eSpark-Backup/christian-raun-ethercat-design/Documents/Dev-Files/Blueprint/Reference Block Diagram.jpg

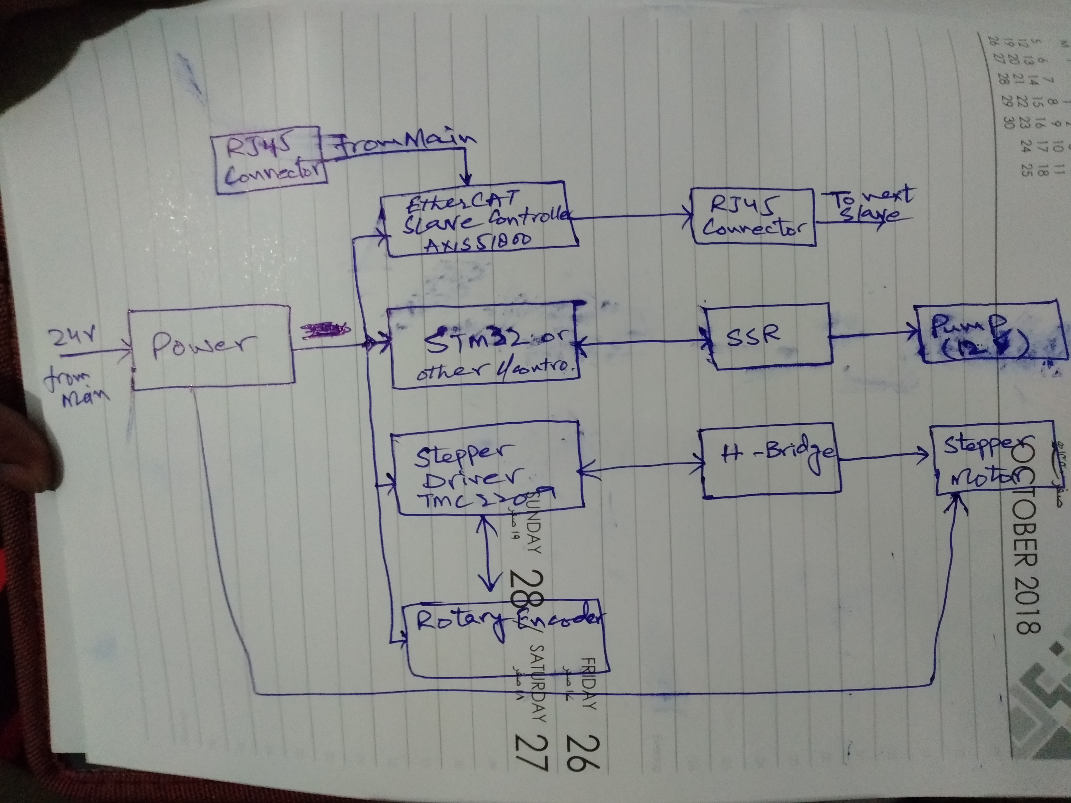
Documents/Dev-Files/Blueprint/Reference Block Diagram.jpg
