eSpark-Backup/christian-raun-ethercat-design/Deliverables/Control_Board/Renderings/3D_Top_View.PNG

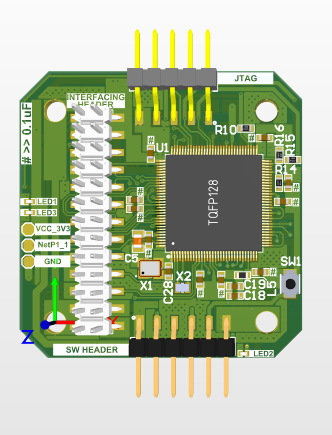
Deliverables/Control_Board/Renderings/3D_Top_View.PNG
