eSpark-Backup/christian-raun-ethercat-design/README.md

# ChrisitanRaun-AnnanasMotor
 To modify existing STM32 CAN Bus Stepper Control Firmware from Annanas Stepper Motor Design

 ## Board Status Document
 https://docs.google.com/spreadsheets/d/1jbGswmWFq8PR_c_Gmjap0uz8ZMgcLZeeRxeEXOKYWH0/edit#gid=0
