eSpark-Backup/christian-raun-ethercat-design/Documents/Dev-Files/Library Design Notes.txt

VKME1452A101MV 3D body required.
Diode 3D body remaining (download issue) resolved
