eSpark-Backup/christian-raun-ethercat-design/Documents/PCB review_ControlBoard/PCB Review_Mars_3-10-2021.docx

Issue No. 1:

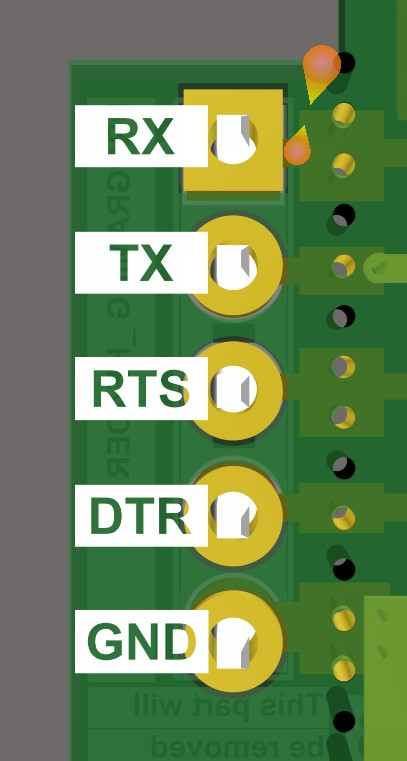
[picture p6: figure]

Reduce size of text as it is overlapping on copper are of pads of header. See attached image.

Issue No. 2:

Reduce the size of logo. See highlighted area in below image.

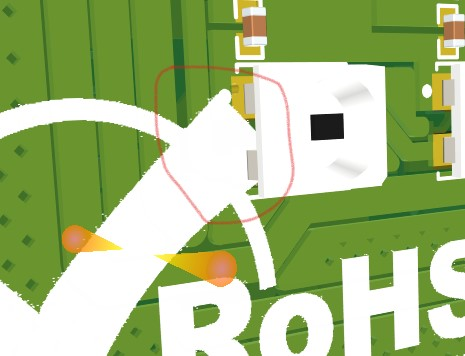
[picture p7: figure]

Issue No. 3:

Remove extra Mechanical layers (Mechanical 13 and Mechanical 15).
