eSpark-Backup/christian-raun-ethercat-design/Documents/Dev-Files/EtherCAT Based Servo Control System - Research.docx

# EtherCAT Based Servo Control System

# OVERVIEW of EtherCATP:

- EtherCAT is fully compliant with Ethernet standards, with 100Mbps transfer speed and good synchronization. It is widely used in the industrial field, such as the servo control system, robots, and numerical control machine tool. However, it has a high installation cost and poor reliability due to the usage of multiple power supplies and communication cables.
- The EtherCAT P technology is an addition to EtherCAT, which can enable the standard 4-wire Ethernet cable to transmit not only data but also two electrically isolated power supplies.
- It consists of two isolated power supplies; the system control power supply Us and the peripheral actuator power supply. Nominal voltage is 24V and current can be up to 3A.
- It is different from the Power over Ethernet (PoE), where only one voltage can be transmitted. Two separate power voltages can improve the safety of the system, which is good for industrial applications.
- EtherCAT slaves need specialized EtherCAT slave controllers (ESC), such as ET1100 and LAN9252.

The physical layer can use standard Ethernet devices directly. For example, the transport medium usually uses class 5 UTP wires of the 100base-TX specification.

# Hardware Design:

- the hardware design of the physical layer of EtherCAT is the same as Ethernet physical layer structure, which consists of a network control transceiver, network transformer, and RJ45.
- The hardware design uses two 2nd order filter elements and isolation via ethernet transformer.
- Main parts of the hardware include
1. EtherCAT Section
2. Control Section
3. Drive Section

# Components:

- MagJack: HY931147C $3.15,

48F-03GYD2NL: $2.6

HR915310A: $1.6

- Ethernet Transceiver: LAN8700C-AEZG-TR

DP83822HRHBR: $5.3

- TMC8462 EtherCAT slave controller IC with EtherCAT P
- Motion controller TMC4361
- MCU
- Stepper driver TMC5130 (with integrated MOSFET driver stage)

IR2102SPBF: Half-Bridge Gate Driver IC

- EtherCAT P M8 connectors for EtherCAT LINK IN and LINK OUT connection.
- single SPI isolator IC for isolation between system and driver part
- Encoder feedback
- EEPROM: CAT24C256WI-GT3: $0.3
- Optocoupler for isolation between control and drive circuit: HCPL-4504-500E https://www.lcsc.com/product-detail/SMD-Optocouplers_AVAGO_HCPL-4504-500E_HCPL-4504-500E_C17130.html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

# Reference link:

- https://www.researchgate.net/publication/351994896_Design_of_the_Servo_Control_System_Based_on_EtherCAT_P
- https://www.ti.com/lit/an/spracm9b/spracm9b.pdf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
- https://iopscience.iop.org/article/10.1088/1742-6596/1924/1/012009/pdf
- https://training.ti.com/ethercat-protocol-ethercat-slave-overview
- https://www.ti.com/tool/TIDA-00299
- https://www.ti.com/tool/TIDM-02006
- https://www.trinamic.com/support/help-center/reference-designs/tmc8462-with-ethercat-p/
- Hardware Data Sheet ET1100: https://download.beckhoff.com/download/document/io/ethercat-development-products/ethercat_et1100_datasheet_v1i9.pdf
- › XMC4800 family of MCU: price on digikey $26

https://www.infineon.com/dgdl/Infineon-Peripheral+-+EtherCAT+Slave+Controller+(ECAT)-TR-v01_00-EN.pdf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

Kit: https://www.digikey.com/en/products/detail/infineon-technologies/KIT_XMC47_RELAX_V1/5725043

EtherCAT slave controller: https://www.microchip.com/en-us/product/LAN9252

# XMC4700:

- XMC4700 reference design
- KSZ8081RNDCA-TR: Ethernet transceiver $1.26
- Debugging header: FTSH-105-01-F-D-K $2.43
- Resources of KIT_XMC47_RELAX_V1 (https://www.infineon.com/cms/en/product/evaluation-boards/kit_xmc47_relax_v1/)
- XMC4700 Documents (https://www.infineon.com/cms/en/product/microcontroller/32-bit-industrial-microcontroller-based-on-arm-cortex-m/32-bit-xmc4000-industrial-microcontroller-arm-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)
- Infineon/mtb-example-xmc-ccu8-pwm-complementary (https://github.com/Infineon/mtb-example-xmc-ccu8-pwm-complementary)
- https://github.com/Infineon/mtb-example-xmc-empty-app

# Comparison Between AMIC And XMC

## AMIC:

- Up to 300-MHz Sitara™ ARM® Cortex® -A8 32-Bit RISC Processor
- Two MII Ethernet Ports that Support Industrial Ethernet, such as EtherCAT
- Up to Two USB 2.0 High-Speed DRD (DualRole Device) Ports With Integrated PHY
- Up to Two Industrial Gigabit Ethernet MACs (10,100, 1000 Mbps) Integrated Switch. Each MAC Supports MII, RMII, RGMII, and MDIO Interfaces
- Ethernet MACs and Switch Can Operate Independent of Other Functions
- Has 2 CAN, 6 UART, 3 I2C, 2 SPI and 4 banks of GPIO (each bank has 32 gpios), – Eight 32-Bit General-Purpose Timers, Three Enhanced High-Resolution PWM Modules
- 12-Bit Successive Approximation Register (SAR) ADC
- Available Package: – 324-Pin S-PBGA-N324 Package

## XMC:

- ARM Cortex-M4 processor core
- Ethernet MAC module capable of 10/100 Mbit/s transfer rates
- EtherCATSlave interface (ECAT) capable of 100 Mbit/s transfer rates with 2 MII ports, 8 Fieldbus Memory Management Units (FMMU), 8 Sync Manager, 64-bit distributed clocks
- Universal Serial Bus, USB 2.0 host, Full-Speed OTG, with integrated PHY
- Controller Area Network interface (MultiCAN), Full-CAN/Basic-CAN with 6 nodes, 256 message objects (MO), data rate up to 1 MBaud
- Six Universal Serial Interface Channels (USIC), providing 6 serial channels, usable as UART, double-SPI, quad-SPI, IIC, IIS and LIN interfaces
- Four Analog-Digital Converters (VADC) of 12-bit resolution, 8 channels each, with input out-of-range comparators

# Other MCU options:

AM3352BZCE30 $6-15 (different price on different sites)

R5F572MNDDBG#20 ($17-23)

LAN9255-I/ZMX019 (https://ww1.microchip.com/downloads/en/DeviceDoc/00003646B.pdf) ($17)

The LAN9255 is a System-In-Package (SIP) design that combines the Microchip LAN9253 2/3-port EtherCAT device controller with dual integrated Ethernet PHYs and the Microchip SAM E53J ARM Cortex-M4F MCU into a single 128- pin TQFP package.

EVAL board (https://www.microchip.com/en-us/products/high-speed-networking-and-video/ethernet/ethercat-slave-controllers)

file:///D:/eSpark/Docs/EVB-LAN9255-Users-Guide-50003106.pdf
