eSpark-Backup/christian-raun-ethercat-design/Documents/Dev-Files/Graphical outline.pdf

Flex Mold – Software Interface

Boot | Home | Projects

Settings

Accesories | Laser

Motors

Project A | Panel A
Project B | Panel A2

Vacuum

Power

Heater

Boot

# Flex Mold

### Grøn Innovation

Home

Top navigation bar

Side selection bar | Content

Home | Settings | Accesories Projects
System status | Machines information (Size, motor count, etc.)

Power status

Motor status

Emergency stop status

Vacuum status

Heater status

Laser status

Projects

Home | Settings | Accesories Projects

Project A

Project B

Project C

Panel A

Panel B

Panel C

Panel A

Motor max travel

Travel time – 1 min 20 sec Set new Travel time – seconds

Shape | Home Stop

Home | Settings | Accesories Projects

Size

Minimum Radius

Motor count

Parts produced

Time in operation

Machine info

Power status

Motor status

Vacuum status

Home | Settings | Accesories Projects

### 24 Volt power status

240 Volt power status

Machines information

Power status

Motor status

Vacuum status

Home | Settings | Accesories Projects

Motor count

Motor errors

Machines information

Power status

Motor status

Vacuum status

Home | Settings | Accesories Projects

Vacuum on/off

Vacuum pressure

Machines information

Power status

Motor status

Vacuum status

Home | Settings | Accesories Projects

Power on/off

Temperature current

Temperature set

Temperature time

Heater status

Laser status

Home | Settings | Accesories Projects

Laser on/off

Calibrate

Calibrate value

Callibration errors

Heater status

Laser status
