eSpark-Backup/christian-raun-ethercat-design/Deliverables/Control_Board/Renderings/2D_Bottom_View.PNG

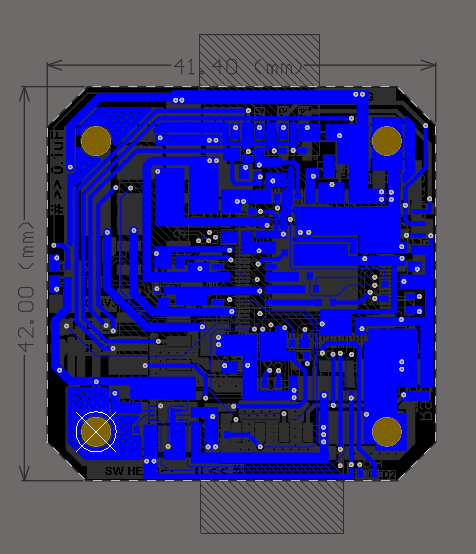
Deliverables/Control_Board/Renderings/2D_Bottom_View.PNG
