eSpark-Backup/christian-raun-ethercat-design/Deliverables/Control_Board/Renderings/2D_Top_View.PNG

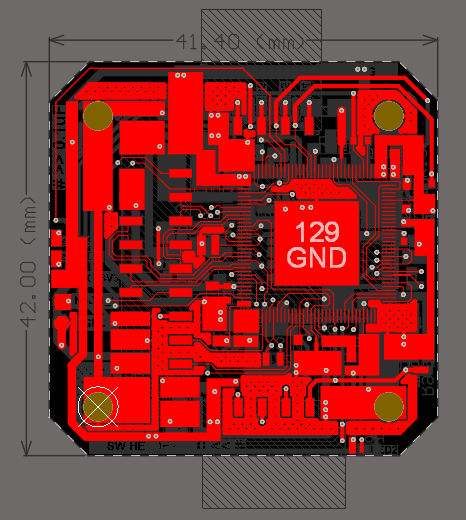
Deliverables/Control_Board/Renderings/2D_Top_View.PNG
