eSpark-Backup/christian-raun-ethercat-design/Deliverables/Control_Board/Renderings/3D_C_View.PNG

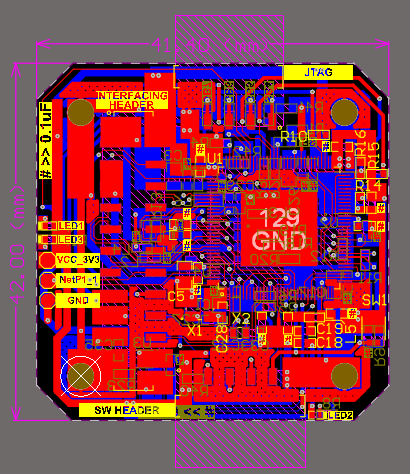
Deliverables/Control_Board/Renderings/3D_C_View.PNG
