eSpark-Backup/christian-raun-ethercat-design/Deliverables/Control_Board/Renderings/3D_Isometric_View.PNG

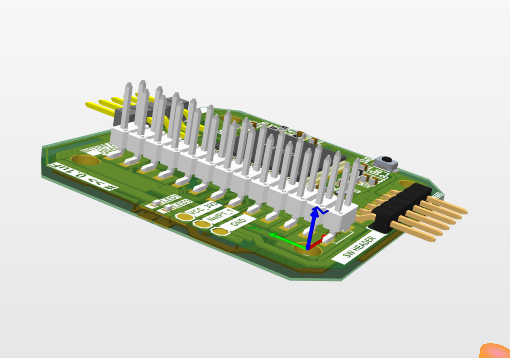
Deliverables/Control_Board/Renderings/3D_Isometric_View.PNG
