eSpark-Backup/christian-raun-ethercat-design/Deliverables/Interface_Board/Renderings/2D_Bottom_View.PNG

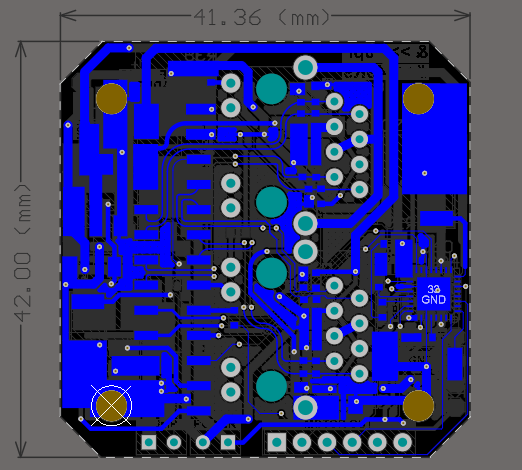
Deliverables/Interface_Board/Renderings/2D_Bottom_View.PNG
