eSpark-Backup/christian-raun-ethercat-design/Deliverables/Interface_Board/Renderings/3D_Bottom_View.PNG

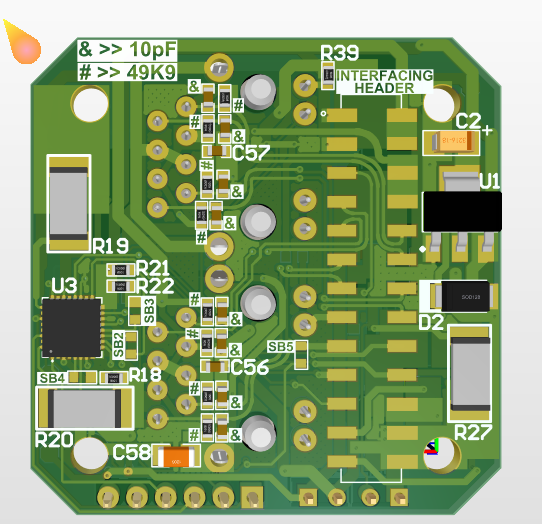
Deliverables/Interface_Board/Renderings/3D_Bottom_View.PNG
