eSpark-Backup/christian-raun-ethercat-design/Deliverables/Interface_Board/Renderings/3D_Top_View.PNG

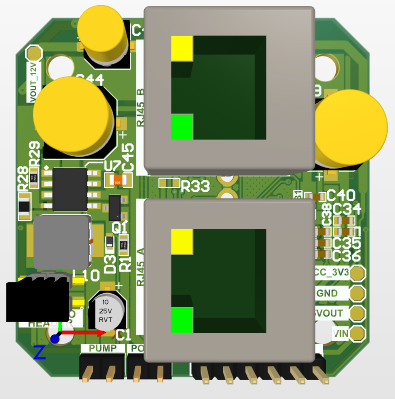
Deliverables/Interface_Board/Renderings/3D_Top_View.PNG
