eSpark-Backup/christian-raun-ethercat-design/Documents/Dev-Files/Blueprint/Blueprints Of Christian.jpg

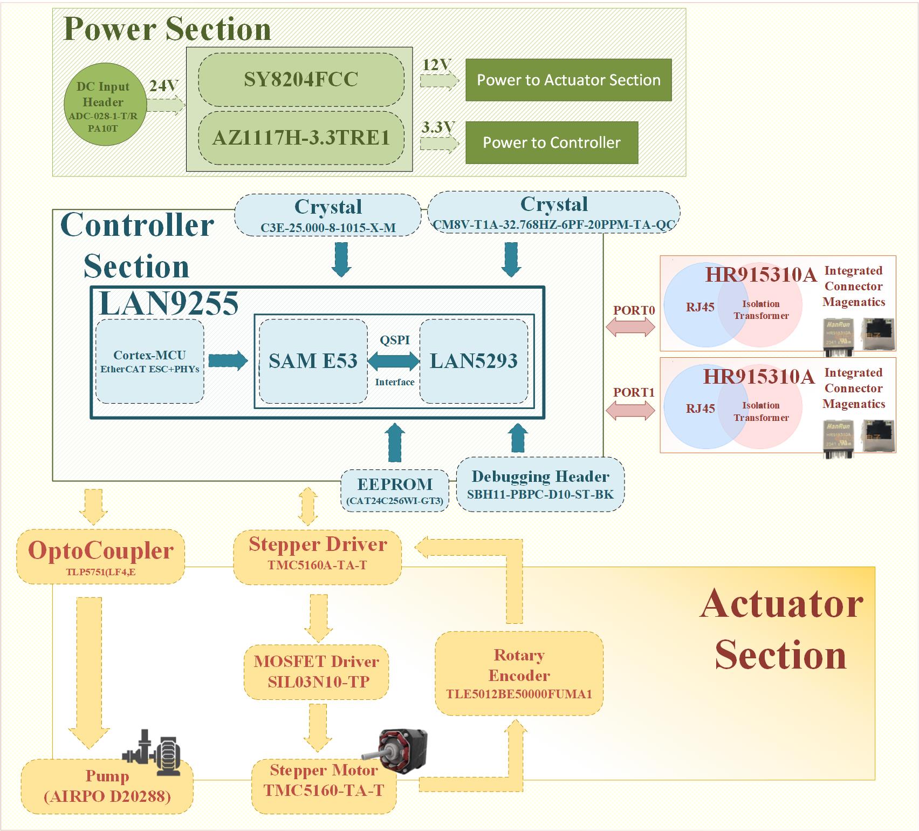
Documents/Dev-Files/Blueprint/Blueprints Of Christian.jpg
