eSpark-Backup/christian-raun-ethercat-design/Documents/PCB review_ControlBoard/1.jpg

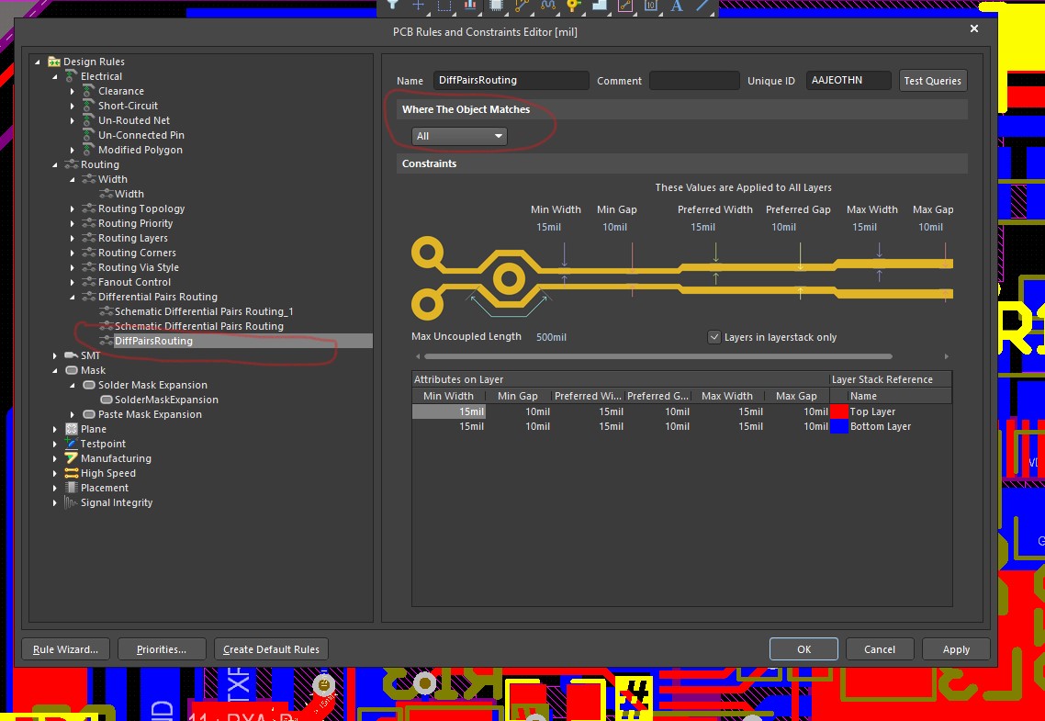
Documents/PCB review_ControlBoard/1.jpg
