eSpark-Backup/christian-raun-ethercat-design/Deliverables/BOM/Digikey_BOM.xlsx

Bill of Material (BOM) for Refrence Formate
S. No. | Components | Description | Designator | Footprint (Package) | Manufacturer Part Number | Manufacturer | Alternate | Value | Quantity 1 | Quantity (400) | Link | Unit Price (400) | Total Cost(400) | Remarks
1 | Capacitor | CAP CER 1UF 100V X7S 0805 | C1, C3, C5, C26, C45 | Cap0805 | GCM21BC72A105KE36L | Murata | -------- | 1uF | 5 | 2000 | Digikey (https://www.digikey.com/en/products/detail/murata-electronics/GCM21BC72A105KE36L/6606065) | $0.1415 | $283.0400
2 |  | CAP CER 0.1UF 100V X7R 0603 | C2, C4, C6, C7, C8, C9, C10, C11, C12, C13, C14, C15, C16, C20, C21, C22, C23, C24, C25, C30, C31, C34, C35, C37, C40, C41 | Cap0603 | CC0603KRX7R0BB104 | YAGEO | -------- | 0.1uF | 26 | 10400 | Digikey (https://www.digikey.com/en/products/detail/yageo/CC0603KRX7R0BB104/3476111) | $0.0327 | $340.5400
3 |  | CAP CER 10UF 50V X5R 0805 | C17 | Cap0805 | GRM21BR61H106ME43L | Murata | GRM21BR61H106KE43L | 10uF | 1 | 400 | Digikey (https://www.digikey.com/en/products/detail/murata-electronics/GRM21BR61H106KE43L/10326316) | $0.1587 | $63.4800
4 |  | CAP CER 4.7UF 25V X5R 0603 | C18, C19, C29, C39 | Cap0603 | C1608X5R1E475M080AC | TDK | -------- | 4.7uF | 4 | 1600 | Digikey (https://www.digikey.com/en/products/detail/tdk-corporation/C1608X5R1E475M080AC/3648583) | $0.0903 | $144.5120
5 |  | CAP CER 10PF 50V C0G/NP0 0603 | C27, C28, C32, C33, C48, C49, C50, C51, C52, C53, C54, C55 | Cap0603 | 06035A100JAT2A | KYOCERA AVX | -------- | 10pF | 12 | 4800 | Digikey (https://www.digikey.com/en/products/detail/kyocera-avx/06035A100JAT2A/563273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) | $0.0110 | $52.7400
6 |  | CAP CER 0.022UF 100V X7R 0603 | C36, C56, C57 | Cap0603 | CGA3E2X7R2A223K080AA | TDK | -------- | 22nF | 3 | 1200 | Digikey (https://www.digikey.com/en/products/detail/tdk-corporation/CGA3E2X7R2A223K080AA/2443292) | $0.0208 | $24.9960
7 |  | CAP CER 2.2UF 50V X5R 0603 | C38 | Cap0603 | UMK107BBJ225MA-T | Taiyo Yuden | -------- | 2.2uF | 1 | 400 | Digikey (https://www.digikey.com/en/products/detail/taiyo-yuden/UMK107BBJ225MA-T/7403937) | $0.1024 | $40.9600
8 |  | 25V 5mm 10mm 100uF 100kHz SMD,5x10mm Aluminum Electrolytic Cap- SMD ROHS | C43 | Custom | VKMB1001E101MV |  | -------- | 100uF | 1 | 400 |  |  | $0.0000
9 |  | 63V 10mm 8mm 100uF ±20% ,8x10mm Aluminum Electrolytic Cap | C44, C79 | Custom | VKMD1001J101MV |  |  | 100uF | 2 | 800 |  |  | $0.0000
10 |  | CAP ALUM 10uF 25V SMD | C46 | Custom | RVT1E100M0405 |  |  | 10uF | 1 | 400 |  |  | $0.0000
11 |  | 10V 22uF -55℃~+125℃ 6Ω 100kHz ±10% CASE-A_3216 Tantalum Capacitors ROHS | C47 | Cap Case-A | CA45A-A-10V-22uF-K |  |  | 22uF | 1 | 400 |  |  | $0.0000
12 |  | CAP CER 1000PF 2KV X7R 1206 | C58 | Cap1206 | CC1206KKX7RDBB102 | YAGEO | C1206C102MGRACTU | 1000pF | 1 | 400 | Digikey (https://www.digikey.com/en/products/detail/kemet/C1206C102MGRACTU/1090964) | $0.3572 | $142.8800
13 | Diode | 36V 40V Unidirectional 75V 5A SOD-323 TVS ROHS | D1 | SOD-323 | SD36 |  |  | ----- | 1 | 400 |  |  | $0.0000
14 |  | DIODE SCHOTTKY 30V 3A CFP5 | D2 | SOD-128 | PMEG3030EP,115 | Nexperia | ---------- | ----- | 1 | 400 | Digikey (https://www.digikey.com/en/products/detail/nexperia-usa-inc/PMEG3030EP-115/2228693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) | $0.3077 | $123.0800
15 |  | SOD-523 Schottky Barrier Diodes (SBD) ROHS | D3 |  | MSK4010 |  |  | ----- | 1 | 400 |  |  | $0.0000
16 | Mosfet | MOSFET N-CH 20V 4.2A SOT23 | Q1 | SOT-23 | IRLML2502TRPBF | INFINEON | ---------- | ----- | 1 | 400 | Element 14 (https://sg.element14.com/infineon/irlml2502pbf/mosfet-n-chan-20v-4-2a-sot-23/dp/9102981?CMP=GRHB-OCTOPART) | $0.5992 | $239.6800
17 | LED | Green 520~535nm 0402 Light Emitting Diodes (LED) RoHS | LED1, LED2 | LED 0402 | 16-213/GHC-YR1S1/3T | QT Brightek | QBLP595-IG-2897 | ----- | 2 | 800 | Digikey (https://www.digikey.com/en/products/detail/qt-brightek-qtb/QBLP595-IG-2897/14664264) | $0.1128 | $90.2240
18 | Inductor | 200Ω @ 100MHz 1 1A 300mΩ 0603 Ferrite Beads | L1, L2, L3, L4, L5 | Ind 0603 | MLB1608-201P1A(f) | Würth Elektronik | 742792651 | ----- | 5 | 2000 | Digikey (https://www.digikey.com/en/products/detail/w%C3%BCrth-elektronik/742792651/1638997) | $0.1340 | $268.0000
19 |  | IND SMD 10uH 500mA 0805 | L6 | Ind0805 | MGFL2012F100MT-LF |  |  | ----- |  | 400 |  |  | $0.0000
20 |  | FIXED IND 33UH 2.5A 189.2MOHM SM | L10 | Custom | ETQ-P4M330YFN | Panasonic | ---------- | ----- | 1 | 400 | Mouser (https://eu.mouser.com/ProductDetail/Panasonic/ETQ-P4M330YFN) | $0.9410 | $376.4000
21 | Resistor | RES SMD 10K OHM 5% 1/10W 0603 | R1, R2, R3, R4, R5, R9, R14, R15, R16, R18, R23, R24, R25, R41, R42 | Res0603 | AC0603JR-0710KL | YAGEO | ---------- | 10K | 15 | 600 | Digikey (https://www.digikey.com/en/products/detail/yageo/AC0603JR-0710KL/2827830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) | $0.0097 | $5.8200
22 |  | RES SMD 0603 33 Ohm 1% 1/10W | R6, R11, R12 | Res0603 | RC0603FR-0733RL | YAGEO | RMCF0603FT33R0 | 33R | 3 | 1200 | Digikey (https://www.digikey.com/en/products/detail/stackpole-electronics-inc/RMCF0603FT33R0/1760804) | $0.0031 | $3.6600
23 |  | RES SMD 330R 100 mW 0603 | R7, R36, R39 | Res0603 | RC0603JR-07330RL | YAGEO | ---------- | 330R | 3 | 1200 | Digikey (https://www.digikey.com/en/products/detail/yageo/RC0603JR-07330RL/726769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) | $0.0036 | $4.3200
24 |  | RES SMD 1K OHM 1% 1/10W 0603 | R8, R10, R21, R22, R29, R40 | Res0603 | RC0603FR-071KL | YAGEO | ---------- | 1K | 6 | 2400 | Digikey (https://www.digikey.com/en/products/detail/yageo/RC0603FR-071KL/726843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) | $0.0044 | $10.4640
25 |  | RES SMD 12.1K OHM 1/10W 0603 | R13 | Res0603 | RT0603CRD0712K1L | Stackpole | ---------- | 12.1K | 1 | 400 | Digikey (https://www.digikey.com/en/products/detail/stackpole-electronics-inc/RMCF0603FT12K1/1761240) | $0.0068 | $2.7200
26 |  | RES SMD ±5% ±200ppm/℃ 0.18Ω 1W 2512 | R19, R20 | RES 2512 | RTT25R18JTE | TE Connectivity | RL73H3AR18FTE | 180m | 2 | 800 | Digikey (https://www.digikey.com/en/products/detail/te-connectivity-passive-product/RL73H3AR18FTE/5588302) | $0.2003 | $160.2560
27 |  | RES 0.075 OHM 1% 2W 2512 | R27 | RES 2512 | CSRN2512FK75L0 | Stackpole | ---------- | 75m | 1 | 400 | Digikey (https://www.digikey.com/en/products/detail/stackpole-electronics-inc/CSRN2512FK75L0/1646109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) | $0.2150 | $86.0000
28 |  | RES SMD 9kΩ ±100ppm/℃ 0.125W 0805 | R28 | Cap0805 | 0805W8F9001T5E |  |  | 9K | 1 | 400 |  |  | $0.0000
29 |  | Res Thick Film 1.6 x 0.8 mm 49.9K Ohm 1% 0.1W(1/10W) 100ppm/ C Molded SMD Paper T/R | R30, R31, R32, R33, R34, R35, R37, R38 | Res0603 | RC0603FR-0749K9L | Stackpole | RMCF0603FG49K9 | 49K9 | 8 | 3200 | Digikey (https://www.digikey.com/en/products/detail/stackpole-electronics-inc/RMCF0603FG49K9/1714078) | $0.0026 | $8.4480
30 | Switch | SWITCH TACTILE SPST-NO 0.05A 12V | SW1 | Custom | B3U-1000P |  |  |  | 1 | 400 |  |  | $0.0000
31 | Ics | IC ETHERCAT SLAVE CONTROLLER | U1 |  | LAN9255/ZMX019 |  |  |  | 1 | 900 |  |  | $0.0000
32 |  | IC EEPROM 256KBIT I2C 1MHZ 8SOIC | U2 | 8-SOIC | CAT24C256WI-GT3 | onsemi | ---------- | ----- | 1 | 400 | Quest Component (https://www.questcomp.com/shopping/shoppingcart.aspx) | $0.1680 | $67.2000
33 |  | Stepper Motor Driver/Controller, 5V to 36V, 1 to 256 Microsteps, 1.2A, QFN-32 | U3 | 32-QFN (5x5) | TMC2202-WA-T | Trinamic | ---------- | ----- | 1 | 400 | Mouser (https://eu.mouser.com/ProductDetail/Trinamic/TMC2202-WA-T) | $2.0100 | $804.0000
34 |  | MAGNETIC ANGLE SENSOR | U4 | 8-SOIC | TLE5012BE5000FUMA1 | Infineon | ---------- | ----- | 1 | 400 | Avnet (https://www.avnet.com/shop/us/products/infineon/tle5012be5000fuma1-3074457345639706863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) | $2.5160 | $1006.4000
35 |  | IC TRANSLATION TXRX 5.5V 24TSSOP | U5 | 24-TSSOP | SN74LVCH8T245PWR | Texas | ---------- | ----- | 1 | 400 | Digikey (https://www.digikey.com/en/products/detail/texas-instruments/SN74LVCH8T245PWR/1216675) | $1.0233 | $409.3120
36 |  | 2A 40V SOIC-8_EP_150mil DC-DC Converters ROHS | U7 |  | XL4001E1 | ---------- | ---------- | ----- | 1 | 400 | Alibaba (https://www.alibaba.com/product-detail/New-Integrated-Circuit-XL4001E1-in-stock_1600251950180.html) | $2.4500 | $980.0000
37 |  | 15V 1.3V @ 800mA Fixed 3.3V SOT-223 Linear Voltage Regulators (LDO) ROHS | U8 |  | AZ1117CH-3.3TRG1 |  |  |  | 1 | 400 |  |  | $0.0000
38 | Crystal | CRYSTAL 25.0000MHZ 8PF SMD | X1 |  | C3E-25.000-8-1015-X-M |  |  |  | 1 | 400 |  |  | $0.0000
39 |  | Crystal 32.768KHZ 6.0PF SMD | X2 |  | CM8V-T1A-32.768KHZ-6PF-20PPM-TA-QC |  |  |  | 1 | 400 |  |  | $0.0000
40 |  | CONN HEADER VERT 10POS 2.54MM | P2 | HDR2X5 | 67997-410HLF | Amphenol | ---------- | ----- | 1 | 400 | Digikey (https://www.digikey.com/en/products/detail/amphenol-icc-fci/67997-410HLF/1878475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) | $0.2158 | $86.3200
42 | Connector | CONN HEADER VERT 2POS 2.54MM | P12, P15 | HDR1X2 | 826629-2 | TE Connectivity | ---------- | ----- | 2 | 800 | Digikey (https://www.digikey.com/en/products/detail/te-connectivity-amp-connectors/826629-2/1130753) | 0.27306 | $218.4480
43 |  | 2.54mm Straight 1 Header TH ,P=2.54mm Pin Headers ROHS | P13 | HDR1X5 | MTP125-1105S1 | Wurth Elektronik | 61300511121 |  | 1 | 400 | Mouser (https://eu.mouser.com/ProductDetail/Wurth-Elektronik/61300511121) | $0.2600 | $104.0000
44 |  | Solder Bridge ON | SB1, SB2, SB3, SB4, SB5, SB6, SB7 | Solder Bridge | Solder Bridge |  |  |  | 7 | 2800 |  |  | $0.0000
45 |  | Test Point ON | P1, P3, P4, P5, P6, P7 | TEST POINT | TEST POINT |  |  |  | 6 | 2400 |  |  | $0.0000
