eSpark-Backup/christian-raun-ethercat-design/Deliverables/Control_Board/BOM/LCSC_CB_ 500.xlsx

Bill of Material (BOM) for Controller Board
S. No. | Components | Description | Designator | Footprint (Package) | Manufacturer Part Number | Manufacturer | LCSC Part No | Alternate | Value | LCSC/MOQ (1000) | LCSC/MOQ (500) | Quantity (Per Board) | Quantity 500 | Quantity 1000 | Link | Unit Cost(1) | Total Cost(1) | Unit Cost(500) | MOQ Total 500 | Unit Cost(1000) | MOQ Total 1000 | Remarks | Quotation of orignal parts from Chinese supplier
1 | Capacitor | CAP CER 1UF 100V X7S 0805 | C1, C3, C5, C26 | Cap0805 | GCM21BC72A105KE36L | Murata | C2842838 | ------------ | 1uF | 4050 | 2050 | 4 | 2000 | 4000 | LCSC (https://www.lcsc.com/product-detail/old-batch_Murata-Electronics-GCM21BC72A105KE36L_C2842838.html) | $0.0682 | $0.2728 | $0.0682 | $139.8100 | $0.0682 | $276.2100
2 |  | CAP CER 0.1UF 100V X7R 0603 | C2, C4, C6, C7, C8, C9, C10, C11, C12, C13, C14, C15, C16, C20, C21, C22, C23, C24, C25, C30, C31, C34, C35, C41 | Cap0603 | CC0603KRX7R0BB104 | YAGEO | C113803 | ------------ | 0.1uF | 24050 | 12050 | 24 | 12000 | 24000 | LCSC (https://www.lcsc.com/product-detail/Multilayer-Ceramic-Capacitors-MLCC-SMD-SMT_YAGEO-CC0603KRX7R0BB104_C113803.html) | $0.0079 | $0.1896 | $0.0051 | $61.4550 | $0.0051 | $122.6550
3 |  | CAP CER 10UF 50V X5R 0805 | C17 | Cap0805 | ~~GRM21BR61H106ME43L~~ | Murata | C440198 | GRM21BR61H106KE43L | 10uF | 1050 | 550 | 1 | 500 | 1000 | LCSC (https://www.lcsc.com/product-detail/Multilayer-Ceramic-Capacitors-MLCC-SMD-SMT_Murata-Electronics-GRM21BR61H106KE43L_C440198.html) | $0.1052 | $0.1052 | $0.0670 | $36.8500 | $0.0670 | $70.3500
4 |  | CAP CER 4.7UF 25V X5R 0603 | C18, C19, C29 | Cap0603 | ~~C1608X5R1E475M080AC~~ | TDK | C76615 | C1608X5R1E475KT000E | 4.7uF | 3050 | 1550 | 3 | 1500 | 3000 | LCSC (https://www.lcsc.com/product-detail/Multilayer-Ceramic-Capacitors-MLCC-SMD-SMT_TDK-C1608X5R1E475KT000E_C76615.html) | $0.03470 | $0.1041 | $0.0216 | $33.4800 | $0.0216 | $65.8800
5 |  | CAP CER 10PF 50V C0G/NP0 0603 | C27, C28, C32, C33 | Cap0603 | ~~06035A100JAT2A~~ | KYOCERA AVX | C106245 | CC0603JRNPO9BN100 | 10pF | 4100 | 2100 | 4 | 2000 | 4000 | LCSC (https://www.lcsc.com/product-detail/Multilayer-Ceramic-Capacitors-MLCC-SMD-SMT_YAGEO-CC0603JRNPO9BN100_C106245.html) | $0.0025 | $0.0100 | $0.0019 | $3.9900 | $0.0018 | $7.3800
6 | LED | Green 520~535nm 0402 Light Emitting Diodes (LED) RoHS | LED1, LED2,LED3 | LED 0402 | 16-213/GHC-YR1S1/3T | Everlight Elec | C74338 | ------------ | ----- | 3050 | 1550 | 3 | 1500 | 3000 | LCSC (https://www.lcsc.com/product-detail/Light-Emitting-Diodes-LED_Everlight-Elec-16-213-GHC-YR1S1-3T_C74338.html) | $0.0681 | $0.2043 | $0.0457 | $70.8350 | $0.0457 | $139.3850
7 | Inductor | 200Ω @ 100MHz 1 1A 300mΩ 0603 Ferrite Beads | L1, L2, L3, L4, L5 | Ind 0603 | MLB1608-201P1A(f) | Meled | C45316 | ------------ | ----- | 5050 | 2550 | 5 | 2500 | 5000 | LCSC (https://www.lcsc.com/product-detail/Ferrite-Beads_Meled-MLB1608-201P1A-f_C45316.html) | $0.0070 | $0.0350 | $0.0050 | $12.7500 | $0.0047 | $23.7350
8 |  | IND SMD 10uH 500mA 0805 | L6 | Ind0805 | MGFL2012F100MT-LF | microgate | C281113 | ------------ | ----- | 1050 | 550 | 1 | 500 | 1000 | LCSC (https://www.lcsc.com/product-detail/Inductors-SMD_microgate-MGFL2012F100MT-LF_C281113.html) | $0.0458 | $0.0458 | $0.0341 | $18.7550 | $0.0322 | $33.8100
9 | Resistor | RES SMD 10K OHM 5% 1/10W 0603 | R1, R2, R3, R4, R5, R9, R14, R15, R16, R23, R41, R42 | Res0603 | AC0603JR-0710KL | YAGEO | C140867 | ------------ | 10K | 12100 | 6100 | 12 | 6000 | 12000 | LCSC (https://www.lcsc.com/product-detail/Chip-Resistor-Surface-Mount_YAGEO-AC0603JR-0710KL_C140867.html) | $0.0014 | $0.0168 | $0.0010 | $6.1000 | $0.0009 | $10.8900
10 |  | RES SMD 0603 33 Ohm 1% 1/10W | R6, R11, R12 | Res0603 | RC0603FR-0733RL | YAGEO | C108661 | ------------ | 33R | 3100 | 1600 | 3 | 1500 | 3000 | LCSC (https://www.lcsc.com/product-detail/Chip-Resistor-Surface-Mount_YAGEO-RC0603FR-0733RL_C108661.html) | $0.0014 | $0.0042 | $0.0010 | $1.6000 | $0.0009 | $2.7900
11 |  | RES SMD 330R 100 mW 0603 | R7 | Res0603 | RC0603JR-07330RL | YAGEO | C105879 | ------------ | 330R | 1100 | 600 | 1 | 500 | 1000 | LCSC (https://www.lcsc.com/product-detail/Chip-Resistor-Surface-Mount_YAGEO-RC0603JR-07330RL_C105879.html) | $0.0014 | $0.0014 | $0.0014 | $0.8400 | $0.0011 | $1.2100
12 |  | RES SMD 1K OHM 1% 1/10W 0603 | R8, R10, R40,R17 | Res0603 | RC0603FR-071KL | YAGEO | C22548 | ------------ | 1K | 4100 | 2100 | 4 | 2000 | 4000 | LCSC (https://www.lcsc.com/product-detail/Chip-Resistor-Surface-Mount_YAGEO-RC0603FR-071KL_C22548.html) | $0.0012 | $0.0048 | $0.0009 | $1.8900 | $0.0009 | $3.6900
13 |  | RES SMD 100 OHM 1% 1/10W 0603 | R18, R19 | Res0603 | RC0603FR-07100RL | YAGEO | C105588 | ------------ | 100R | 2100 | 1100 | 2 | 1000 | 2000 | LCSC (https://lcsc.com/product-detail/Chip-Resistor-Surface-Mount_YAGEO-RC0603FR-07100RL_C105588.html) | $0.0012 | $0.0024 | $0.0009 | $0.9900 | $0.0009 | $1.8900
14 |  | RES SMD 470 OHM 1% 1/10W 0603 | R20 | Res0603 | RC0603FR-07470RL | YAGEO | C114669 | ------------ | 470R | 1100 | 600 | 1 | 500 | 1000 | LCSC (https://lcsc.com/product-detail/Chip-Resistor-Surface-Mount_YAGEO-RC0603FR-07470RL_C114669.html) | $0.0015 | $0.0015 | $0.0015 | $0.9000 | $0.0012 | $1.3200
15 |  | RES SMD 12.1K OHM 1/10W 0603 | R13 | Res0603 | RT0603CRD0712K1L | Stackpole | C705893 | ------------ | 12.1K | 1040 | 540 | 1 | 500 | 1000 | LCSC (https://www.lcsc.com/product-detail/Chip-Resistor-Surface-Mount_YAGEO-RT0603CRD0712K1L_C705893.html) | $0.0137 | $0.0137 | $0.0106 | $5.7240 | $0.0100 | $10.4000
16 | Switch | SWITCH TACTILE SPST-NO 0.05A 12V | SW1 | Custom | B3U-1000P | Omron | ------------ | ------------ | ----- | 1050 | 550 | 1 | 500 | 1000 | LCSC (https://www.lcsc.com/product-detail/span-style-background-color-ff0-Tactile-span-Switches_G-span-style-background-color-ff0-Switch-span-GT-TC026B-H015-L1_C778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) | $0.0855 | $0.0855 | $0.0481 | $26.4550 | $0.0481 | $50.5050
17 | Ics | IC ETHERCAT SLAVE CONTROLLER | U1 | 128-TQFP (14x14) | LAN9255/ZMX019 | Microchip | -------- | ---------- | ----- | 1010 | 510 | 1 | 500 | 1000 | Custom supplier | $21.26 | $21.2600 | $21.26 | $10842.6000 | $21.26 | $21472.6000
18 |  | IC EEPROM 256KBIT I2C 1MHZ 8SOIC | U2 | 8-SOIC | CAT24C256WI-GT3 | onsemi | ------------ | ------------ | ----- | 1010 | 510 | 1 | 500 | 1000 | Chipmall (https://www.chipmall.com/product_detail/ON-Semiconductor/EEPROM/CAT24C256WI-GT3_8340.html) | $0.3524 | $0.3524 | $0.2872 | $146.4572 | $0.2872 | $290.0427
19 |  | MAGNETIC ANGLE SENSOR | U4 | 8-SOIC | TLE5012BE5000FUMA1 | Infineon | ------------ | ------------ | ----- | 1010 | 510 | 1 | 500 | 1000 | Aliexpress (https://www.aliexpress.com/item/33051187576.html?pdp_ext_f=%7B%22sku_id%22%3A%2267477268699%22%7D) | $2.78 | $2.7840 | $2.7840 | $1419.8400 | $2.7840 | $2811.8400 | MOQ=10 | $1.19
20 |  | IC TRNSLTR BIDIRECTIONAL US8 | U3 | 8-VSSOP | TXB0102DCUT | Texas | C2677366 | ------------ | ----- | 1010 | 510 | 1 | 500 | 1000 | Aliexpress (https://www.aliexpress.com/item/4000809540773.html) | $0.4000 | $0.4000 | $0.4000 | $204.0000 | $0.4000 | $404.0000 | MOQ=10 | $0.79
21 | Crystal | CRYSTAL 25.0000MHZ 8PF SMD | X1 | Custom | ~~C3E-25.000-8-1015-X-M~~ | Aker Technology | C390774 | S3225000201060 |  | 1020 | 520 | 1 | 500 | 1000 | LCSC (https://lcsc.com/product-detail/Crystals_JGHC-S3225000201060_C390774.html) | $0.1077 | $0.1077 | $0.0636 | $33.0720 | $0.0636 | $64.8720 |  | Out of stock on custom supplier. Alternate added
22 |  | Crystal 32.768KHZ 6.0PF SMD | X2 | Custom | CM8V-T1A-32.768KHZ-6PF-20PPM-TA-QC | -------- | ------------ | -------- | ---- | 1020 | 520 | 1 | 500 | 1000 | Custom supplier | $0.87 | $0.8662 | $0.87 | $450.4240 | $0.87 | $883.5240
23 | Connector | 5 POS 2.54mm Pin Header Male single row Right Angle SMD | J1 | HDR1X5 SMD | PH254P1x12SMRA-100 | RTLECS | -------- | ------------ | ---- | 140 | 70 | 1 | 500 | 1000 | Aliexpress (https://www.aliexpress.com/item/32739653845.html?pdp_ext_f=%7B%22sku_id%22%3A%2261529845100%22%7D) | $0.4800 | $0.4800 | $0.4800 | $33.6000 | $0.4800 | $67.2000 | Each 40 header will have 8 pieces. 70*8=560 pieces.
24 |  | 6 POS 2.54mm Pin Header Male single row Right Angle SMD | J2 | HDR1X6 SMD | PH254P1x12SMRA-100_1 | RTLECS | -------- | ---------- | ---- | 180 | 90 | 1 | 500 | 1000 | Aliexpress (https://www.aliexpress.com/item/32739653845.html?pdp_ext_f=%7B%22sku_id%22%3A%2261529845100%22%7D) | $0.4800 | $0.4800 | $0.4800 | $43.2000 | $0.4800 | $86.4000
25 |  | CONN HEADER SMD 26POS 2.54MM | J3 | Custom | 95278-101A26LF | Amphenol | ------- | ----------- | ---- | 1020 | 520 | 1 | 500 | 1000 | Aliexpress (https://www.aliexpress.com/item/32724713249.html) | $0.4500 | $0.4500 | $0.4500 | $234.0000 | $0.4500 | $459.0000 | For 540 pieces of 6 pin header
26 |  | ~~Solder Bridge ON~~ | ~~SB1, SB4, SB5, SB6, SB7~~ | ~~Solder Bridge~~ | ~~Solder Bridge~~ | ~~-----------~~ | ~~-----------~~ | ~~-----------~~ | ~~--------~~ | ~~-----------~~ | ~~-----------~~ | 5 | 2500 | 5000 | ~~-----------~~ | ~~-----------~~ | ~~-----------~~ | ~~-----------~~ | ~~-----------~~ |  |  | ~~DO NOT Mount~~
27 |  | ~~Test Point ON~~ | ~~P1,P5,P6~~ | ~~TEST POINT~~ | ~~TEST POINT~~ | ~~-----------~~ | ~~-----------~~ | ~~-----------~~ | ~~--------~~ | ~~-----------~~ | ~~-----------~~ | 3 | 1500 | 3000 | ~~-----------~~ | ~~-----------~~ | ~~-----------~~ | ~~-----------~~ | ~~-----------~~ |  |  | ~~DO NOT Mount~~
 |  |  |  |  |  |  |  |  |  |  |  | Total Component Cost |  |  |  |  | $28.2774 |  | $13829.62 |  | $27361.58
 |  |  |  |  |  |  |  |  |  |  |  | Single Board Cost |  |  |  |  |  |  | $27.66 |  | $27.36
 |  |  |  |  |  |  |  |  |  |  |  |  | Aliexpress Shipping |  |  |  |  |  | 216.17 |  | 203.04
 |  |  |  |  |  |  |  |  |  |  |  |  | Total with Shipping |  |  |  |  |  | $14045.79 |  | $27577.75
