eSpark-Backup/christian-raun-ethercat-design/Deliverables/Interface_Board/BOM/LCSC_Interface_Board-500-100.xlsx

Bill of Material (BOM) for Interface_Board
S. No. | Components | Description | Designator | Footprint (Package) | Manufacturer Part Number | Manufacturer | LCSC Part No | Alternate | Value | LCSC/MOQ (500) | LCSC/MOQ (1000) | Quantity (Per Board) | Quantity 500 | Quantity 1000 | Link | Unit Cost(1) | Total Cost (1) | Unit Cost(500) | Total Cost (500) | Unit Cost(1000) | Total Cost (1000) | Remarks
1 | Capacitor | CAP CER 0.1UF 100V X7R 0603 | C34, C35, C37, C40 | Cap0603 | CC0603KRX7R0BB104 | Yageo | C113803 | ------------ | 0.1uF | 2300 | 4200 | 4 | 2000 | 4000 | LCSC (https://lcsc.com/product-detail/Multilayer-Ceramic-Capacitors-MLCC-SMD-SMT_YAGEO-CC0603KRX7R0BB104_C113803.html) | $0.0079 | $0.0316 | $0.0054 | $12.4200 | $0.0054 | $22.6800
2 |  | CAP CER 1UF 100V X7S 0805 | C45 | Cap0805 | GCM21BC72A105KE36L | Murata | C2842838 | ------------ | 1uF | 550 | 1100 | 1 | 500 | 1000 | LCSC (https://lcsc.com/product-detail/old-batch_Murata-Electronics-GCM21BC72A105KE36L_C2842838.html) | $0.0682 | $0.0682 | $0.0682 | $37.5100 | $0.0682 | $75.0200
3 |  | CAP CER 10PF 50V C0G/NP0 0603 | C48, C49, C50, C51, C52, C53, C54, C55 | Cap0603 | ~~06035A100JAT2A~~ | Kyocera AVX | C525235 | FN18N100J500PSG | 10pF | 4100 | 8200 | 8 | 4000 | 8000 | LCSC (https://lcsc.com/product-detail/Multilayer-Ceramic-Capacitors-MLCC-SMD-SMT_PSA-Prosperity-Dielectrics-FN18N100J500PSG_C525235.html) | $0.0031 | $0.0248 | $0.0021 | $8.6100 | $0.0021 | $17.2200
4 |  | CAP CER 0.022UF 100V X7R 0603 | C36, C56, C57 | Cap0603 | ~~CGA3E2X7R2A223K080AA~~ | TDK | C21122 | CL10B223KB8NNNC | 22nF | 1600 | 3200 | 3 | 1500 | 3000 | LCSC (https://www.lcsc.com/product-detail/Multilayer-Ceramic-Capacitors-MLCC-SMD-SMT_Samsung-Electro-Mechanics-CL10B223KB8NNNC_C21122.html) | $0.0053 | $0.0159 | $0.0038 | $6.0800 | $0.0038 | $12.1600
5 |  | CAP CER 2.2UF 50V X5R 0603 | C38 | Cap0603 | ~~UMK107BBJ225MA-T~~ | Taiyo Yuden | C268016 | UMK107BBJ225KA-T | 2.2uF | 550 | 1100 | 1 | 500 | 1000 | LCSC (https://www.lcsc.com/product-detail/Multilayer-Ceramic-Capacitors-MLCC-SMD-SMT_Taiyo-Yuden-UMK107BBJ225KA-T_C268016.html) | $0.0392 | $0.0392 | $0.0291 | $16.0050 | $0.0244 | $26.8400
6 |  | 25V 5mm 10mm 100uF 100kHz SMD,5x10mm Aluminum Electrolytic Cap- SMD ROHS | C43 | Custom | VKMB1001E101MV | Ymin | C487322 | ------------ | 100uF | 550 | 1100 | 1 | 500 | 1000 | LCSC (https://www.lcsc.com/product-detail/Aluminum-Electrolytic-Capacitors-SMD_Ymin-VKMB1001E101MV_C487322.html) | $0.0760 | $0.0760 | $0.0524 | $28.8200 | $0.0524 | $57.6400
7 |  | 63V 10mm 8mm 100uF ±20% ,8x10mm Aluminum Electrolytic Cap | C44, C79 | Custom | VKMD1001J101MV | Ymin | C487384 | ------------ | 100uF | 1050 | 2100 | 2 | 1000 | 2000 | LCSC (https://www.lcsc.com/product-detail/Aluminum-Electrolytic-Capacitors-SMD_Ymin-VKMD1001J101MV_C487384.html) | $0.1811 | $0.3622 | $0.1241 | $130.3050 | $0.1241 | $260.6100
8 |  | CAP ALUM 10uF 25V SMD | C1 | Custom | RVT1E100M0405 | Honor Elec | C3343 | ------------ | 10uF | 560 | 1100 | 1 | 500 | 1000 | LCSC (https://www.lcsc.com/product-detail/Aluminum-Electrolytic-Capacitors-SMD_Honor-Elec-RVT1E100M0405_C3343.html) | $0.0352 | $0.0352 | $0.0281 | $15.7360 | $0.0268 | $29.4800
9 |  | 10V 22uF ±10% CASE-A_3216 Tantalum Capacitors ROHS | C2 | Cap Case-A | CA45A-A-10V-22uF-K | CEC | C141745 | ------------ | 22uF | 550 | 1100 | 1 | 500 | 1000 | LCSC (https://www.lcsc.com/product-detail/Tantalum-Capacitors_CEC-Shenzhen-Zhenhua-XinYun-Elec-CA45A-A-10V-22uF-K_C141745.html) | $0.0958 | $0.0958 | $0.0625 | $34.3750 | $0.0625 | $68.7500
10 |  | CAP CER 1000PF 2KV X7R 1206 | C58 | Cap1206 | CC1206KKX7RDBB102 | YAGEO | C23631 | ------------ | 1000pF | 550 | 1100 | 1 | 500 | 1000 | LCSC (https://www.lcsc.com/product-detail/Multilayer-Ceramic-Capacitors-MLCC-SMD-SMT_YAGEO-CC1206KKX7RDBB102_C23631.html) | $0.0127 | $0.0127 | $0.0098 | $5.3900 | $0.0098 | $10.7800
11 | Diode | DIODE SCHOTTKY 30V 3A CFP5 | D2 | SOD-128 | PMEG3030EP,115 | Nexperia | C255587 | ------------ | ----- | 550 | 1100 | 1 | 500 | 1000 | LCSC (https://www.lcsc.com/product-detail/Schottky-Barrier-Diodes-SBD_Nexperia-PMEG3030EP-115_C255587.html) | $0.3172 | $0.3172 | $0.1925 | $105.8750 | $0.1894 | $208.3400
12 |  | SOD-523 Schottky Barrier Diodes (SBD) ROHS | D3 | SOD-523 | MSK4010 | Tak Cheong | C968723 | ------------ | ----- | 560 | 1100 | 1 | 500 | 1000 | LCSC (https://www.lcsc.com/product-detail/Schottky-Barrier-Diodes-SBD_Tak-Cheong-MSK4010_C968723.html) | $0.0266 | $0.0266 | $0.0203 | $11.3680 | $0.0191 | $21.0100
13 | Mosfet | MOSFET N-CH 20V 4.2A SOT23 | Q1 | SOT-23 | IRLML2502TRPBF | INFINEON | C2589 | ------------ | ----- | 550 | 1100 | 1 | 500 | 1000 | LCSC (https://lcsc.com/product-detail/MOSFETs_Infineon-Technologies-IRLML2502TRPBF_C2589.html) | $0.2127 | $0.2127 | $0.1242 | $68.3100 | $0.1220 | $134.2000
14 | Inductor | FIXED IND 33UH 2.5A 189.2MOHM SM | L10 | Custom | ETQ-P4M330YFN | Panasonic |  |  | ----- | 520 | 1050 | 1 | 500 | 1000 | Custom Supplier | $2.54 | $2.5400 | $2.54 | $1320.8000 | $2.54 | $2667.0000
15 | Resistor | RES SMD 10K OHM 5% 1/10W 0603 | R1,R18 | Res0603 | AC0603JR-0710KL | YAGEO | C140867 | ------------ | 10K | 1100 | 2200 | 2 | 1000 | 2000 | LCSC (https://www.lcsc.com/product-detail/Chip-Resistor-Surface-Mount_YAGEO-AC0603JR-0710KL_C140867.html) | $0.0014 | $0.0028 | $0.0011 | $1.2100 | $0.0011 | $2.4200
16 |  | RES SMD 330R 100 mW 0603 | R33, R39 | Res0603 | RC0603JR-07330RL | YAGEO | C105879 | ------------ | 330R | 1100 | 2200 | 2 | 1000 | 2000 | LCSC (https://www.lcsc.com/product-detail/Chip-Resistor-Surface-Mount_YAGEO-RC0603JR-07330RL_C105879.html) | $0.0014 | $0.0028 | $0.0011 | $1.2100 | $0.0011 | $2.4200
17 |  | RES SMD 1K OHM 1% 1/10W 0603 | R21, R22, R29 | Res0603 | RC0603FR-071KL | YAGEO | C22548 | ------------ | 1K | 1600 | 3200 | 3 | 1500 | 3000 | LCSC (https://www.lcsc.com/product-detail/Chip-Resistor-Surface-Mount_YAGEO-RC0603FR-071KL_C22548.html) | $0.0014 | $0.0042 | $0.0009 | $1.4400 | $0.0009 | $2.8800
18 |  | RES SMD ±5% ±200ppm/℃ 0.18Ω 1W 2512 | R19, R20 | RES 2512 | RTT25R18JTE | RALEC | C159165 | ------------ | 180m | 1550 | 3100 | 2 | 1000 | 2000 | LCSC (https://www.lcsc.com/product-detail/Chip-Resistor-Surface-Mount_RALEC-RTT25R18JTE_C159165.html) | $0.0295 | $0.0590 | $0.0203 | $31.4650 | $0.0203 | $62.9300
19 |  | RES 0.075 OHM 1% 2W 2512 | R27 | RES 2512 | ~~CSRN2512FK75L0~~ | Stackpole | C705611 | RL2512FK-070R075L | 75m | 530 | 1050 | 1 | 500 | 1000 | LCSC (https://www.lcsc.com/product-detail/Chip-span-style-background-color-ff0-Resistor-span-Surface-Mount_YAGEO-RL2512FK-070R075L_C705611.html) | $0.1133 | $0.1133 | $0.0776 | $41.1280 | $0.0776 | $81.4800
20 |  | RES SMD 9kΩ ±100ppm/℃ 0.125W 0805 | R28 | Cap0805 | 0805W8F9001T5E | UNI-ROYAL | C247026 | ------------ | 9K | 600 | 1100 | 1 | 500 | 1000 | LCSC (https://www.lcsc.com/product-detail/Chip-Resistor-Surface-Mount_UNI-ROYAL-Uniroyal-Elec-0805W8F9001T5E_C247026.html) | $0.0028 | $0.0028 | $0.0028 | $1.6800 | $0.0022 | $2.4200
21 |  | RES 49.9K OHM 1% 1/10W 0603 | R30, R31, R32, R34, R35, R36, R37, R38 | Res0603 | RC0603FR-0749K9L | YAGEO | C114624 | ------------ | 49K9 | 4100 | 8200 | 8 | 4000 | 8000 | LCSC (https://www.lcsc.com/product-detail/Chip-Resistor-Surface-Mount_YAGEO-RC0603FR-0749K9L_C114624.html) | $0.0018 | $0.0144 | $0.0012 | $4.9200 | $0.0012 | $9.8400
22 | IC | IC MTR DRV BIPOLAR 5.5-36V 32QFN | U3 | 32-QFN (5x5) | TMC2202-WA-T | Trinamic | ------------ | ------------ | ----- | 520 | 1040 | 1 | 500 | 1000 | Custom Supplier | $4.76 | $4.7620 | $4.76 | $2476.2400 | $4.76 | $4952.4800 | ~~MOQ=10~~
23 |  | 2A 40V SOIC-8_EP_150mil DC-DC Converters ROHS | U7 | 8-SOIC | XL4001E1 | XLSEMI | C73347 | ------------ | ----- | 520 | 1040 | 1 | 500 | 1000 | LCSC (https://www.lcsc.com/product-detail/DC-DC-Converters_XLSEMI-XL4001E1_C73347.html) | $0.2780 | $0.2780 | $0.1744 | $90.6880 | $0.1716 | $178.4640
24 |  | IC REG LINEAR 3.3V 1A SOT223 | U1 | SOT-223-3 | AZ1117CH-3.3TRG1 | Diodes | C92102 | ------------ | --- | 520 | 1040 | 1 | 500 | 1000 | LCSC (https://www.lcsc.com/product-detail/Linear-Voltage-Regulators-LDO_Diodes-Incorporated-AZ1117CH-3-3TRG1_C92102.html) | $0.1815 | $0.1815 | $0.1270 | $66.0400 | $0.1255 | $130.5200
25 | Connector | P=2.54mm Female Headers,SMD,ROHS | J1 | PHF254SMD-x | PHF254SMD-x | RTLECS | ------------ | ------------ | ----- | 600 | 1100 | 1 | 500 | 1000 | Aliexpress (https://tr.aliexpress.com/item/32814431059.html) | $0.3500 | $35.0000 | $0.3500 | $210.0000 | $0.3500 | $385.0000 | ~~MOQ=100~~
26 |  | 10/100 BASE-TX RJ45 WITH LEDS INTEGRATED MAGNETICS CONNECTOR | J2, J3 | Custom | SK07-111071ENL | SAK ELECTRONICS CO.,LTD | ------------ | ------------ | ---- | 1050 | 2100 | 2 | 1000 | 2000 | Local Supplier | $0.7500 | $1.5000 | $0.7500 | $787.5000 | $0.7500 | $1575.0000
27 |  | CONN HEADER 4 POS 2.54mm SMD | J4 | Custom | 1125N1202SNM | RTLECS | ------------ | ------------ | ----- | 520 | 1050 | 1 | 500 | 1000 | Aliexpress (https://tr.aliexpress.com/item/32727363517.html?pdp_ext_f=%7B%22sku_id%22%3A%2261240561970%22%7D) | $0.1800 | $189.0000 | $0.1800 | $93.6000 | $0.1800 | $189.0000
28 |  | 2.54mm Black Brass Plugin,P=2.54mm Pin Headers ROHS | P1 | Custom | C37208 | BOOMELEC | C37208 | ------------ | ---- | 540 | 1060 | 1 | 500 | 1000 | LCSC (https://lcsc.com/product-detail/Pin-Headers_BOOMELE-Boom-Precision-Elec-C37208_C37208.html) | $0.0263 | $27.8780 | $0.0194 | $10.4760 | $0.0182 | $19.2920
29 |  | CONN HEADER VERT 2POS 2.54MM | P2, P3 | HDR1X2 | 826629-2 | TE Connectivity | C86471 | ------------ | ----- | 1050 | 2100 | 2 | 1000 | 2000 | Alibaba (https://www.alibaba.com/product-detail/Hot-Selling-Electronic-Components-Wire-Header_1600281233933.html) | $0.2100 | $0.4200 | $0.1700 | $178.5000 | $0.1700 | $357.0000
30 |  | ~~Solder Bridge ON~~ | ~~ SB1,SB2,SB3,SB4,SB5~~ | ~~Solder Bridge~~ | ~~Solder Bridge~~ | ~~---~~ | ~~---~~ | ~~---~~ | ~~---~~ |  | ~~--~~ | ~~5~~ | 2500 | 5000 | ~~---~~ | ~~---~~ | ~~---~~ | ~~---~~ | ~~---~~ | ~~---~~ | ~~---~~ | ~~DO NOT Mount~~
31 |  | ~~Test Point ON~~ | ~~P4, P5, P6, P7,P8~~ | ~~TEST POINT~~ | ~~TEST POINT~~ | ~~---~~ | ~~---~~ | ~~---~~ | ~~---~~ |  |  | ~~5~~ | 2500 | 5000 | ~~---~~ | ~~---~~ | ~~---~~ | ~~---~~ | ~~---~~ | ~~---~~ | ~~---~~ | ~~DO NOT Mount~~
 |  |  |  |  |  |  |  |  |  |  |  | Total Component Cost |  |  |  |  | $263.0769 |  | $5797.70 |  | $11562.88
 |  |  |  |  |  |  |  |  |  |  |  | Single Board Cost |  |  |  |  |  |  | $11.60 |  | $11.56
 |  |  |  |  |  |  |  |  |  |  |  |  | Alibaba Shipping Charges |  |  |  |  |  | 61.66 |  | 98.84
 |  |  |  |  |  |  |  |  |  |  |  |  | Total Cost With Shipping |  |  |  |  |  | $5859.36 |  | $11661.72
