eSpark-Backup/christian-raun-ethercat-design/Deliverables/Interface_Board/BOM/LCSC_Interface_Board.xlsx

Bill of Material (BOM) for Interface_Board
S. No. | Components | Description | Designator | Footprint (Package) | Manufacturer Part Number | Manufacturer | LCSC Part No | Alternate | Value | LCSC/MOQ | Quantity (Per Board) | Quantity 5 | Link | Unit Cost(1) | Total Cost (1) | Unit Cost(5) | MOQ Total | Remarks | Quotation of orignal parts from Chinese supplier
1 | Capacitor | CAP CER 0.1UF 100V X7R 0603 | C34, C35, C37, C40 | Cap0603 | CC0603KRX7R0BB104 | Yageo | C113803 | ------------ | 0.1uF | 50 | 4 | 20 | LCSC (https://lcsc.com/product-detail/Multilayer-Ceramic-Capacitors-MLCC-SMD-SMT_YAGEO-CC0603KRX7R0BB104_C113803.html) | $0.0082 | $0.0328 | $0.0082 | $0.4100
2 |  | CAP CER 1UF 100V X7S 0805 | C45 | Cap0805 | GCM21BC72A105KE36L | Murata | C2842838 | ------------ | 1uF | 10 | 1 | 5 | LCSC (https://lcsc.com/product-detail/old-batch_Murata-Electronics-GCM21BC72A105KE36L_C2842838.html) | $0.0682 | $0.0682 | $0.0682 | $0.6820
3 |  | CAP CER 10PF 50V C0G/NP0 0603 | C48, C49, C50, C51, C52, C53, C54, C55 | Cap0603 | ~~06035A100JAT2A~~ | Kyocera AVX | C525235 | FN18N100J500PSG | 10pF | 100 | 8 | 40 | LCSC (https://lcsc.com/product-detail/Multilayer-Ceramic-Capacitors-MLCC-SMD-SMT_PSA-Prosperity-Dielectrics-FN18N100J500PSG_C525235.html) | $0.0031 | $0.0248 | $0.0031 | $0.3100
4 |  | CAP CER 0.022UF 100V X7R 0603 | C36, C56, C57 | Cap0603 | ~~CGA3E2X7R2A223K080AA~~ | TDK | C21122 | CL10B223KB8NNNC | 22nF | 50 | 3 | 15 | LCSC (https://www.lcsc.com/product-detail/Multilayer-Ceramic-Capacitors-MLCC-SMD-SMT_Samsung-Electro-Mechanics-CL10B223KB8NNNC_C21122.html) | $0.0053 | $0.0159 | $0.0053 | $0.2650
5 |  | CAP CER 2.2UF 50V X5R 0603 | C38 | Cap0603 | ~~UMK107BBJ225MA-T~~ | Taiyo Yuden | C268016 | UMK107BBJ225KA-T | 2.2uF | 10 | 1 | 5 | LCSC (https://www.lcsc.com/product-detail/Multilayer-Ceramic-Capacitors-MLCC-SMD-SMT_Taiyo-Yuden-UMK107BBJ225KA-T_C268016.html) | $0.0403 | $0.0403 | $0.0403 | $0.4030
6 |  | 25V 5mm 10mm 100uF 100kHz SMD,5x10mm Aluminum Electrolytic Cap- SMD ROHS | C43 | Custom | VKMB1001E101MV | Ymin | C487322 | ------------ | 100uF | 10 | 1 | 5 | LCSC (https://www.lcsc.com/product-detail/Aluminum-Electrolytic-Capacitors-SMD_Ymin-VKMB1001E101MV_C487322.html) | $0.0759 | $0.0759 | $0.0759 | $0.7590
7 |  | 63V 10mm 8mm 100uF ±20% ,8x10mm Aluminum Electrolytic Cap | C44, C79 | Custom | VKMD1001J101MV | Ymin | C487384 | ------------ | 100uF | 12 | 2 | 10 | LCSC (https://www.lcsc.com/product-detail/Aluminum-Electrolytic-Capacitors-SMD_Ymin-VKMD1001J101MV_C487384.html) | $0.1811 | $0.3622 | $0.1811 | $2.1732
8 |  | CAP ALUM 10uF 25V SMD | C1 | Custom | RVT1E100M0405 | Honor Elec | C3343 | ------------ | 10uF | 20 | 1 | 5 | LCSC (https://www.lcsc.com/product-detail/Aluminum-Electrolytic-Capacitors-SMD_Honor-Elec-RVT1E100M0405_C3343.html) | $0.0352 | $0.0352 | $0.0352 | $0.7040
9 |  | 10V 22uF ±10% CASE-A_3216 Tantalum Capacitors ROHS | C2 | Cap Case-A | CA45A-A-10V-22uF-K | CEC | C141745 | ------------ | 22uF | 10 | 1 | 5 | LCSC (https://www.lcsc.com/product-detail/Tantalum-Capacitors_CEC-Shenzhen-Zhenhua-XinYun-Elec-CA45A-A-10V-22uF-K_C141745.html) | $0.0958 | $0.0958 | $0.0958 | $0.9580
10 |  | CAP CER 1000PF 2KV X7R 1206 | C58 | Cap1206 | CC1206KKX7RDBB102 | YAGEO | C23631 | ------------ | 1000pF | 50 | 1 | 5 | LCSC (https://www.lcsc.com/product-detail/Multilayer-Ceramic-Capacitors-MLCC-SMD-SMT_YAGEO-CC1206KKX7RDBB102_C23631.html) | $0.0147 | $0.0147 | $0.0147 | $0.7350
11 | Diode | DIODE SCHOTTKY 30V 3A CFP5 | D2 | SOD-128 | PMEG3030EP,115 | Nexperia | C255587 | ------------ | ----- | 7 | 1 | 5 | LCSC (https://www.lcsc.com/product-detail/Schottky-Barrier-Diodes-SBD_Nexperia-PMEG3030EP-115_C255587.html) | $0.3172 | $0.3172 | $0.3172 | $2.2204
12 |  | SOD-523 Schottky Barrier Diodes (SBD) ROHS | D3 | SOD-523 | MSK4010 | Tak Cheong | C968723 | ------------ | ----- | 20 | 1 | 5 | LCSC (https://www.lcsc.com/product-detail/Schottky-Barrier-Diodes-SBD_Tak-Cheong-MSK4010_C968723.html) | $0.0266 | $0.0266 | $0.0266 | $0.5320
13 | Mosfet | MOSFET N-CH 20V 4.2A SOT23 | Q1 | SOT-23 | IRLML2502TRPBF | INFINEON | ------------ | ------------ | ----- | 7 | 1 | 5 | LCSC (https://lcsc.com/product-detail/MOSFETs_Infineon-Technologies-IRLML2502TRPBF_C2589.html) | $0.2127 | $0.2127 | $0.2127 | $1.4889 |  | $0.19
14 | Inductor | FIXED IND 33UH 2.5A 189.2MOHM SM | L10 | Custom | ETQ-P4M330YFN | Panasonic |  |  | ----- | 7 | 1 | 5 | Custom Supplier | $0.9770 | $0.9770 | $0.9770 | $6.8390 |  | $2.54
15 | Resistor | RES SMD 10K OHM 5% 1/10W 0603 | R1,R18 | Res0603 | AC0603JR-0710KL | YAGEO | C140867 | ------------ | 10K | 100 | 2 | 10 | LCSC (https://www.lcsc.com/product-detail/Chip-Resistor-Surface-Mount_YAGEO-AC0603JR-0710KL_C140867.html) | $0.0014 | $0.0028 | $0.0014 | $0.1400
16 |  | RES SMD 330R 100 mW 0603 | R33, R39 | Res0603 | RC0603JR-07330RL | YAGEO | C105879 | ------------ | 330R | 100 | 2 | 10 | LCSC (https://www.lcsc.com/product-detail/Chip-Resistor-Surface-Mount_YAGEO-RC0603JR-07330RL_C105879.html) | $0.0014 | $0.0028 | $0.0014 | $0.1400
17 |  | RES SMD 1K OHM 1% 1/10W 0603 | R21, R22, R29 | Res0603 | RC0603FR-071KL | YAGEO | C22548 | ------------ | 1K | 100 | 3 | 15 | LCSC (https://www.lcsc.com/product-detail/Chip-Resistor-Surface-Mount_YAGEO-RC0603FR-071KL_C22548.html) | $0.0014 | $0.0042 | $0.0014 | $0.1400
18 |  | RES SMD ±5% ±200ppm/℃ 0.18Ω 1W 2512 | R19, R20 | RES 2512 | RTT25R18JTE | RALEC | C159165 | ------------ | 180m | 20 | 2 | 10 | LCSC (https://www.lcsc.com/product-detail/Chip-Resistor-Surface-Mount_RALEC-RTT25R18JTE_C159165.html) | $0.0295 | $0.0590 | $0.0295 | $0.5900
19 |  | RES 0.075 OHM 1% 2W 2512 | R27 | RES 2512 | ~~CSRN2512FK75L0~~ | Stackpole | C705611 | RL2512FK-070R075L | 75m | 10 | 1 | 5 | LCSC (https://www.lcsc.com/product-detail/Chip-span-style-background-color-ff0-Resistor-span-Surface-Mount_YAGEO-RL2512FK-070R075L_C705611.html) | $0.1133 | $0.1133 | $0.1133 | $1.1330
20 |  | RES SMD 9kΩ ±100ppm/℃ 0.125W 0805 | R28 | Cap0805 | 0805W8F9001T5E | UNI-ROYAL | C247026 | ------------ | 9K | 100 | 1 | 5 | LCSC (https://www.lcsc.com/product-detail/Chip-Resistor-Surface-Mount_UNI-ROYAL-Uniroyal-Elec-0805W8F9001T5E_C247026.html) | $0.0028 | $0.0028 | $0.0028 | $0.2800
21 |  | RES 49.9K OHM 1% 1/10W 0603 | R30, R31, R32, R34, R35, R36, R37, R38 | Res0603 | RC0603FR-0749K9L | YAGEO | C114624 | ------------ | 49K9 | 100 | 8 | 40 | LCSC (https://www.lcsc.com/product-detail/Chip-Resistor-Surface-Mount_YAGEO-RC0603FR-0749K9L_C114624.html) | $0.0018 | $0.0144 | $0.0018 | $0.1800
22 | IC | IC MTR DRV BIPOLAR 5.5-36V 32QFN | U3 | 32-QFN (5x5) | TMC2202-WA-T | Trinamic | ------------ | ------------ | ----- | 10 | 1 | 5 | Alibaba (https://www.alibaba.com/product-detail/IC-STEPPER-MOTOR-DRIVER-RoHS-TMC2202_1600143313562.html) | $1.2000 | $1.2000 | $1.2000 | $12.0000 | ~~MOQ=10~~ | $4.76
23 |  | 2A 40V SOIC-8_EP_150mil DC-DC Converters ROHS | U7 | 8-SOIC | XL4001E1 | XLSEMI | C73347 | ------------ | ----- | 6 | 1 | 5 | LCSC (https://www.lcsc.com/product-detail/DC-DC-Converters_XLSEMI-XL4001E1_C73347.html) | $0.2780 | $0.2780 | $0.2780 | $1.6680
24 |  | IC REG LINEAR 3.3V 1A SOT223 | U1 | SOT-223-3 | AZ1117CH-3.3TRG1 | Diodes | C92102 | ------------ | --- | 6 | 1 | 5 | LCSC (https://www.lcsc.com/product-detail/Linear-Voltage-Regulators-LDO_Diodes-Incorporated-AZ1117CH-3-3TRG1_C92102.html) | $0.1698 | $0.1698 | $0.1698 | $1.0188
25 | Connector | P=2.54mm Female Headers,SMD,ROHS | J1 | PHF254SMD-x | PHF254SMD-x | RTLECS | ------------ | ------------ | ----- | 100 | 1 | 5 | Aliexpress (https://tr.aliexpress.com/item/32814431059.html) | $36.9000 | $36.9000 | $0.3690 | $36.9000 | ~~MOQ=100~~
26 |  | 10/100 BASE-TX RJ45 WITH LEDS INTEGRATED MAGNETICS CONNECTOR | J2, J3 | Custom | SK07-111071ENL | SAK ELECTRONICS CO.,LTD | ------------ | ------------ | ---- | 12 | 2 | 10 | Local Supplier | $0.7500 | $1.5000 | $0.7500 | $9.0000
27 |  | CONN HEADER 4 POS 2.54mm SMD | J4 | Custom | 1125N1202SNM | RTLECS | ------------ | ------------ | ----- | 10 | 1 | 5 | Aliexpress (https://tr.aliexpress.com/item/32727363517.html?pdp_ext_f=%7B%22sku_id%22%3A%2261240561970%22%7D) | $0.5530 | $0.5530 | $0.5530 | $5.5300
28 |  | 2.54mm Black Brass Plugin,P=2.54mm Pin Headers ROHS | P1 | Custom | C37208 | BOOMELEC | C37208 | ------------ | ---- | 20 | 1 | 5 | LCSC (https://lcsc.com/product-detail/Pin-Headers_BOOMELE-Boom-Precision-Elec-C37208_C37208.html) | $0.0263 | $0.0263 | $0.0263 | $0.5260
29 |  | CONN HEADER VERT 2POS 2.54MM | P2, P3 | HDR1X2 | 826629-2 | TE Connectivity | C86471 | ------------ | ----- | 15 | 2 | 10 | LCSC (https://www.lcsc.com/product-detail/Pin-Headers_TE-Connectivity-826629-2_C86471.html) | $0.1085 | $0.2170 | $0.1085 | $1.6275
30 |  | ~~Solder Bridge ON~~ | ~~ SB1,SB2, SB3,SB3, SB4,SB5~~ | ~~Solder Bridge~~ | ~~Solder Bridge~~ |  |  |  |  |  | ~~5~~ | 25 |  |  |  |  |  | ~~DO NOT Mount~~
31 |  | ~~Test Point ON~~ | ~~P4, P5, P6, P7,P8~~ | ~~TEST POINT~~ | ~~TEST POINT~~ |  |  |  |  |  | ~~5~~ | 25 |  |  |  |  |  | ~~DO NOT Mount~~
 |  |  |  |  |  |  |  |  |  |  | Total Component Cost |  |  |  | $43.3427 |  | $89.35
 |  |  |  |  |  |  |  |  |  |  | Single Board Cost |  |  |  |  |  | $17.87
