eSpark-Backup/christian-raun-ethercat-design/Deliverables/Control_Board/BOM/LCSC_Control_Board.xlsx

Bill of Material (BOM) for Controller Board
S. No. | Components | Description | Designator | Footprint (Package) | Manufacturer Part Number | Manufacturer | LCSC Part No | Alternate | Value | LCSC/MOQ | Quantity (Per Board) | Quantity 5 | Link | Unit Cost(1) | Total Cost(1) | Unit Cost(5) | MOQ Total | Remarks | Quotation of orignal parts from Chinese supplier
1 | Capacitor | CAP CER 1UF 100V X7S 0805 | C1, C3, C5, C26 | Cap0805 | GCM21BC72A105KE36L | Murata | C2842838 | ------------ | 1uF | 25 | 4 | 20 | LCSC (https://www.lcsc.com/product-detail/old-batch_Murata-Electronics-GCM21BC72A105KE36L_C2842838.html) | $0.0682 | $0.2728 | $0.0682 | $1.7050
2 |  | CAP CER 0.1UF 100V X7R 0603 | C2, C4, C6, C7, C8, C9, C10, C11, C12, C13, C14, C15, C16, C20, C21, C22, C23, C24, C25, C30, C31, C34, C35, C41 | Cap0603 | CC0603KRX7R0BB104 | YAGEO | C113803 | ------------ | 0.1uF | 150 | 24 | 120 | LCSC (https://www.lcsc.com/product-detail/Multilayer-Ceramic-Capacitors-MLCC-SMD-SMT_YAGEO-CC0603KRX7R0BB104_C113803.html) | $0.0047 | $0.1128 | $0.0082 | $1.2300
3 |  | CAP CER 10UF 50V X5R 0805 | C17 | Cap0805 | ~~GRM21BR61H106ME43L~~ | Murata | C440198 | GRM21BR61H106KE43L | 10uF | 10 | 1 | 5 | LCSC (https://www.lcsc.com/product-detail/Multilayer-Ceramic-Capacitors-MLCC-SMD-SMT_Murata-Electronics-GRM21BR61H106KE43L_C440198.html) | $0.1264 | $0.1264 | $0.1264 | $1.2640
4 |  | CAP CER 4.7UF 25V X5R 0603 | C18, C19, C29 | Cap0603 | ~~C1608X5R1E475M080AC~~ | TDK | C76615 | C1608X5R1E475KT000E | 4.7uF | 20 | 3 | 15 | LCSC (https://www.lcsc.com/product-detail/Multilayer-Ceramic-Capacitors-MLCC-SMD-SMT_TDK-C1608X5R1E475KT000E_C76615.html) | $0.03470 | $0.1041 | $0.0347 | $0.6940
5 |  | CAP CER 10PF 50V C0G/NP0 0603 | C27, C28, C32, C33 | Cap0603 | ~~06035A100JAT2A~~ | KYOCERA AVX | C106245 | CC0603JRNPO9BN100 | 10pF | 100 | 4 | 20 | LCSC (https://www.lcsc.com/product-detail/Multilayer-Ceramic-Capacitors-MLCC-SMD-SMT_YAGEO-CC0603JRNPO9BN100_C106245.html) | $0.0030 | $0.0120 | $0.0030 | $0.3000
6 | LED | Green 520~535nm 0402 Light Emitting Diodes (LED) RoHS | LED1, LED2,LED3 | LED 0402 | 16-213/GHC-YR1S1/3T | Everlight Elec | C74338 | ------------ | ----- | 20 | 3 | 15 | LCSC (https://www.lcsc.com/product-detail/Light-Emitting-Diodes-LED_Everlight-Elec-16-213-GHC-YR1S1-3T_C74338.html) | $0.0655 | $0.1965 | $0.0655 | $1.3100
7 | Inductor | 200Ω @ 100MHz 1 1A 300mΩ 0603 Ferrite Beads | L1, L2, L3, L4, L5 | Ind 0603 | MLB1608-201P1A(f) | Meled | C45316 | ------------ | ----- | 50 | 5 | 25 | LCSC (https://www.lcsc.com/product-detail/Ferrite-Beads_Meled-MLB1608-201P1A-f_C45316.html) | $0.0069 | $0.0345 | $0.0069 | $0.3450
8 |  | IND SMD 10uH 500mA 0805 | L6 | Ind0805 | MGFL2012F100MT-LF | microgate | C281113 | ------------ | ----- | 10 | 1 | 5 | LCSC (https://www.lcsc.com/product-detail/Inductors-SMD_microgate-MGFL2012F100MT-LF_C281113.html) | $0.0496 | $0.0496 | $0.0496 | $0.4960
9 | Resistor | RES SMD 10K OHM 5% 1/10W 0603 | R1, R2, R3, R4, R5, R9, R14, R15, R16, R23, R41, R42 | Res0603 | AC0603JR-0710KL | YAGEO | C140867 | ------------ | 10K | 100 | 12 | 60 | LCSC (https://www.lcsc.com/product-detail/Chip-Resistor-Surface-Mount_YAGEO-AC0603JR-0710KL_C140867.html) | $0.0014 | $0.0168 | $0.0014 | $0.1400
10 |  | RES SMD 0603 33 Ohm 1% 1/10W | R6, R11, R12 | Res0603 | RC0603FR-0733RL | YAGEO | C108661 | ------------ | 33R | 100 | 3 | 15 | LCSC (https://www.lcsc.com/product-detail/Chip-Resistor-Surface-Mount_YAGEO-RC0603FR-0733RL_C108661.html) | $0.0014 | $0.0042 | $0.0014 | $0.1400
11 |  | RES SMD 330R 100 mW 0603 | R7 | Res0603 | RC0603JR-07330RL | YAGEO | C105879 | ------------ | 330R | 100 | 1 | 5 | LCSC (https://www.lcsc.com/product-detail/Chip-Resistor-Surface-Mount_YAGEO-RC0603JR-07330RL_C105879.html) | $0.0014 | $0.0014 | $0.0014 | $0.1400
12 |  | RES SMD 1K OHM 1% 1/10W 0603 | R8, R10, R40,R17 | Res0603 | RC0603FR-071KL | YAGEO | C22548 | ------------ | 1K | 100 | 4 | 20 | LCSC (https://www.lcsc.com/product-detail/Chip-Resistor-Surface-Mount_YAGEO-RC0603FR-071KL_C22548.html) | $0.0014 | $0.0056 | $0.0014 | $0.1400
13 |  | RES SMD 100 OHM 1% 1/10W 0603 | R18, R19 | Res0603 | RC0603FR-07100RL | YAGEO | C105588 | ------------ | 100R | 100 | 2 | 10 | LCSC (https://lcsc.com/product-detail/Chip-Resistor-Surface-Mount_YAGEO-RC0603FR-07100RL_C105588.html) | $0.0015 | $0.0030 | $0.0015 | $0.1500
14 |  | RES SMD 470 OHM 1% 1/10W 0603 | R20 | Res0603 | RC0603FR-07470RL | YAGEO | C114669 | ------------ | 470R | 100 | 1 | 5 | LCSC (https://lcsc.com/product-detail/Chip-Resistor-Surface-Mount_YAGEO-RC0603FR-07470RL_C114669.html) | $0.0016 | $0.0016 | $0.0016 | $0.1600
15 |  | RES SMD 12.1K OHM 1/10W 0603 | R13 | Res0603 | RT0603CRD0712K1L | Stackpole | C705893 | ------------ | 12.1K | 100 | 1 | 5 | LCSC (https://www.lcsc.com/product-detail/Chip-Resistor-Surface-Mount_YAGEO-RT0603CRD0712K1L_C705893.html) | $0.0168 | $0.0168 | $0.0168 | $1.6800
16 | Switch | SWITCH TACTILE SPST-NO 0.05A 12V | SW1 | Custom | B3U-1000P | Omron | ------------ | ------------ | ----- | 10 | 1 | 5 | LCSC (https://www.lcsc.com/product-detail/span-style-background-color-ff0-Tactile-span-Switches_G-span-style-background-color-ff0-Switch-span-GT-TC026B-H015-L1_C778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) | $0.0727 | $0.0727 | $0.0727 | $0.7270
17 | Ics | IC ETHERCAT SLAVE CONTROLLER | U1 | 128-TQFP (14x14) | LAN9255/ZMX019 | Microchip | -------- | ---------- | ----- | 5 | 1 | 5 | Custom supplier | $21.26 | $21.2600 | $21.26 | $106.3000
18 |  | IC EEPROM 256KBIT I2C 1MHZ 8SOIC | U2 | 8-SOIC | CAT24C256WI-GT3 | onsemi | C79987 | ------------ | ----- | 6 | 1 | 5 | LCSC (https://www.lcsc.com/product-detail/EEPROM_onsemi-CAT24C256WI-GT3_C79987.html) | $0.4400 | $0.4400 | $0.4400 | $2.6400
19 |  | MAGNETIC ANGLE SENSOR | U4 | 8-SOIC | TLE5012BE5000FUMA1 | Infineon | ------------ | ------------ | ----- | 10 | 1 | 5 | Aliexpress (https://www.aliexpress.com/item/33051187576.html?pdp_ext_f=%7B%22sku_id%22%3A%2267477268699%22%7D) | $17.38 | $17.3800 | $1.7380 | $17.3800 | MOQ=10 | $1.19
20 |  | IC TRNSLTR BIDIRECTIONAL US8 | U3 | 8-VSSOP | TXB0102DCUT | Texas | C2677366 | ------------ | ----- | 10 | 1 | 5 | Aliexpress (https://www.aliexpress.com/item/4000809540773.html) | $9.4500 | $9.4500 | $0.9450 | $9.4500 | MOQ=10 | $0.79
21 | Crystal | CRYSTAL 25.0000MHZ 8PF SMD | X1 | Custom | C3E-25.000-8-1015-X-M | Aker Technology |  |  |  |  | 1 | 5 |  |  | $0.0000 |  | $0.0000 |  | Awaiting Custom Supplier Quotation
22 |  | Crystal 32.768KHZ 6.0PF SMD | X2 | Custom | CM8V-T1A-32.768KHZ-6PF-20PPM-TA-QC | -------- | ------------ | -------- | ---- | 7 | 1 | 5 | Custom supplier | $0.87 | $0.8662 | $0.87 | $6.0634
23 | Connector | 5 POS 2.54mm Pin Header Male single row Right Angle SMD | J1 | HDR1X5 SMD | PH254P1x12SMRA-100 | RTLECS | -------- | ------------ | ---- | 5 | 2 | 10 | Aliexpress (https://www.aliexpress.com/item/32739653845.html?pdp_ext_f=%7B%22sku_id%22%3A%2261529845100%22%7D) | $11.5300 | $11.5300 | $2.3060 | $11.5300 | Ye part Same ha or Quantity b Zayada ha is lye merge kr dia ha isko
24 |  | 6 POS 2.54mm Pin Header Male single row Right Angle SMD | J2 | HDR1X6 SMD | PH254P1x12SMRA-100_1 | RTLECS | -------- | ---------- | ---- |  | 1 | 5
25 |  | CONN HEADER SMD 26POS 2.54MM | J3 | Custom | 95278-101A26LF | Amphenol | ------- | ----------- | ---- | 10 | 1 | 5 | Aliexpress (https://www.aliexpress.com/item/32724713249.html) | $5.0400 | $5.0400 | $0.5040 | $5.0400
26 |  | ~~Solder Bridge ON~~ | ~~SB1, SB4, SB5, SB6, SB7~~ | ~~Solder Bridge~~ | ~~Solder Bridge~~ | ~~-----------~~ | ~~-----------~~ | ~~-----------~~ | ~~--------~~ | ~~-----------~~ | 5 | 25 | ~~-----------~~ | ~~-----------~~ | ~~-----------~~ | ~~-----------~~ | ~~-----------~~ | ~~DO NOT Mount~~
27 |  | ~~Test Point ON~~ | ~~P1,P5,P6~~ | ~~TEST POINT~~ | ~~TEST POINT~~ | ~~-----------~~ | ~~-----------~~ | ~~-----------~~ | ~~--------~~ | ~~-----------~~ | 3 | 15 | ~~-----------~~ | ~~-----------~~ | ~~-----------~~ | ~~-----------~~ | ~~-----------~~ | ~~DO NOT Mount~~
 |  |  |  |  |  |  |  |  |  |  | Total Component Cost |  |  |  | $66.9970 |  | $169.02
 |  |  |  |  |  |  |  |  |  |  | Single Board Cost |  |  |  |  |  | $33.80
