eSpark-Backup/christian-raun-ethercat-design/Deliverables/Interface_Board/BOM/PCB Way_Interface_Board.xlsx

Bill of Material (BOM) for Interface_Board
S. No. | Components | Description | Designator | Footprint (Package) | Manufacturer Part Number | Value | LCSC/MOQ | Quantity (Per Board) | Quantity 5 | Remarks
1 | Capacitor | CAP CER 0.1UF 100V X7R 0603 | C34, C35, C37, C40 | Cap0603 | CC0603KRX7R0BB104 | 0.1uF | 50 | 4 | 20
2 |  | CAP CER 1UF 100V X7S 0805 | C45 | Cap0805 | GCM21BC72A105KE36L | 1uF | 10 | 1 | 5
3 |  | CAP CER 10PF 50V C0G/NP0 0603 | C48, C49, C50, C51, C52, C53, C54, C55 | Cap0603 | FN18N100J500PSG | 10pF | 100 | 8 | 40
4 |  | CAP CER 0.022UF 100V X7R 0603 | C36, C56, C57 | Cap0603 | CL10B223KB8NNNC | 22nF | 50 | 3 | 15
5 |  | CAP CER 2.2UF 50V X5R 0603 | C38 | Cap0603 | UMK107BBJ225KA-T | 2.2uF | 10 | 1 | 5
6 |  | 25V 5mm 10mm 100uF 100kHz SMD,5x10mm Aluminum Electrolytic Cap- SMD ROHS | C43 | Custom | VKMB1001E101MV | 100uF | 10 | 1 | 5
7 |  | 63V 10mm 8mm 100uF ±20% ,8x10mm Aluminum Electrolytic Cap | C44, C79 | Custom | VKMD1001J101MV | 100uF | 12 | 2 | 10
8 |  | CAP ALUM 10uF 25V SMD | C1 | Custom | RVT1E100M0405 | 10uF | 20 | 1 | 5
9 |  | 10V 22uF ±10% CASE-A_3216 Tantalum Capacitors ROHS | C2 | Cap Case-A | CA45A-A-10V-22uF-K | 22uF | 10 | 1 | 5
10 |  | CAP CER 1000PF 2KV X7R 1206 | C58 | Cap1206 | CC1206KKX7RDBB102 | 1000pF | 50 | 1 | 5
11 | Diode | DIODE SCHOTTKY 30V 3A CFP5 | D2 | SOD-128 | PMEG3030EP,115 | ----- | 7 | 1 | 5
12 |  | SOD-523 Schottky Barrier Diodes (SBD) ROHS | D3 | SOD-523 | MSK4010 | ----- | 20 | 1 | 5
13 | Mosfet | MOSFET N-CH 20V 4.2A SOT23 | Q1 | SOT-23 | IRLML2502TRPBF | ----- | 7 | 1 | 5
14 | Inductor | FIXED IND 33UH 2.5A 189.2MOHM SM | L10 | Custom | ETQ-P4M330YFN | ----- | 7 | 1 | 5
15 | Resistor | RES SMD 10K OHM 5% 1/10W 0603 | R1,R18 | Res0603 | AC0603JR-0710KL | 10K | 100 | 2 | 10
16 |  | RES SMD 330R 100 mW 0603 | R33, R39 | Res0603 | RC0603JR-07330RL | 330R | 100 | 2 | 10
17 |  | RES SMD 1K OHM 1% 1/10W 0603 | R21, R22, R29 | Res0603 | RC0603FR-071KL | 1K | 100 | 3 | 15
18 |  | RES SMD ±5% ±200ppm/℃ 0.18Ω 1W 2512 | R19, R20 | RES 2512 | RTT25R18JTE | 180m | 20 | 2 | 10
19 |  | RES 0.075 OHM 1% 2W 2512 | R27 | RES 2512 | RL2512FK-070R075L | 75m | 10 | 1 | 5
20 |  | RES SMD 9kΩ ±100ppm/℃ 0.125W 0805 | R28 | Cap0805 | 0805W8F9001T5E | 9K | 100 | 1 | 5
21 |  | RES 49.9K OHM 1% 1/10W 0603 | R30, R31, R32, R34, R35, R36, R37, R38 | Res0603 | RC0603FR-0749K9L | 49K9 | 100 | 8 | 40
22 | IC | IC MTR DRV BIPOLAR 5.5-36V 32QFN | U3 | 32-QFN (5x5) | TMC2202-WA-T | ----- | 10 | 1 | 5 | ~~MOQ=10~~
23 |  | 2A 40V SOIC-8_EP_150mil DC-DC Converters ROHS | U7 | 8-SOIC | XL4001E1 | ----- | 6 | 1 | 5
24 |  | IC REG LINEAR 3.3V 1A SOT223 | U1 | SOT-223-3 | AZ1117CH-3.3TRG1 | --- | 6 | 1 | 5
25 | Connector | P=2.54mm Female Headers,SMD,ROHS | J1 | PHF254SMD-x | PHF254SMD-x | ----- | 100 | 1 | 5 | ~~MOQ=100~~
26 |  | 10/100 BASE-TX RJ45 WITH LEDS INTEGRATED MAGNETICS CONNECTOR | J2, J3 | Custom | SK07-111071ENL | ---- | 12 | 2 | 10
27 |  | CONN HEADER 4 POS 2.54mm SMD | J4 | Custom | 1125N1202SNM | ----- | 10 | 1 | 5
28 |  | 2.54mm Straight 1 4 Header TH,P=2.54mm Pin Headers ROHS | P1 | HDR1X4 | MTP125-1104S1 | ---- | 20 | 1 | 5
29 |  | CONN HEADER VERT 2POS 2.54MM | P2, P3 | HDR1X2 | 826629-2 | ----- | 15 | 2 | 10
30 |  | ~~Solder Bridge ON~~ | ~~ SB1,SB2, SB3,SB3, SB4,SB5~~ | ~~Solder Bridge~~ | ~~Solder Bridge~~ |  |  | ~~5~~ | 25 | ~~DO NOT Mount~~
31 |  | ~~Test Point ON~~ | ~~P4, P5, P6, P7,P8~~ | ~~TEST POINT~~ | ~~TEST POINT~~ |  |  | ~~5~~ | 25 | ~~DO NOT Mount~~
