eSpark-Backup/christian-raun-ethercat-design/Documents/Dev-Files/Parts List/Parts List - Revised.xlsx

Christia Raun Part list - Revised
S.No | Component Type | Component Name | Manufacturer Part Number | Description | Supplier Link | Cost per board | Remarks from Client
1 | Ics | Stepper Driver | TMC2202-WA-T | IC MTR DRV BIPOLAR 5.5-36V 32QFN | DigiKey (https://eu.mouser.com/ProductDetail/Trinamic/TMC2202-WA-T) | $2.30
2 |  | Main Controller | LAN9255/ZMX019 | IC ETHERCAT SLAVE CONTROLLER | Mouser (https://eu.mouser.com/ProductDetail/Microchip-Technology/LAN9255-ZMX019?qs=W%2FMpXkg%252BdQ4h9WKxuPtepA%3D%3D) | $14.70 | for 25 pieces.
3 |  | EEPROM | CAT24C256WI-GT3 | 256 Kbit I2C Serial EEPROM | Quest Components (https://www.questcomp.com/part/4/cat24c256wi-gt3/127983426) | $0.16
 |  | DC switching regulator | XL4001E1 | 2A 150kHz 40V Buck DC/DC Converter With Constant Current Loop | Alibaba (https://www.alibaba.com/product-detail/New-Integrated-Circuit-XL4001E1-in-stock_1600251950180.html) | $0.70 | for 100+ pieces
4 |  | LDO | AZ1117H-3.3TRE1 | 3.3V Regulator | Digikey (https://www.digikey.com/en/products/detail/diodes-incorporated/AZ1117H-3-3TRE1/4471000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) | $0.23
 |  | Level translator | SN74LVCH8T245PWR | IC TRANSLATION TXRX 5.5V 24TSSOP | DigiKey (https://www.digikey.com/en/products/detail/njr-corporation-njrc/NJW4132U2-C-TE1/10671837)
5 |  | Encoder | TLE5012BE5000FUMA1 | Rotary Magentic Encoder | Digikey (https://www.digikey.com/en/products/detail/infineon-technologies/TLE5012BE5000FUMA1/12604055) | $2.46
6 | Crystal | Crystal | C3E-25.000-8-1015-X-M | CRYSTAL 25.0000MHZ 8PF SMD | Digikey (https://www.digikey.com/en/products/detail/aker-technology-usa/C3E-25-000-8-1015-X-M/12730886) | $0.25
 |  | Crystal | CM8V-T1A-32.768KHZ-6PF-20PPM-TA-QC | CRYSTAL 32.7680KHZ 6PF SMD | DigiKey (https://www.digikey.com/en/products/detail/micro-crystal-ag/CM8V-T1A-32-768KHZ-6PF-20PPM-TA-QC/10499094) | $0.45
7 | Transistor | Drive Mosfets | SIL03N10-TP | MOSFET N-CH 100V 3A SOT23-6L | DigiKey (https://www.digikey.com/en/products/detail/micro-commercial-co/SIL03N10-TP/12177215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) | $0.10 | 8 pieces required in each board (for step and direction cntrl)
 | Switch | RESET switch | PTS526 SK15 SMTR2 LFS | TACT 5.2 X 5.2, 1.5 MM H, 260GF, | DigiKey (https://www.digikey.com/en/products/detail/c-k/PTS526-SK15-SMTR2-LFS/10056626) | $0.09
10 | Pump | Pump | AIRPO D20288 | Vaccum Pump | Sparkfun (https://www.sparkfun.com/products/10398) | $18.95
11 | Power isolator | Optocoupler | TLP5751(LF4,E | Logic Output Opto-couplers Photocoupler 30V 1A 5000Vrms | Mouser (https://eu.mouser.com/ProductDetail/Toshiba/TLP5751LF4E) | $1.30
9 | Connector | Header | SBH11-PBPC-D10-ST-BK | Debugging Header | Digikey (https://www.digikey.com/en/products/detail/sullins-connector-solutions/SBH11-PBPC-D10-ST-BK/1990065) | $0.50
12 |  | MagJack | HR911105A | Ethernet Connectors/Modular Connectors (RJ45) | Alibaba (https://www.alibaba.com/product-detail/-Ethernet-Connectors-Modular-Connectors-RJ45_1600220270215.html) | $1.10
13 |  | DC input headers | B2B-ZR(LF)(SN) | CONN HEADER VERT 2POS 1.5MM | DigiKey (https://www.digikey.com/en/products/detail/jst-sales-america-inc/B2B-ZR-LF-SN/926564) | $0.09
14 |  | Stepper o/p connector | B4B-XH-AM (LF)(SN) | Conn Shrouded Header HDR 4 POS 2.5mm Solder ST Top Entry Thru-Hole Box | Verical (https://www.verical.com/pd/jst-headers---pcb-receptacles-B4B-XH-AM--LF--SN--2546548) | $0.16
 | Miscellaneous | Resistors, capacitors and inductors, LED | 1K, 10K, 100K, 2K, 1uF, 0.1uF, 10nF, 10uF, 22uF, 2.2uF, 0.47uF, 33nF, 1.47 uH/3A | more than 50V (preferably 100V), 0603 package
Total |  |  |  |  |  | $43.54 | 3
