eSpark-Backup/christian-raun-ethercat-design/Documents/Dev-Files/Parts List/Parts List.xlsx

CHRISTIAN RAUN COMPONENTS LIST
S.No | Component Name | Manufacturer Part Number | Description | Reference URL | Unit Cost | Remarks from Client
1 | Stepper Driver | TMC5160A-TA-T | Stepper Motor Driver IC | Digikey (https://www.digikey.com/en/products/detail/trinamic-motion-control-gmbh/TMC5160A-TA-T/11306895) | $6.63
2 | Main Controller | STM32F407VGT7TR | Main Processing Unit | Digikey (https://www.digikey.com/en/products/detail/stmicroelectronics/STM32F407VGT7TR/5268288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) | $15.77
3 | EtherCAT Slave | AX58100 | EtherCAT IC | ASIX (https://www.asix.com.tw/en/product/IndustrialEthernet/EtherCAT/AX58100) | -
4 | LDO | NCP708MU330TAG | 3.3V Regulator | Digikey (https://www.digikey.com/en/products/detail/onsemi/NCP708MU330TAG/5404559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) | $0.65
5 | Encoder | AEAT-8800-Q24 | Rotary Magentic Encoder | Digikey (https://www.digikey.com/en/products/detail/broadcom-limited/AEAT-8800-Q24/6681014) | $9.36
6 | Pump | AIRPO D20288 | Vaccum Pump | Sparkfun (https://www.sparkfun.com/products/10398) | $18.95
7 | Relay | PVDZ172NSPBF | Solid State Relay | Digikey (https://www.digikey.com/en/products/detail/infineon-technologies/PVDZ172NSPBF/1828150) | $11.48
8 | RJ45 | KRJ-56S8P8C1X2ENL | EtherCAT Connector | RJ45Trans (https://www.rj45transformer.com/sale-447757-right-angle-pcb-mount-dual-port-combo-rj45-connector-ethernet-modular-jack.html) | -
9 | MicroUSB | 10118192-0001LF | USB Connector | Digikey (https://www.digikey.com/en/products/detail/amphenol-icc-fci/10118192-0001LF/2785387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) | $0.45
10 | Header | M55-7012042R | Debugging Header | Digikey (https://www.digikey.com/en/products/detail/harwin-inc/M55-7012042R/8537597) | $1.34
