eSpark-Backup/christian-raun-ethercat-design/Deliverables/Control_Board/Supporting_Files/ControlBoard_PCB.step

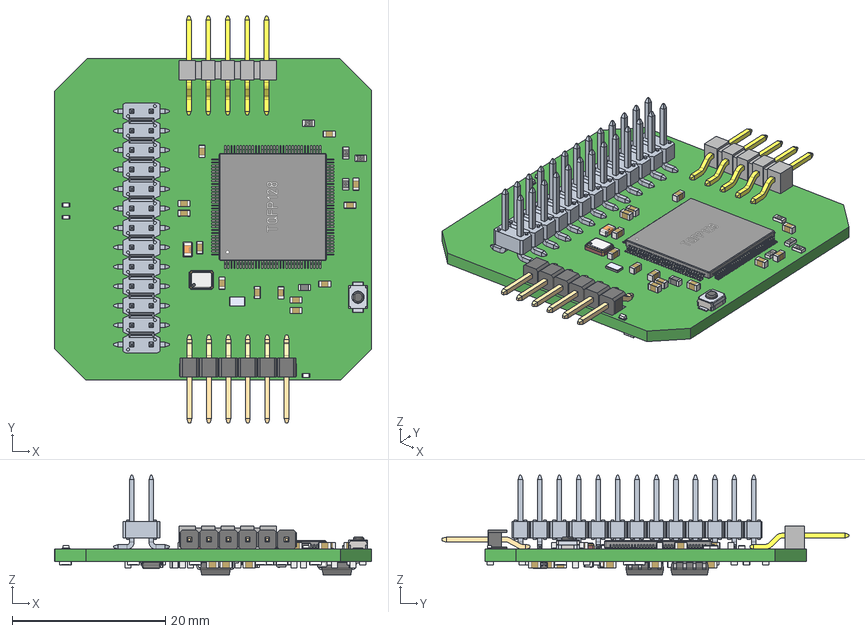
[picture p21: CAD file, 2021-11-10]
Deliverables/Control_Board/Supporting_Files/ControlBoard_PCB.step
41.4 x 53.2 x 13.0 mm
77310_YXXSMT x 26
TXB0102DCUT
User_Library-TQFP128
User_Library-RESC1608X05N x 24
APHHS1005 x 3
_TSM-105-01-SH_body
_T-1S6-08(-01-5-SH)
CM8V-T1A-32.768KHZ-6PF-20PPM-TA-QC
MetalFrame
Pin1Marker
Pin3
Pin1
Lid
Pin4
Pin2
Ceramic
User_Library-CAPC1608X09 x 31
User_Library-SOIC-8-1
User_Library-SOIC-8-1_2025474107
User_Library-OMRON_B3U1000P
Lötende x 10
base x 5
M20-88906_MOULD
M20-889_CONTACT x 6
User_Library-0805_SMD_Capacitor x 5
