eSpark-Backup/christian-raun-ethercat-design/Deliverables/Interface_Board/Supporting_Files/InterfaceBoard_PCB.step

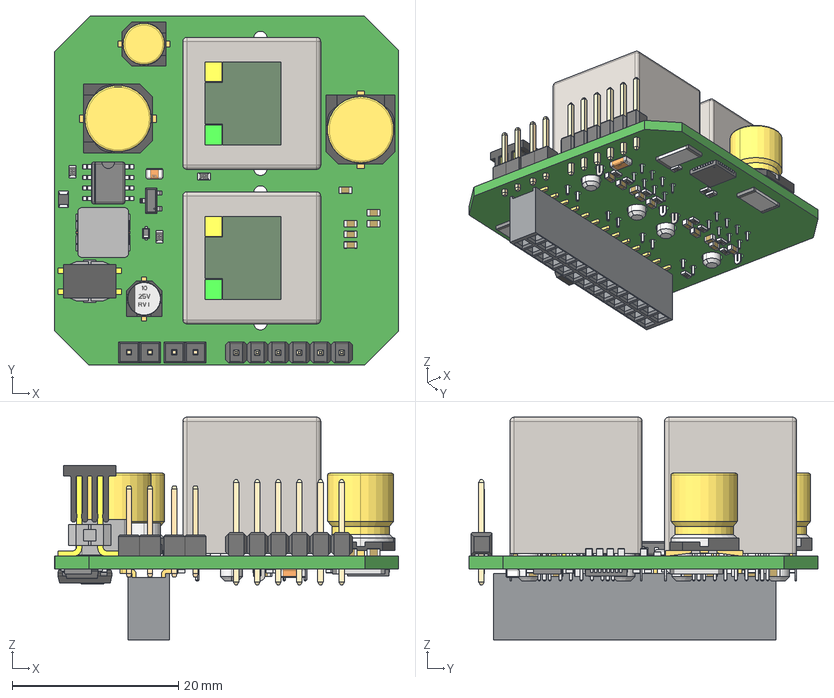
[picture p22: CAD file, 2021-11-16]
Deliverables/Interface_Board/Supporting_Files/InterfaceBoard_PCB.step
41.4 x 42.0 x 26.8 mm
holder
pin x 6
csak_0711_N x 2
phf254smd-x_Updated
User_Library-RESC1608X05N x 15
vkmd1001j101mv_c487384 x 2
vkmb1001e101mv_stp__C487322
roqangrvt1e100m0405
User_Library-CAPC1608X09 x 16
_TSM-102-01-DV_body
_PPP-06-01-2--DV
_T-1S6-16(-01-2-DV)
SO8
Extruded
WQFN32_5X5_TRI
ncp1117st50t3g
User_Library-CR2012-0805
CircuitWorks-RESISTOR_2512 x 3
PG-TO23-3_INF
User_Library-Header1x2_Header1_1 x 4
M0645M_100YFN_提出用
User_Library-SOD-523F
User_Library-SOD128
User_Library-1206_SMD_Capacitor
User_Library-0805_SMD_Capacitor
User_Library-CAP_TANT_3216-18_A_case
