eSpark-Backup/christian-raun-ethercat-design/(list of files, cad)

Other CAD files:
Deliverables/Control_Board/Supporting_Files/ControlBoard_PCB.DWG
Deliverables/Control_Board/Supporting_Files/ControlBoard_PCB.DXF
Deliverables/Interface_Board/Supporting_Files/InterfaceBoard_PCB.DWG
Deliverables/Interface_Board/Supporting_Files/InterfaceBoard_PCB.DXF
