eSpark-Backup/christian-raun-ethercat-design/Design-Files/ControlBoard-DesignFiles/EtherCAT_Project.pdf

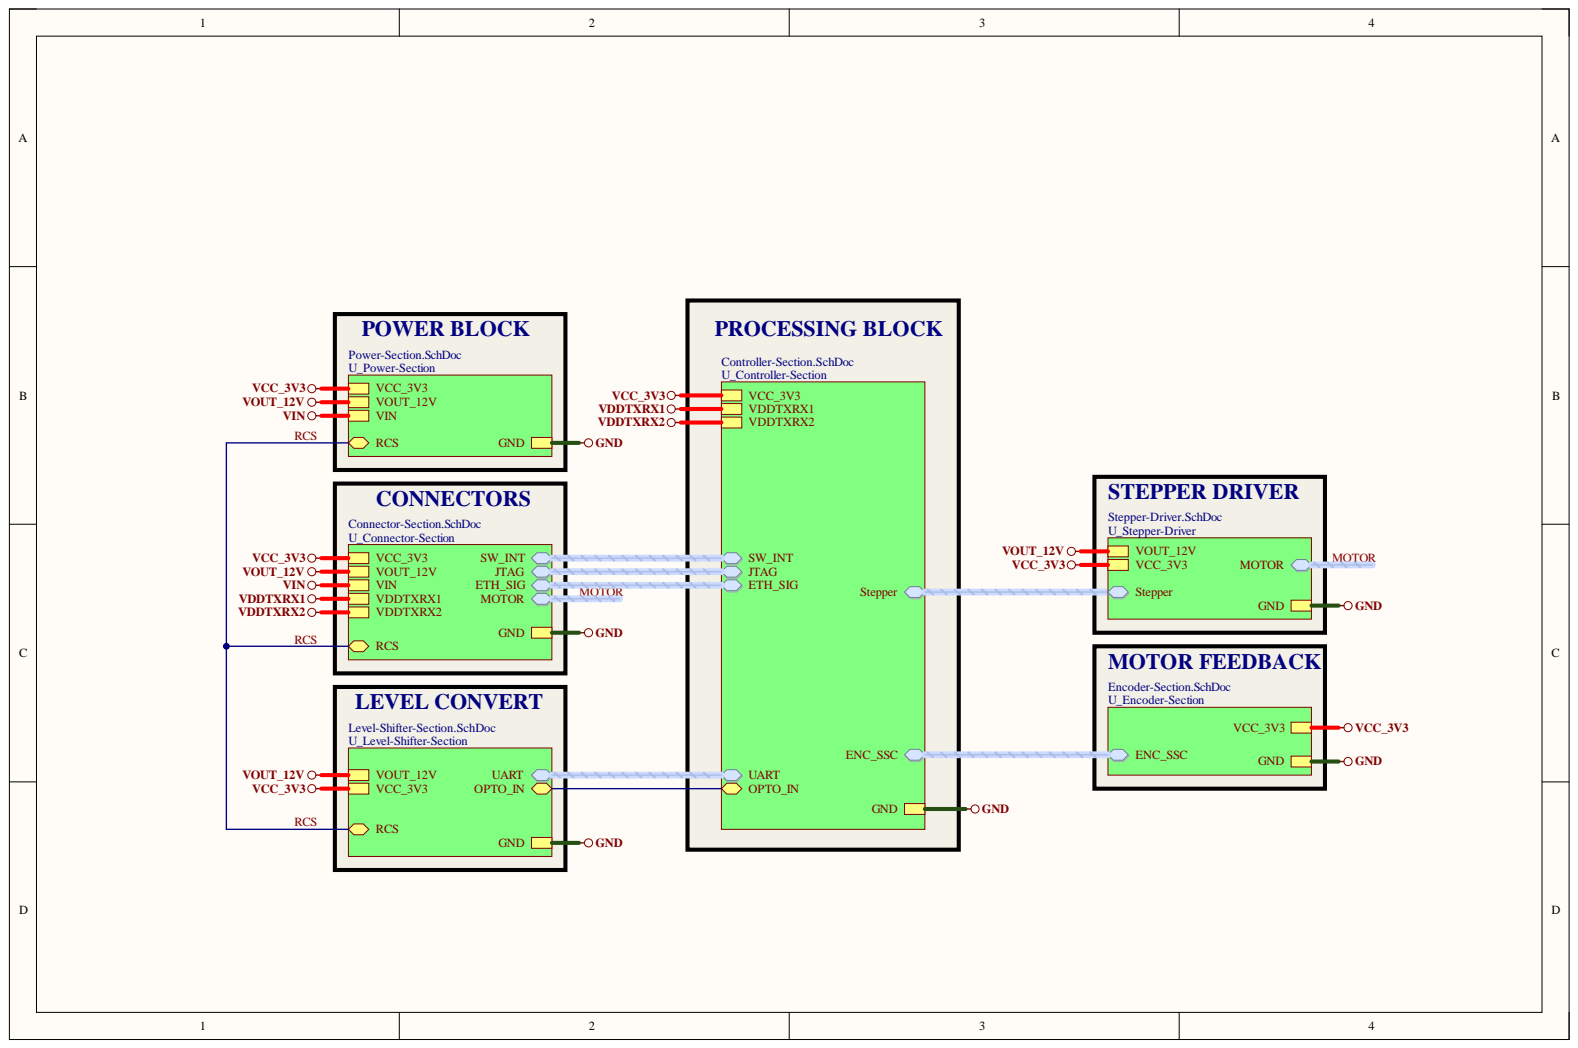
[picture p23: page 1]

CONNECTORS Connector-Section.SchDoc U_Connector-Section

RCS

Level-Shifter-Section.SchDoc
U_Level-Shifter-Section

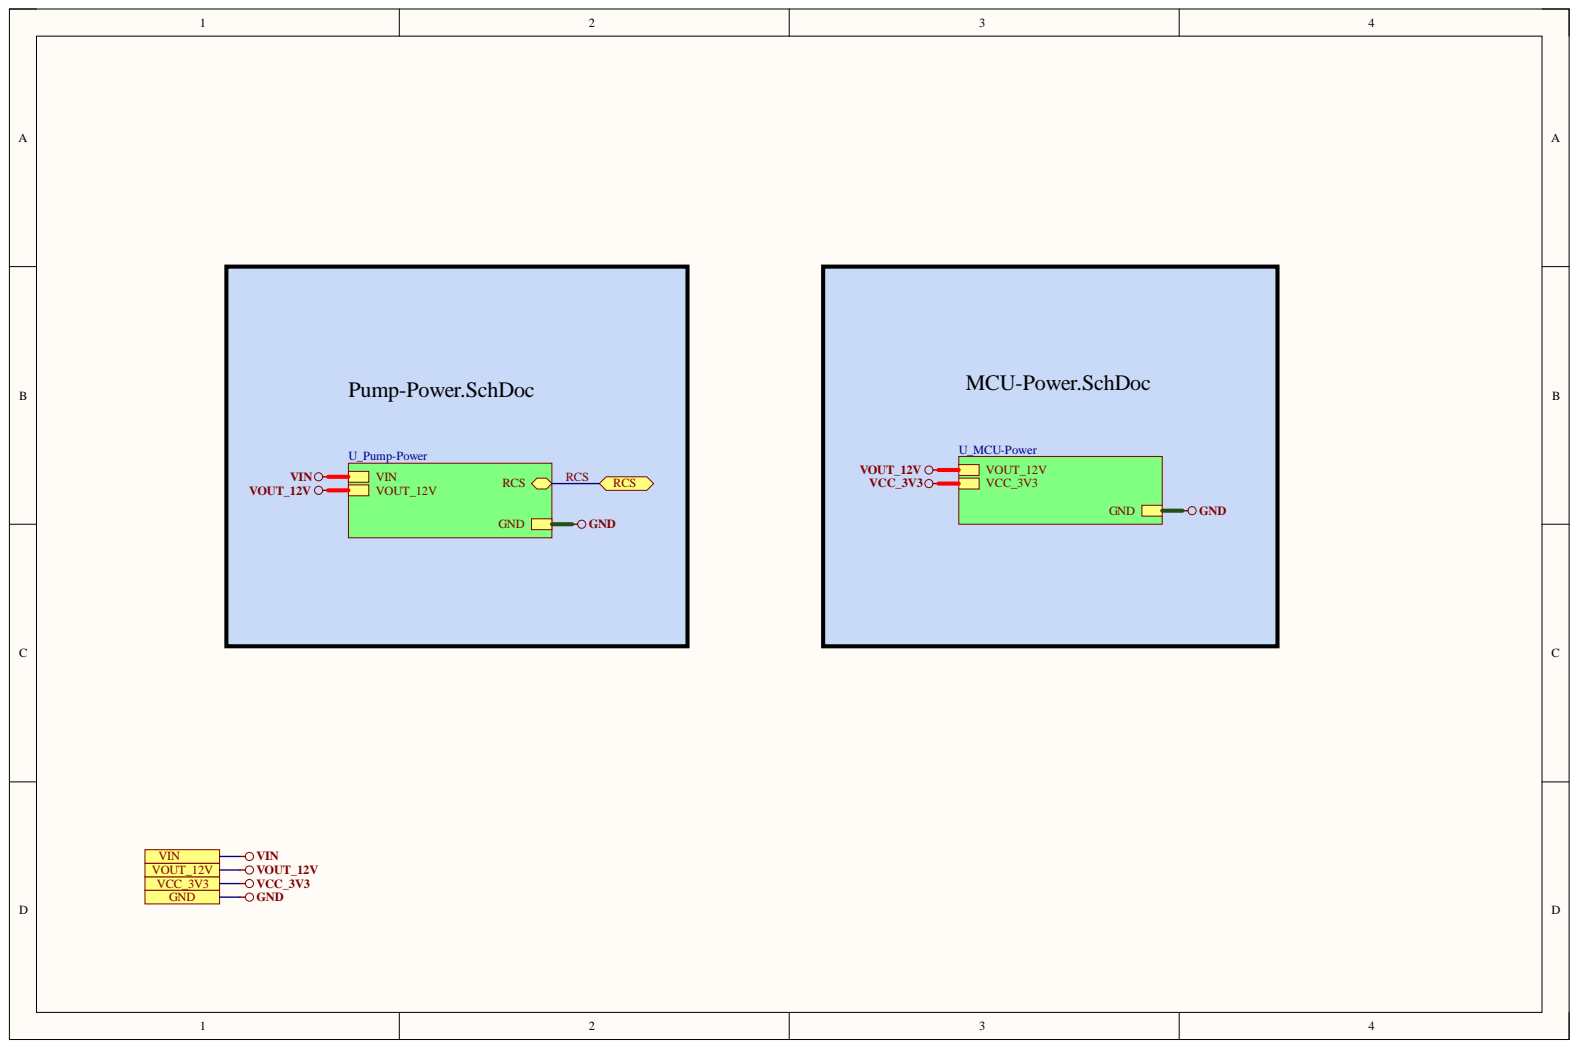
[picture p24: page 2]

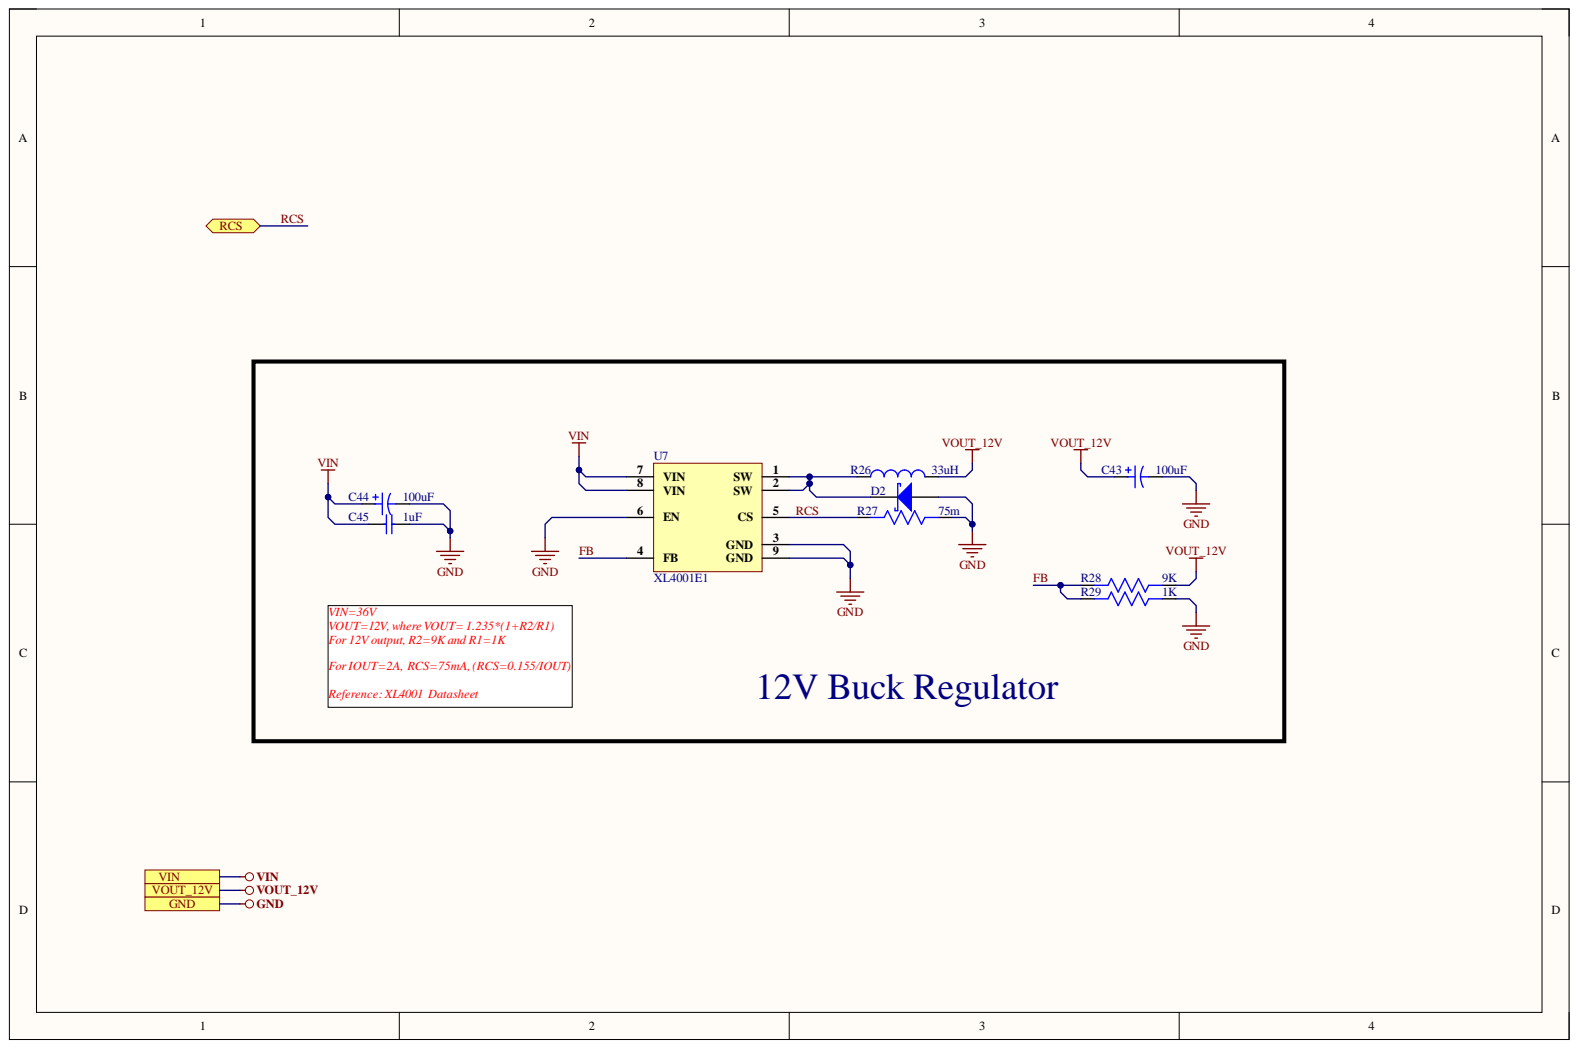
[picture p25: page 3]

For IOUT=2A, RCS=75mA,(RCS=0.155/IOUT)

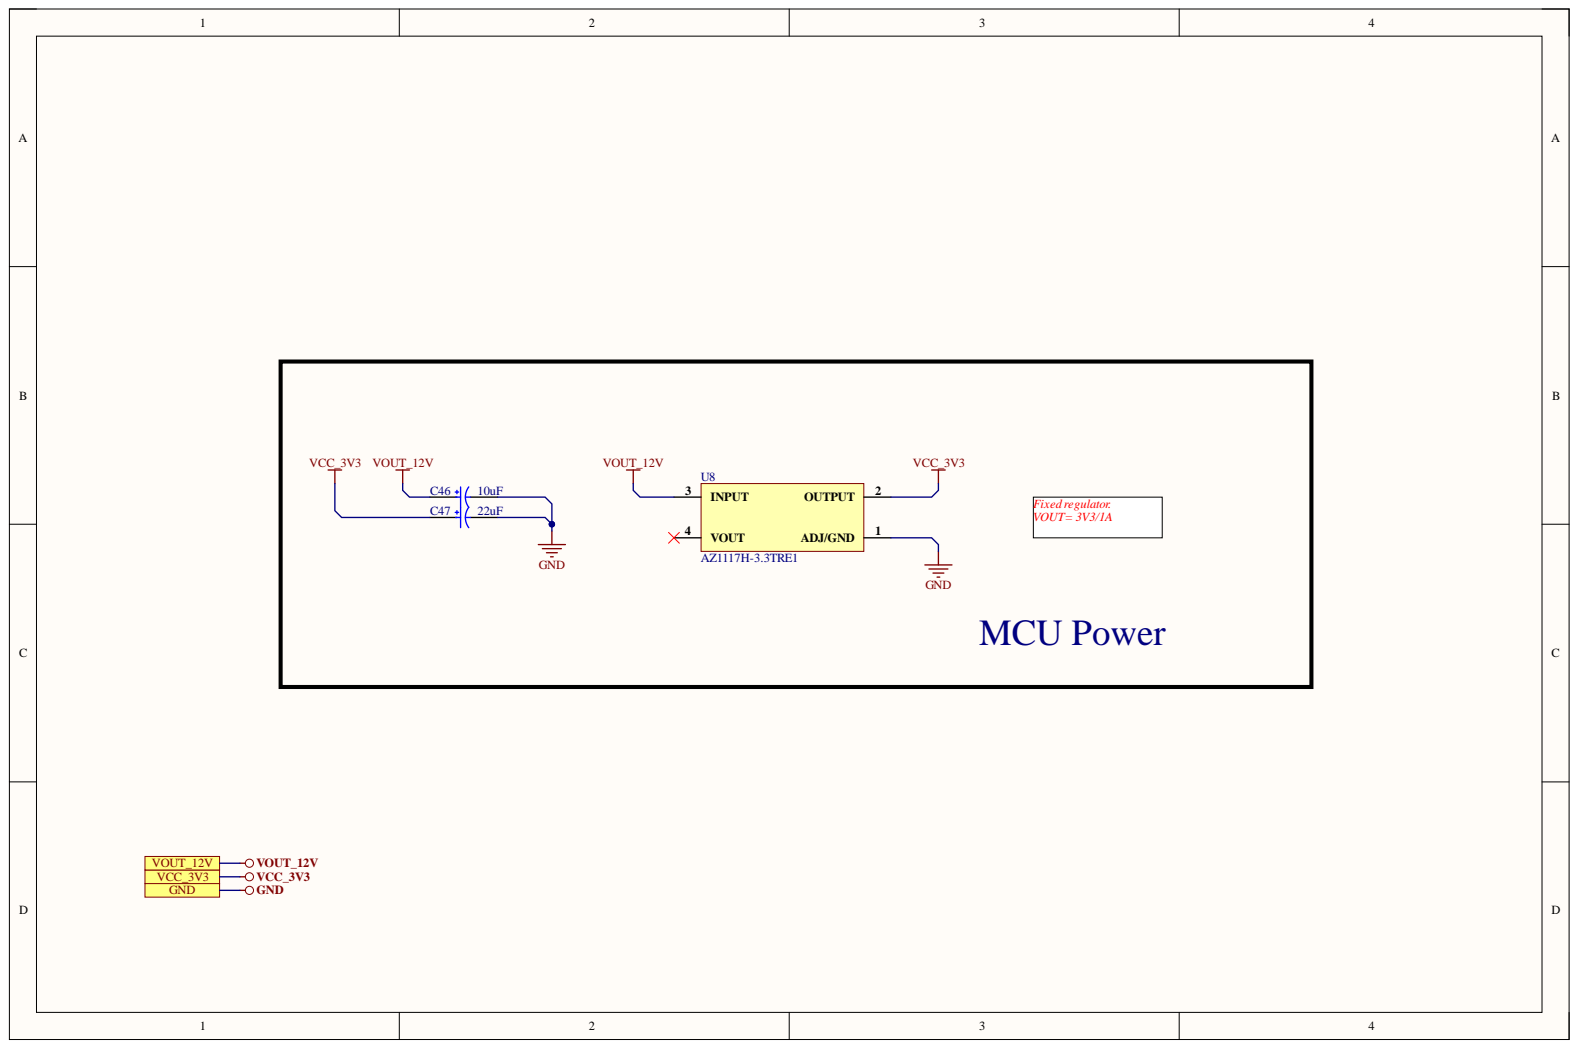
[picture p26: page 4]

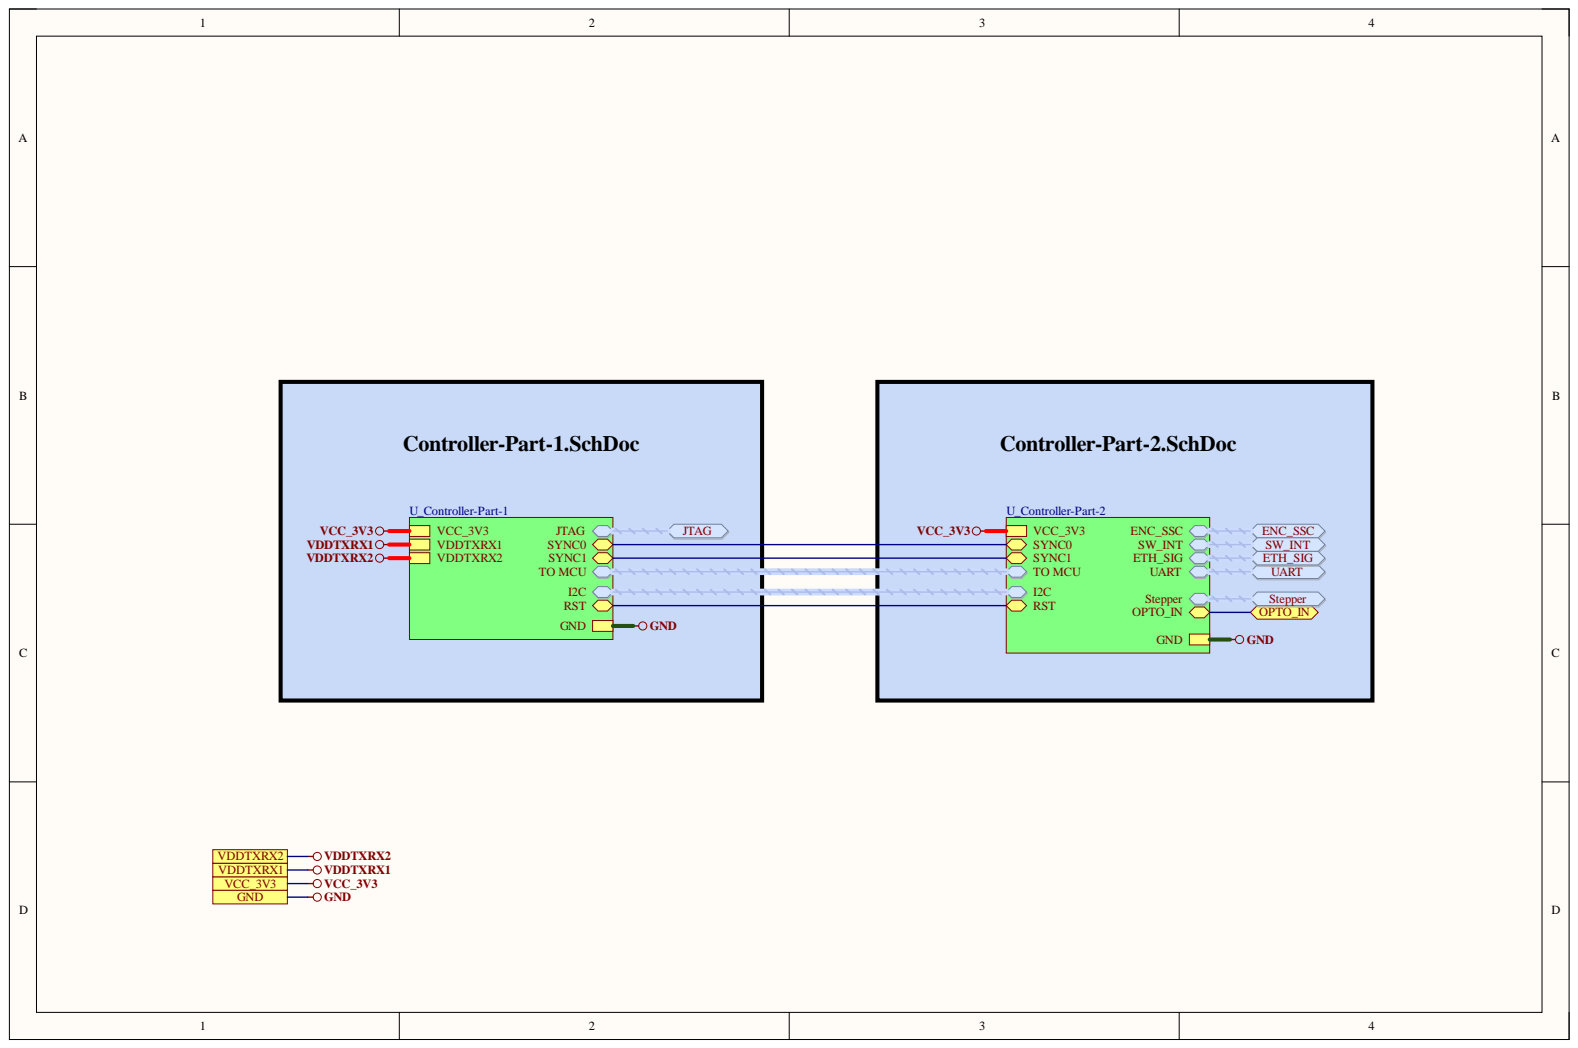
[picture p27: page 5]

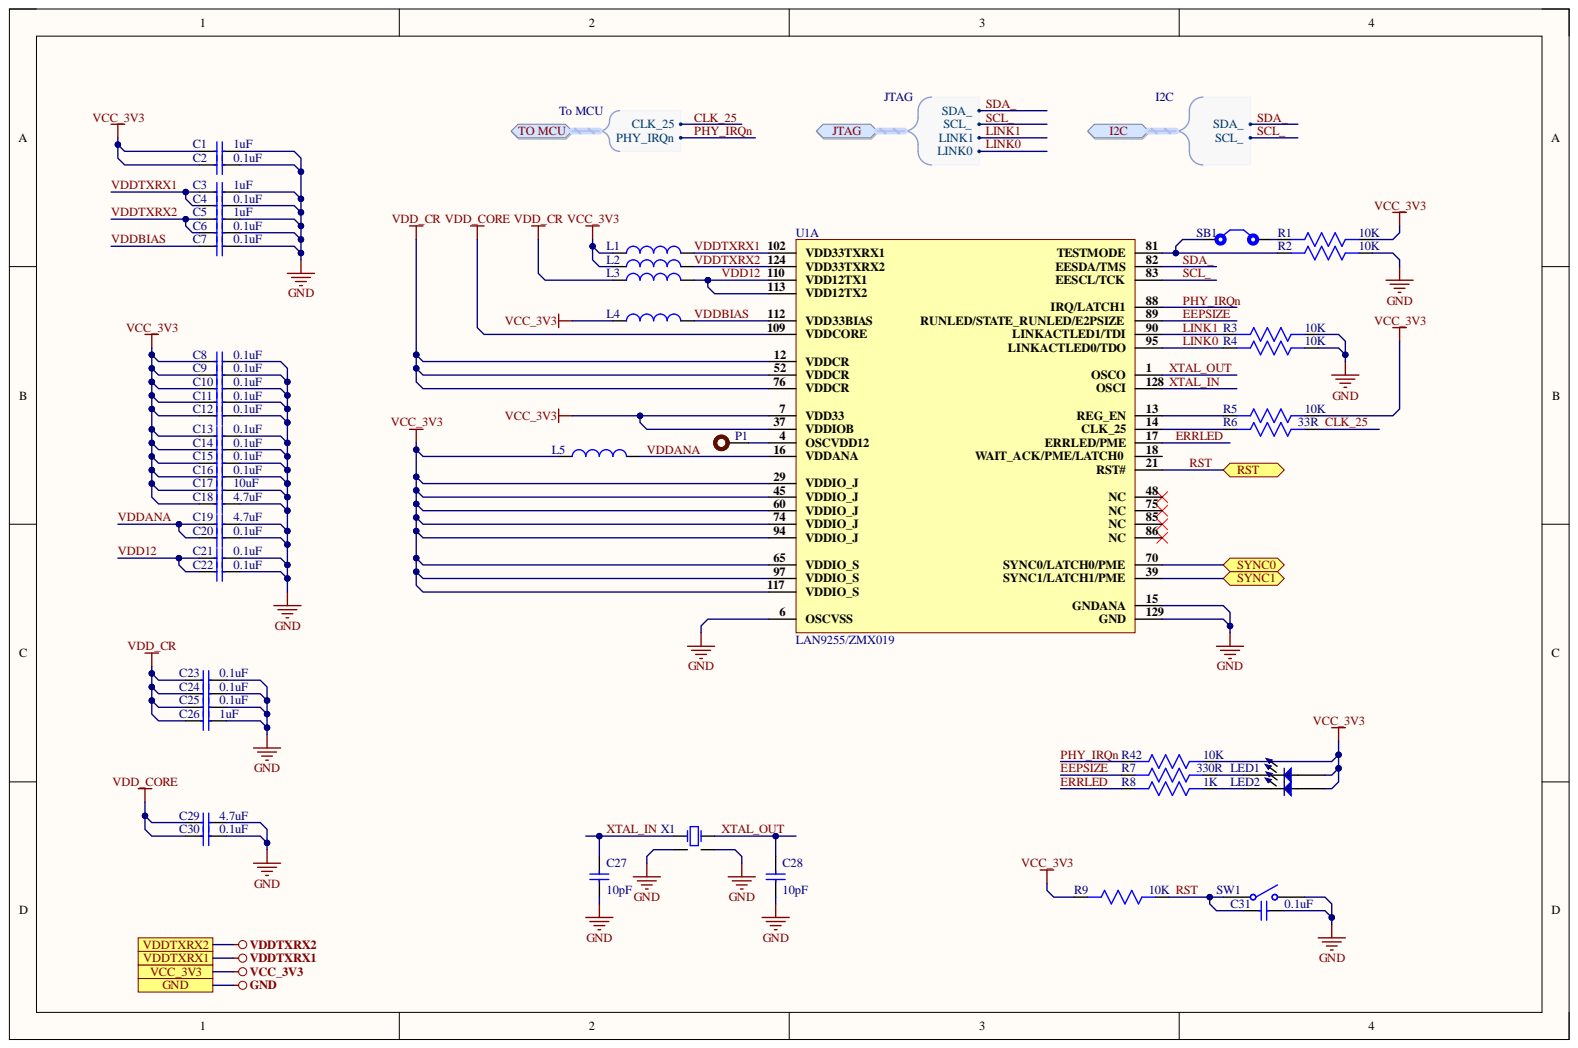
[picture p28: page 6]

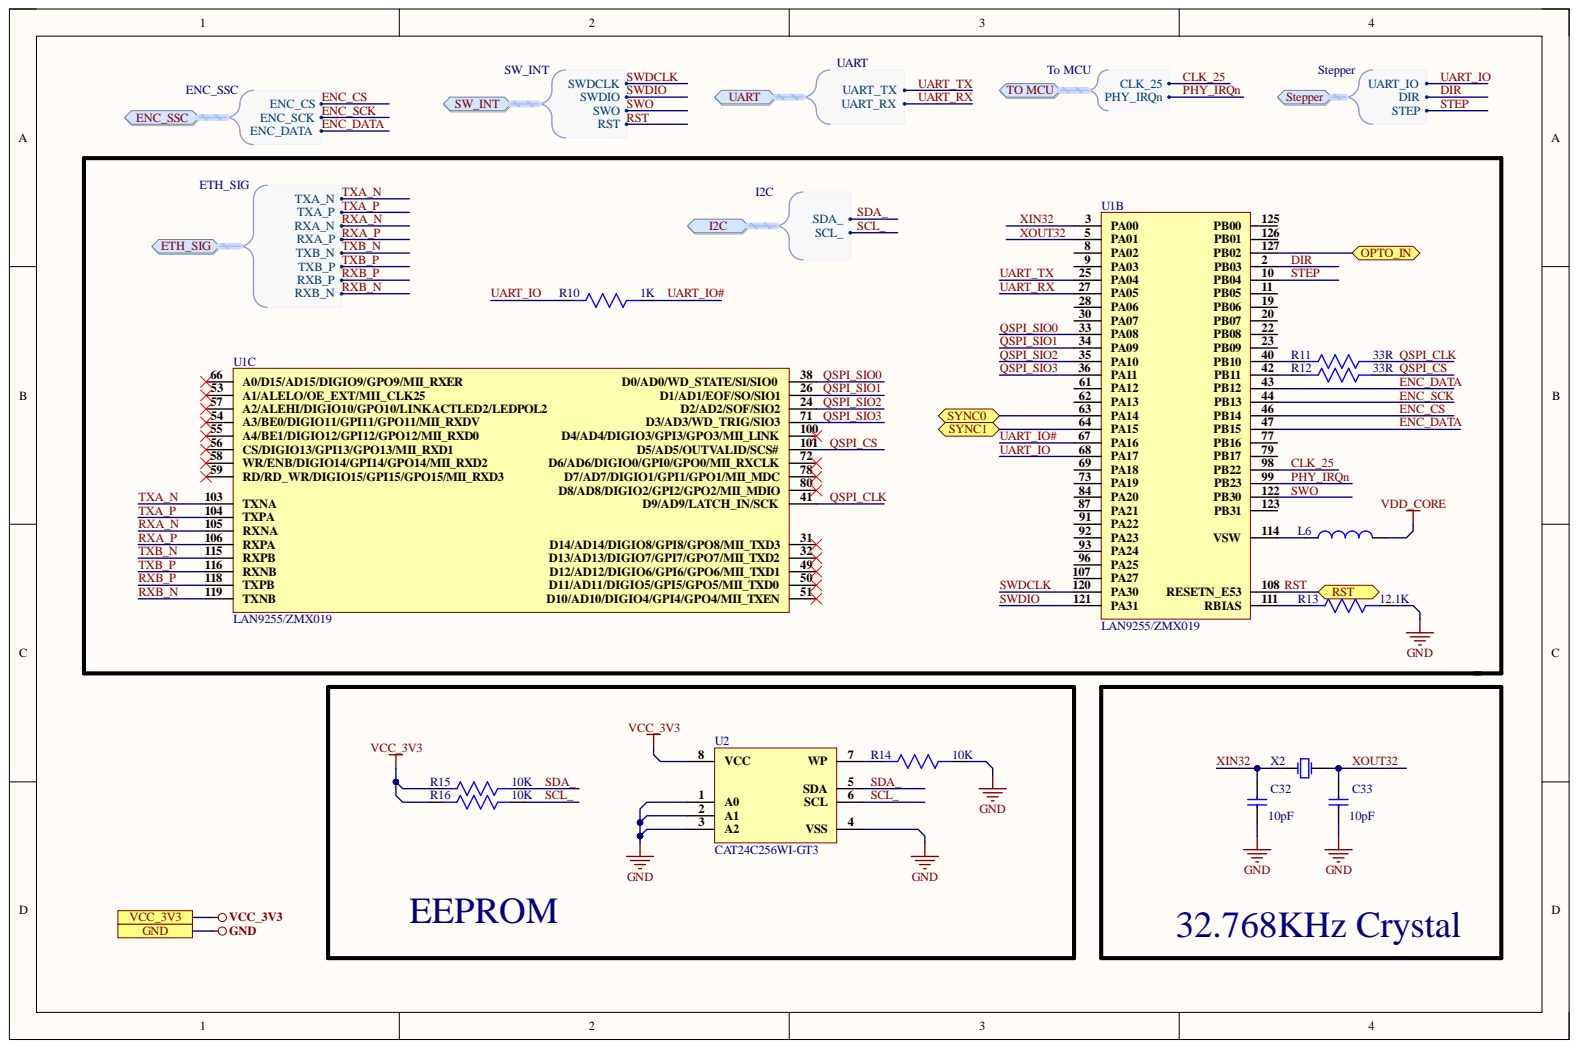
[picture p29: page 7]

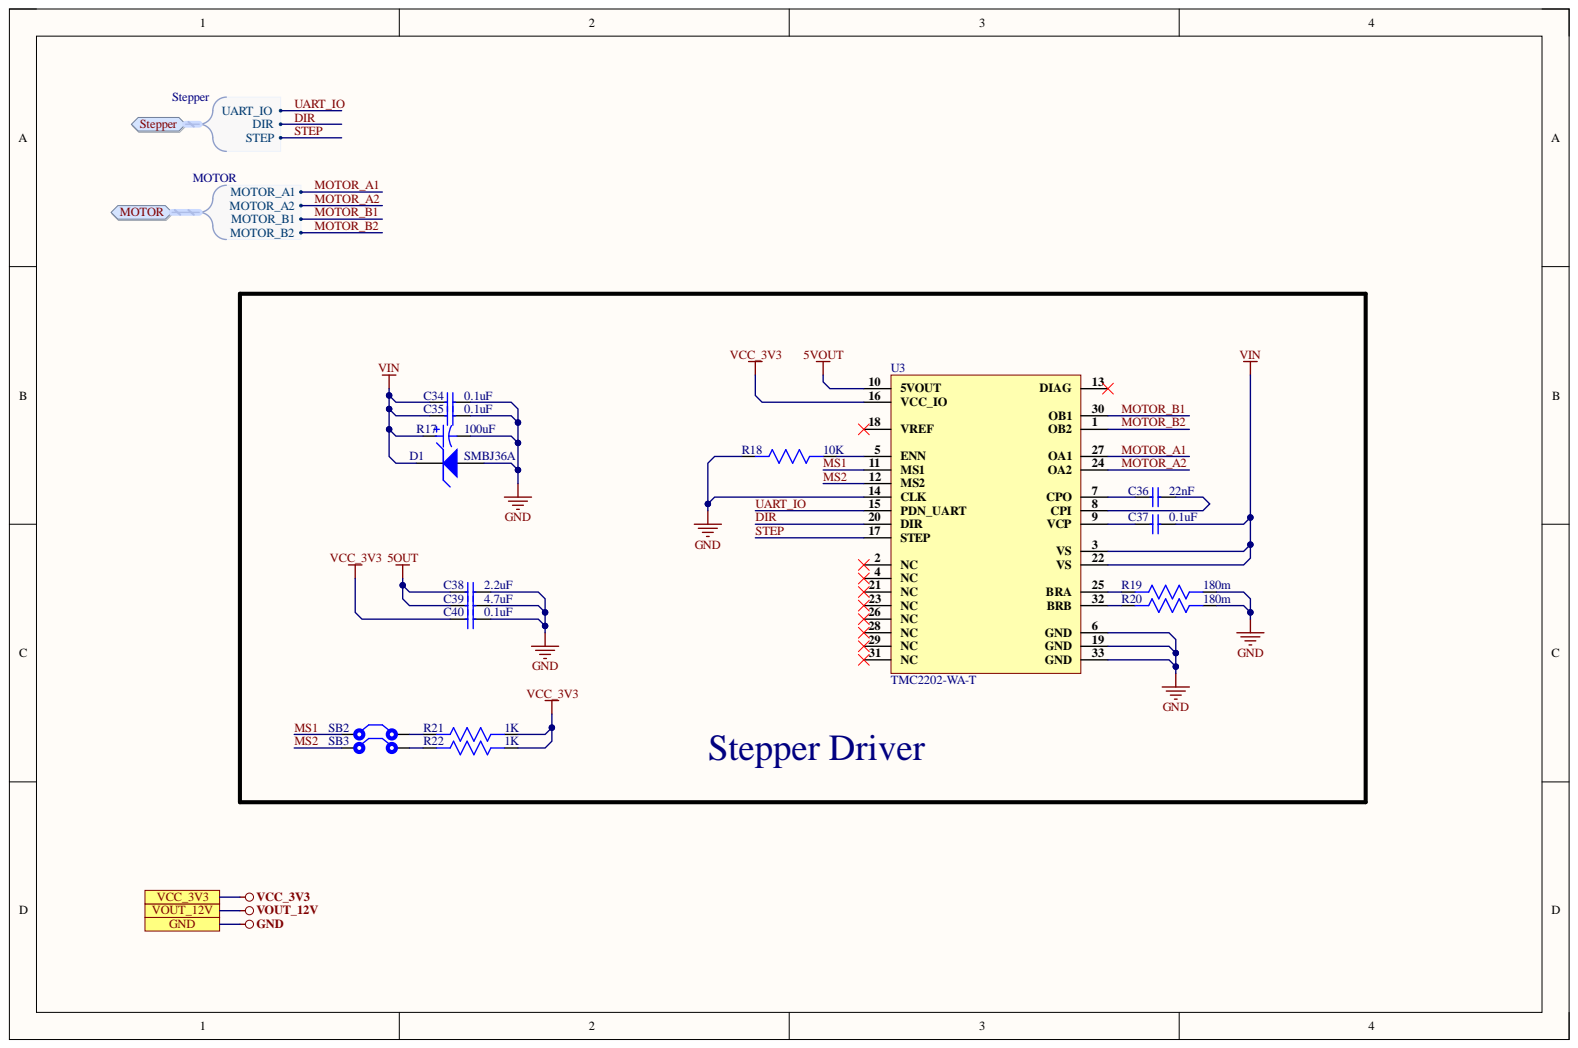
[picture p30: page 8]

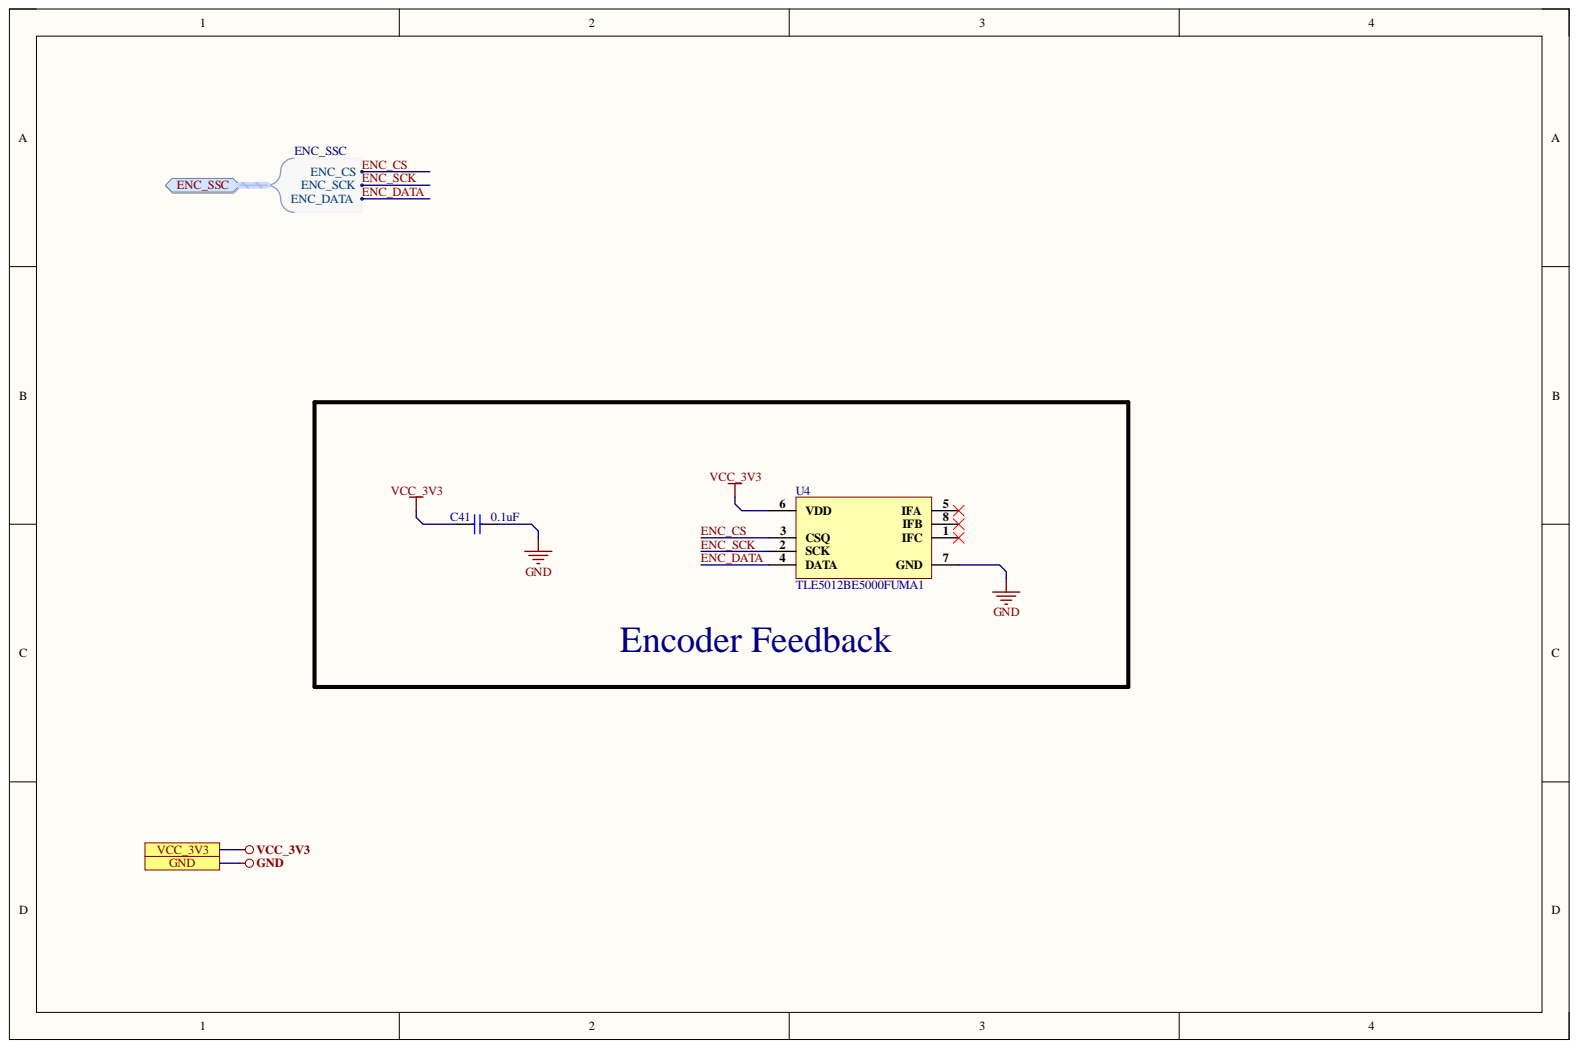
[picture p31: page 9]

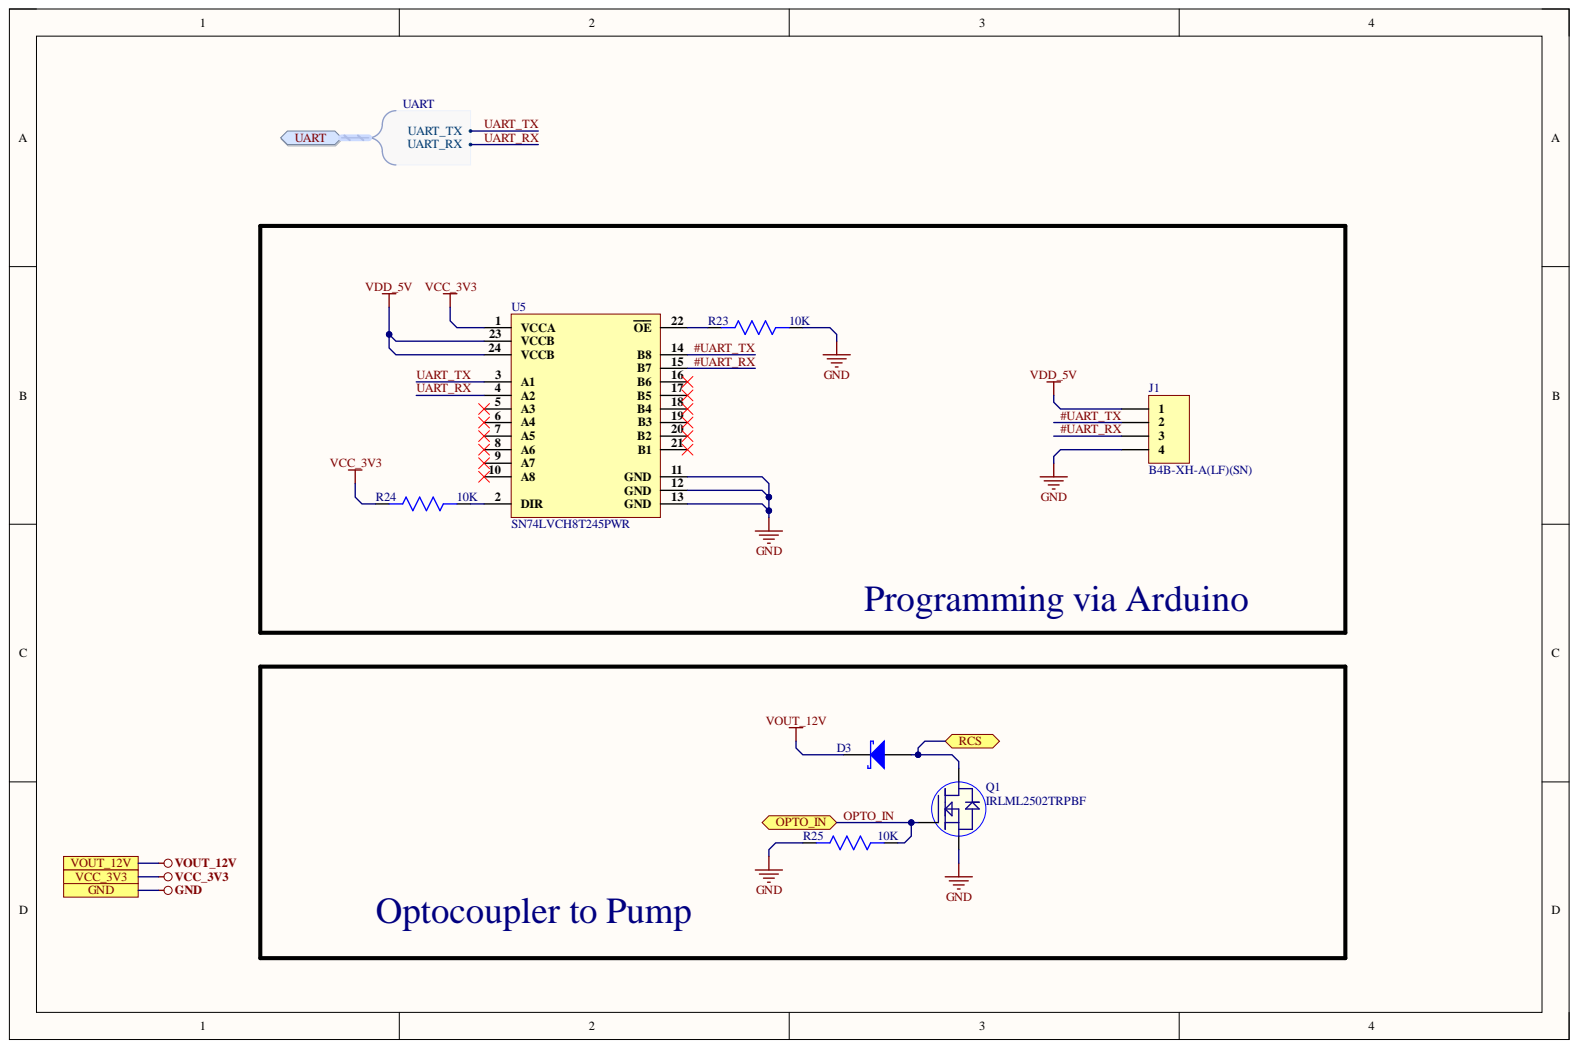
[picture p32: page 10]

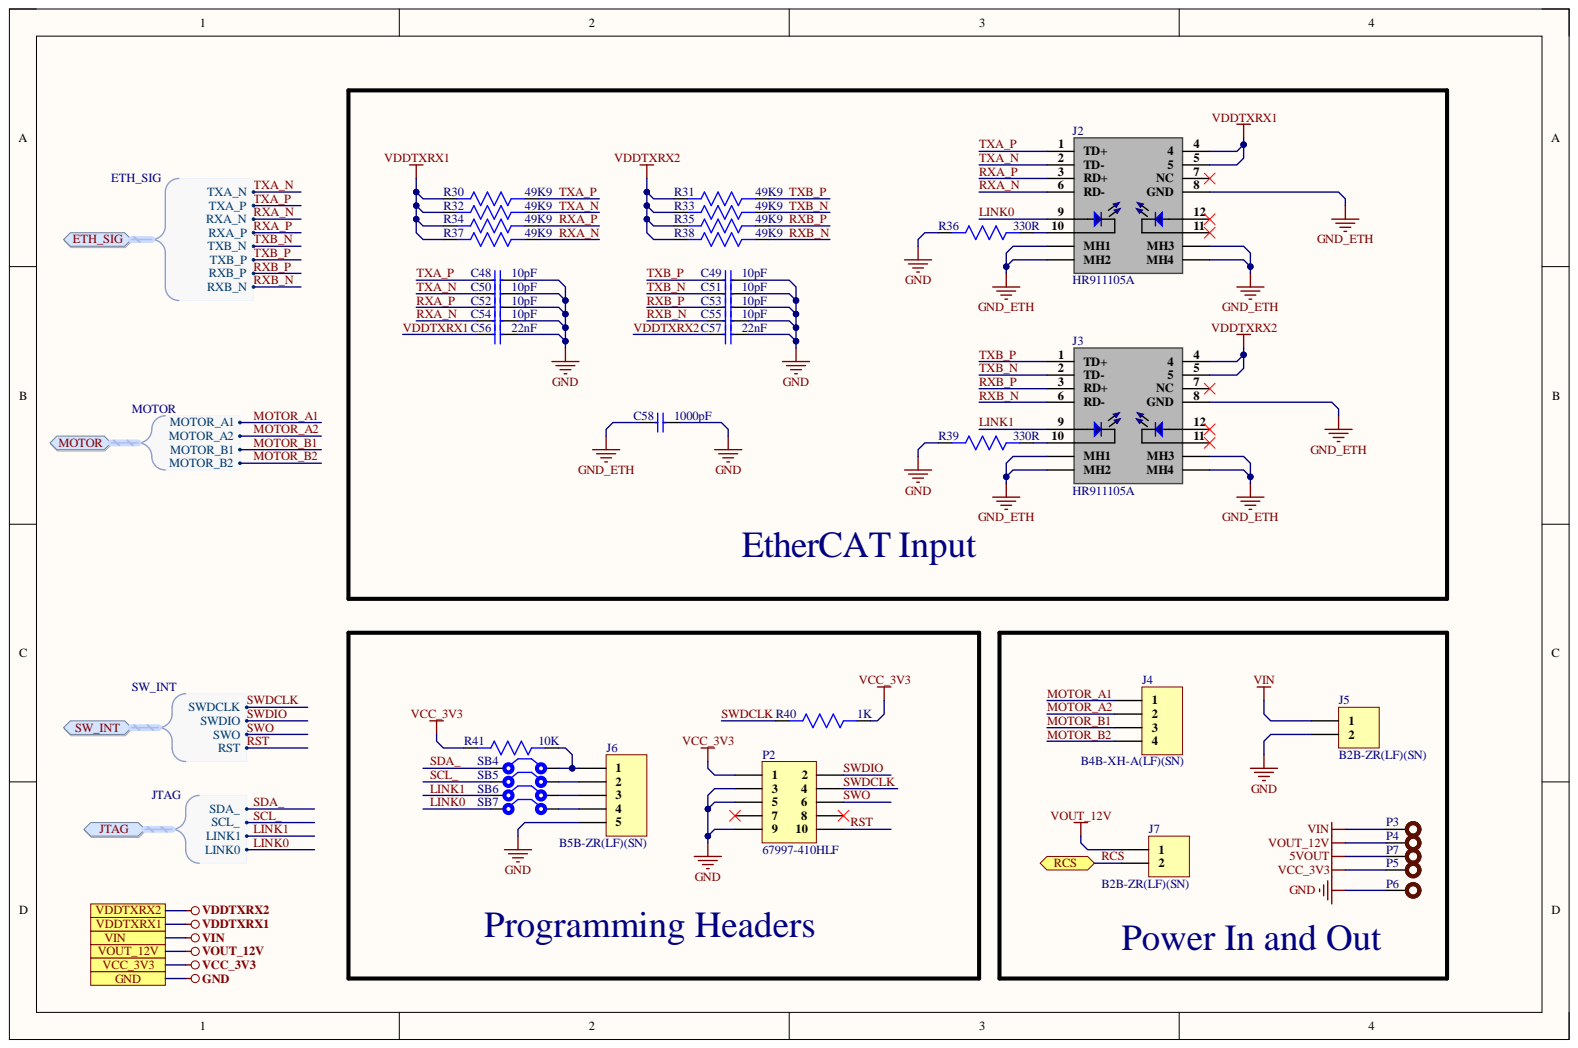
[picture p33: page 11]

Power In and Out
