eSpark-Backup/christian-raun-ethercat-design/Deliverables/Interface_Board/Assembly_Drawing/Interface_Board.pdf

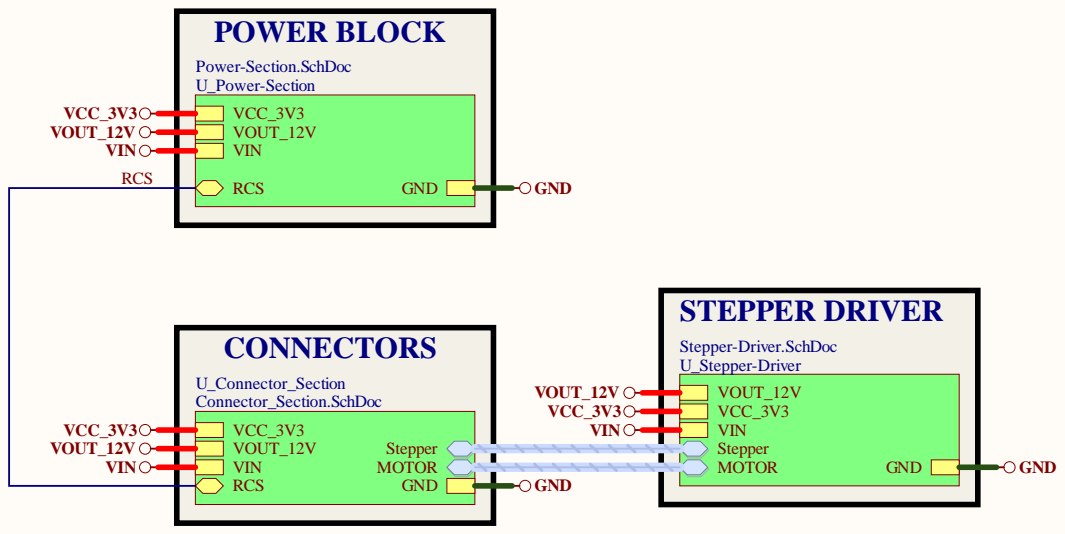
[picture p34: page 1]

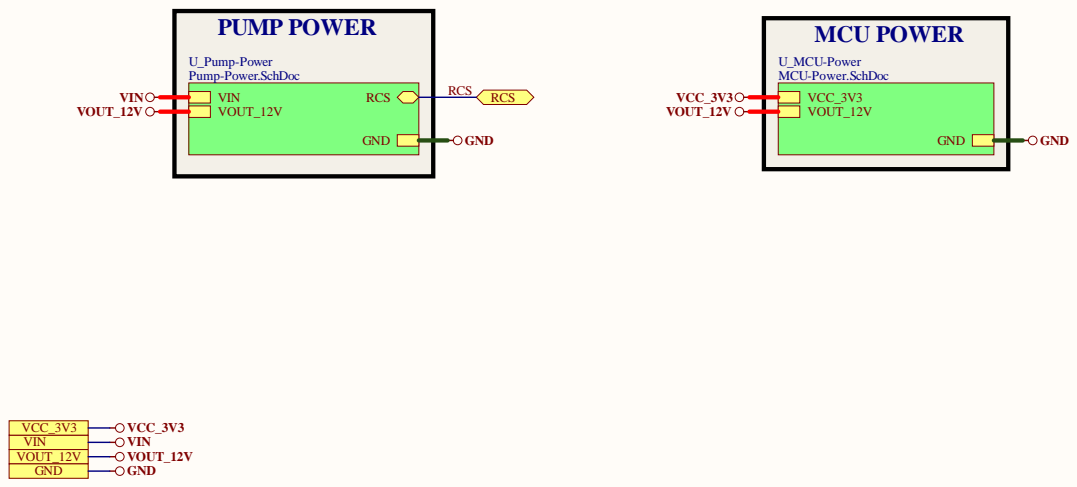
[picture p35: page 2]

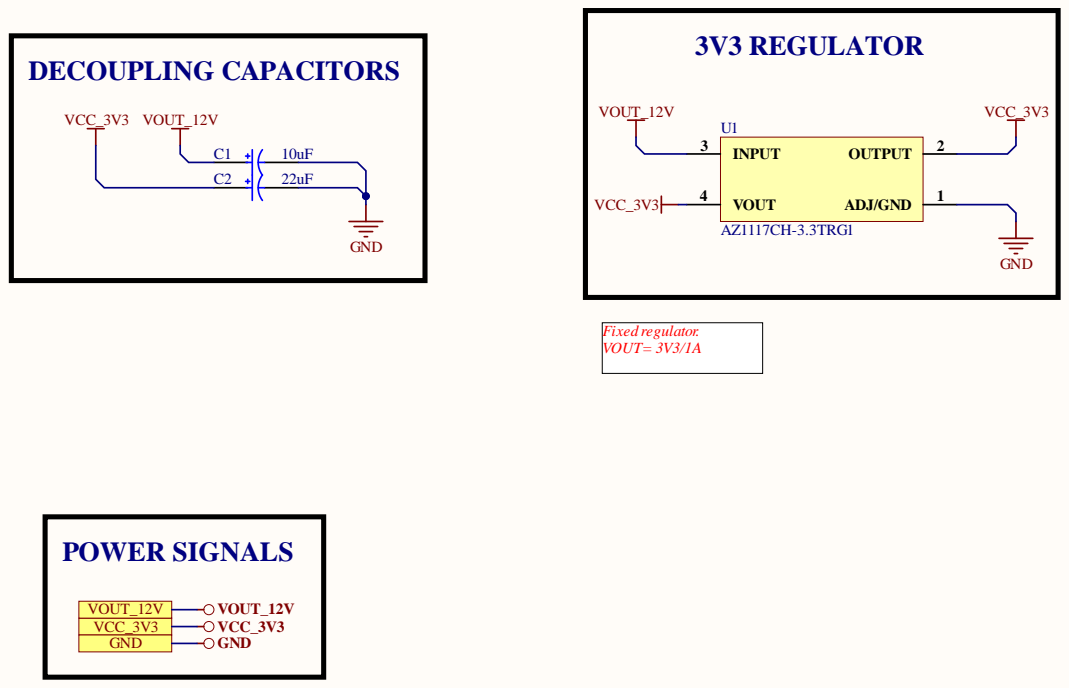
[picture p36: page 3]

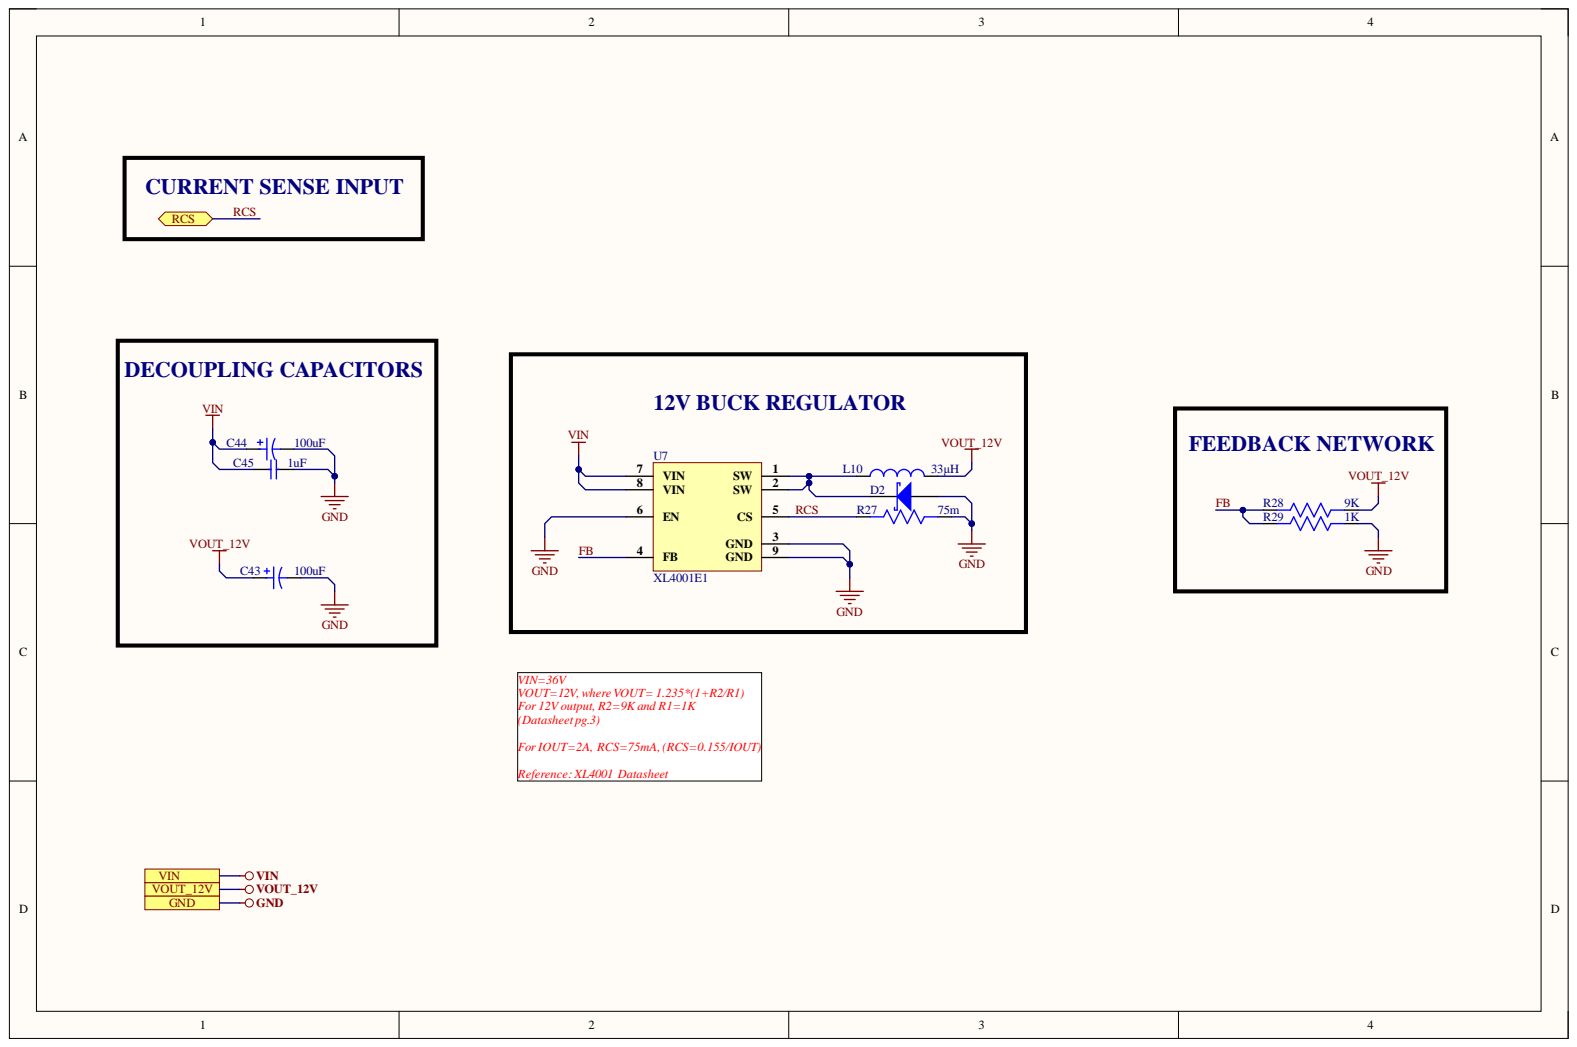
[picture p37: page 4]

For IOUT=2A, RCS=75mA,(RCS=0.155/IOUT)

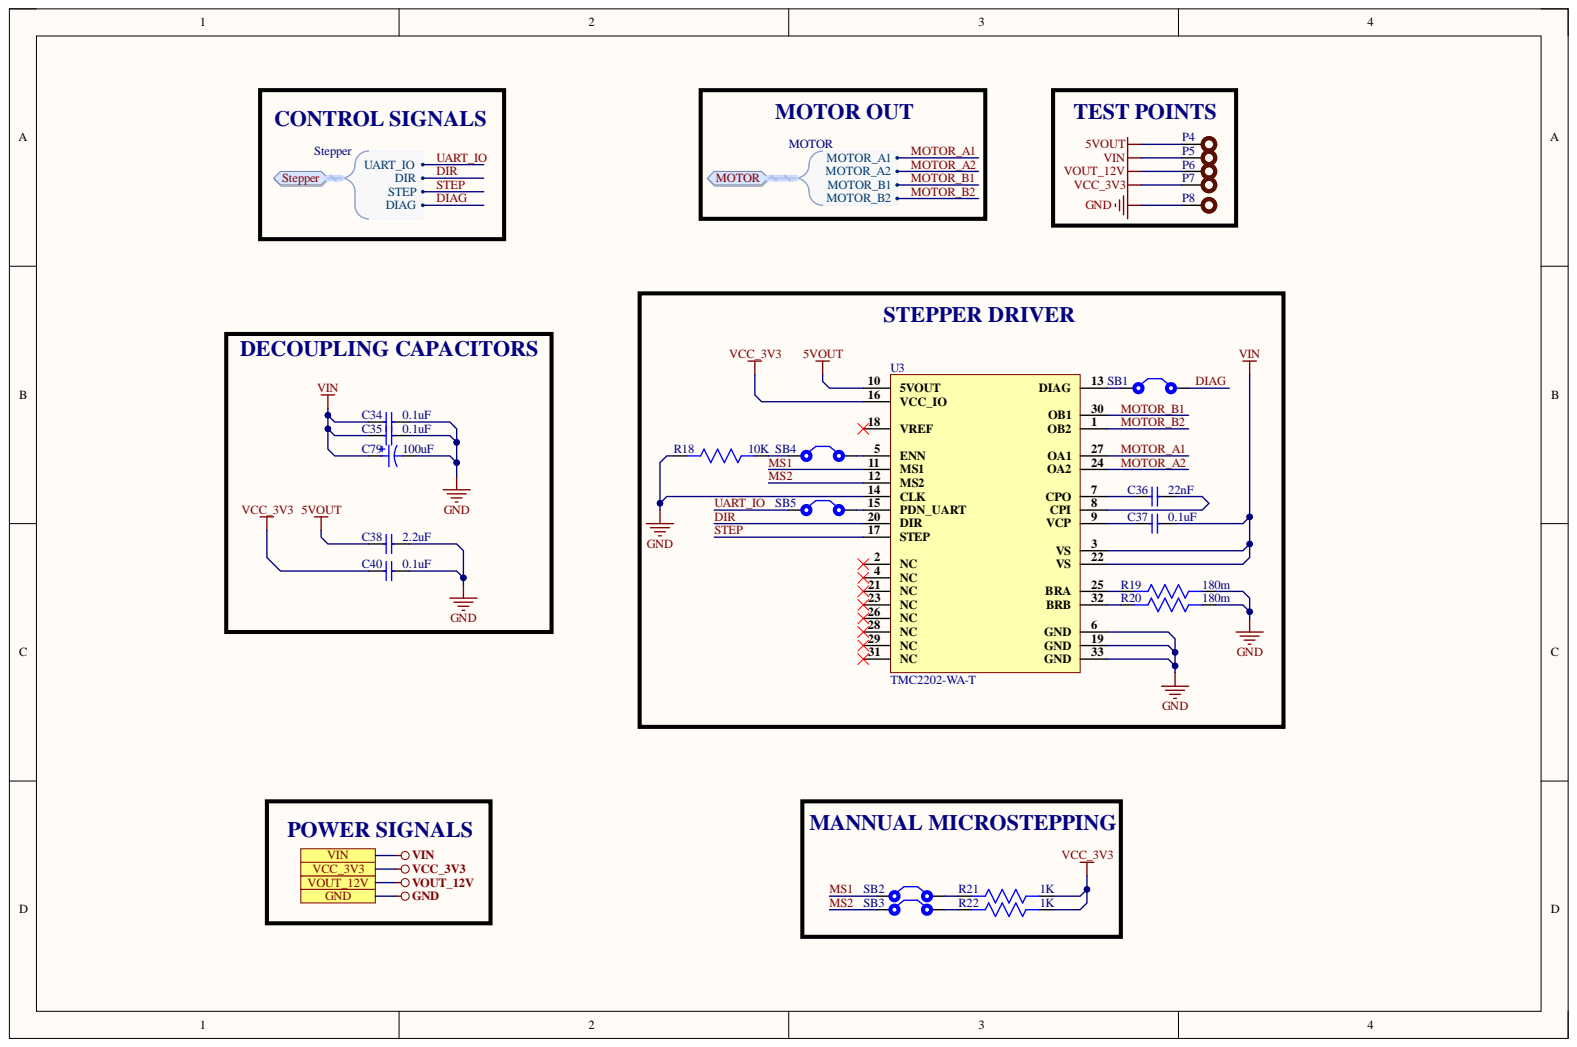
[picture p38: page 5]

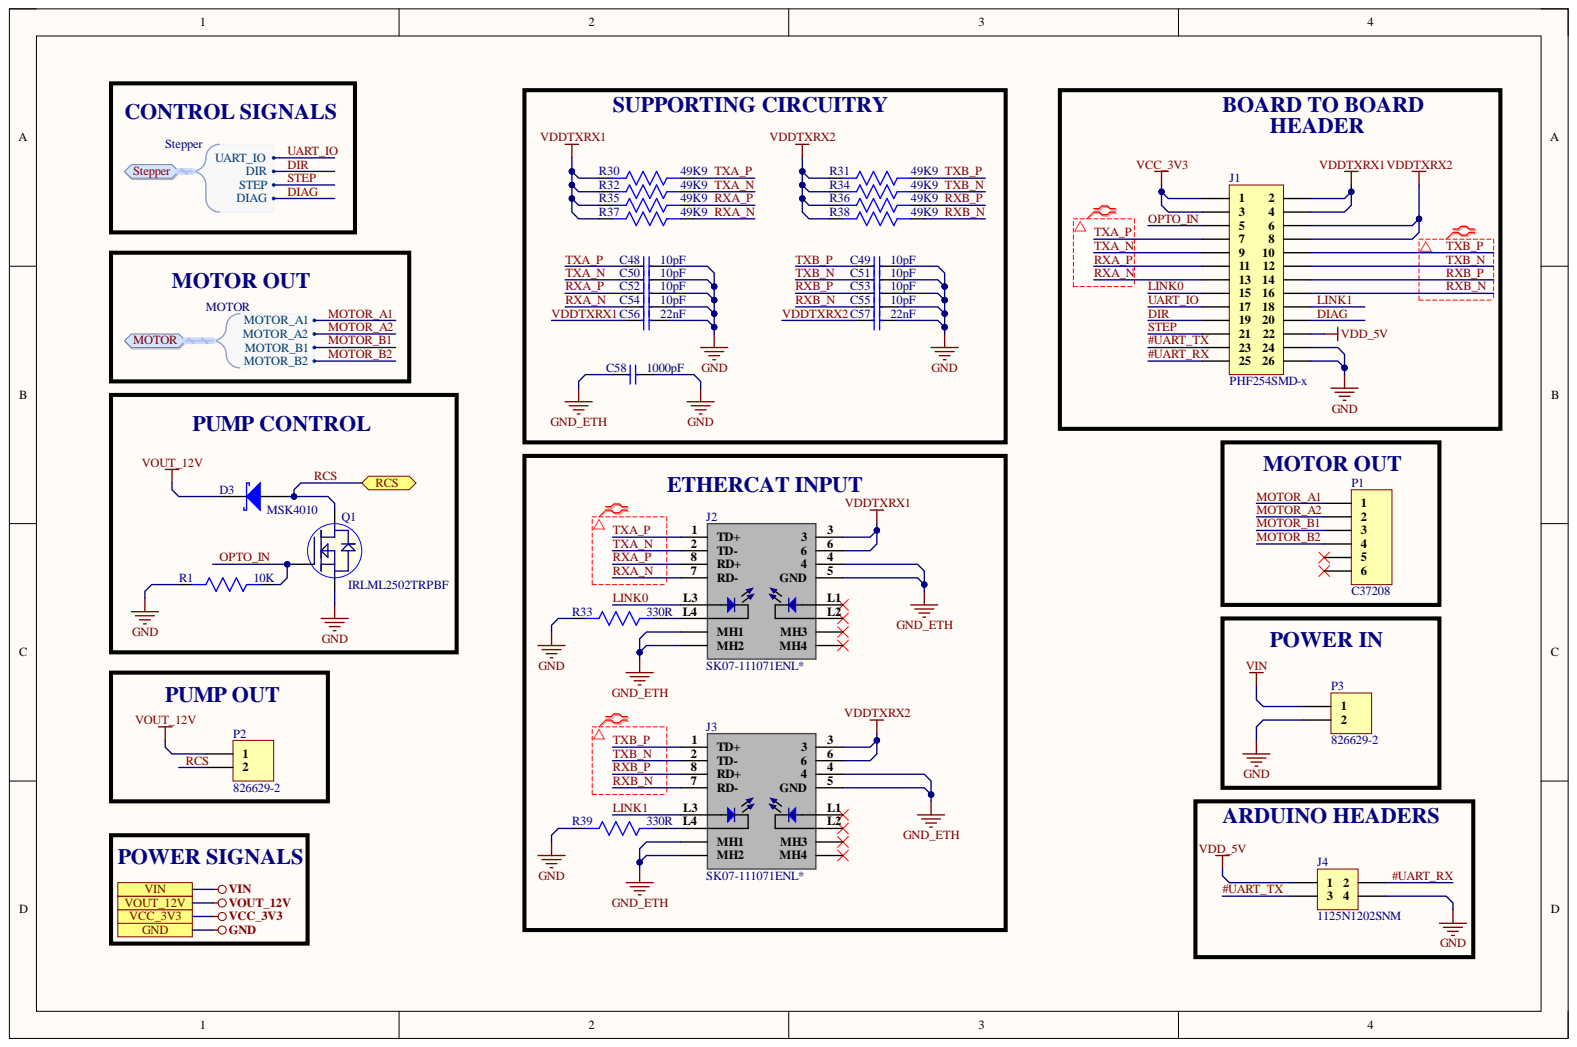
[picture p39: page 6]

RXB_P
RXB_N

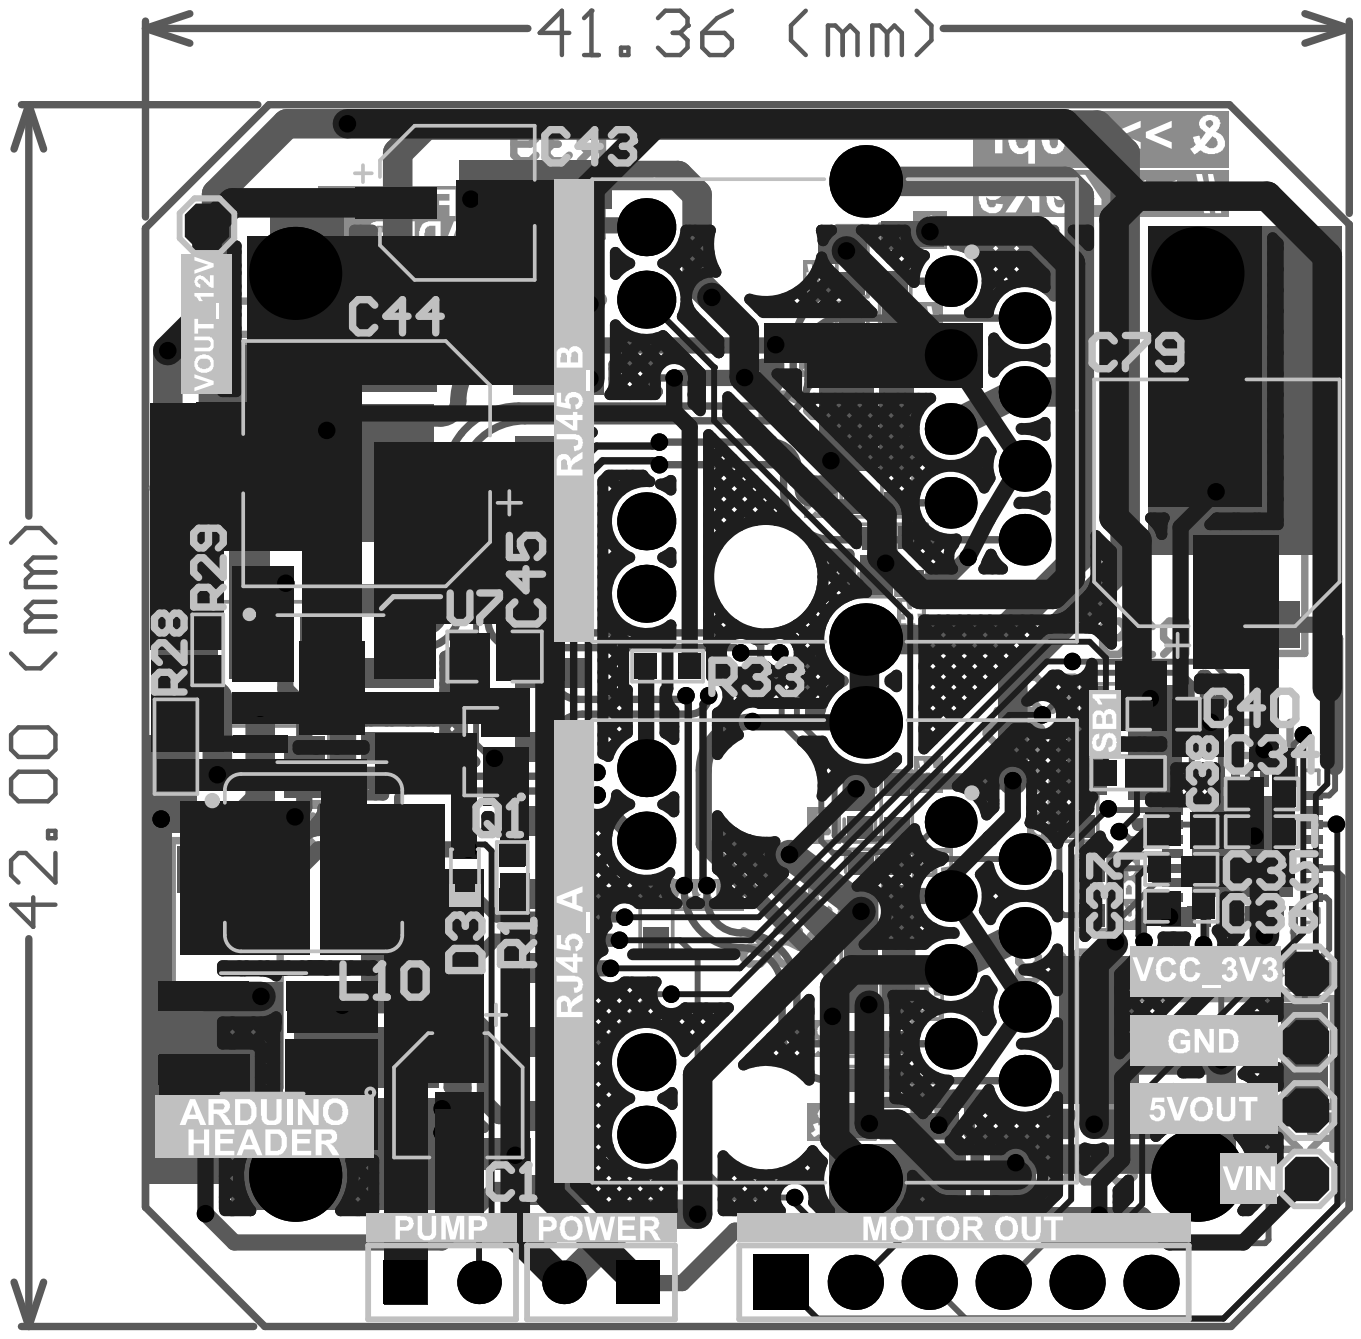
[picture p40: page 7]
