eSpark-Backup/christian-raun-ethercat-design/Deliverables/Control_Board/Assembly_Drawing/Control_Board.pdf

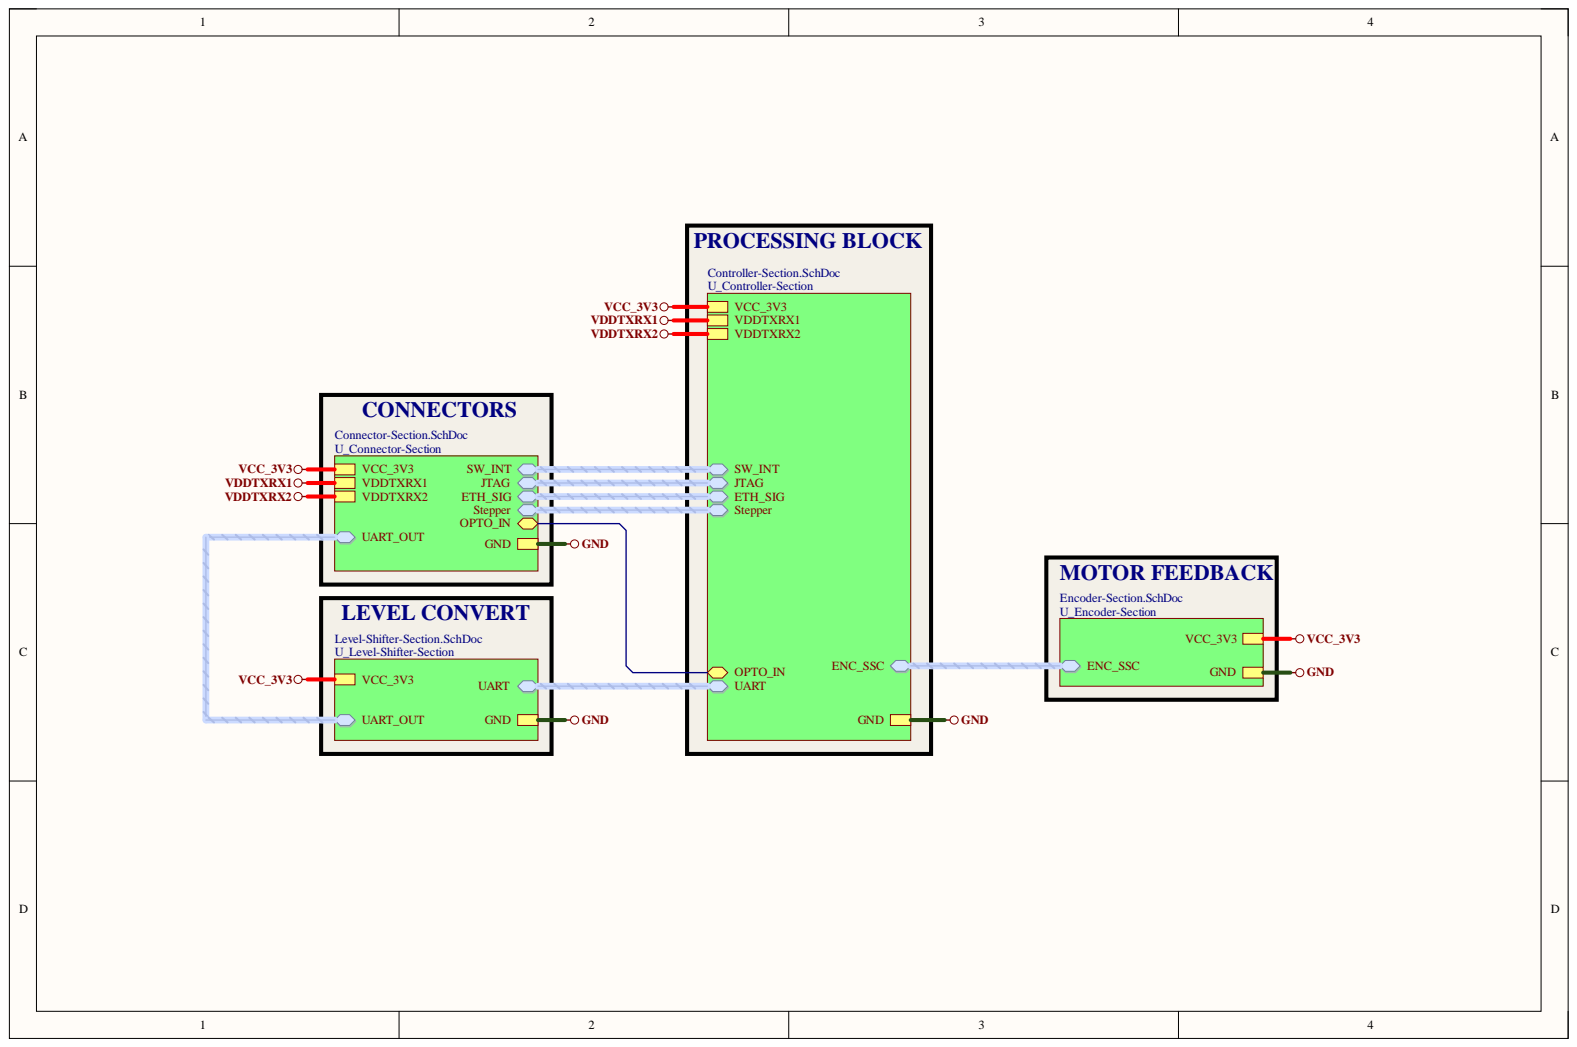
[picture p41: page 1]

Level-Shifter-Section.SchDoc
U_Level-Shifter-Section

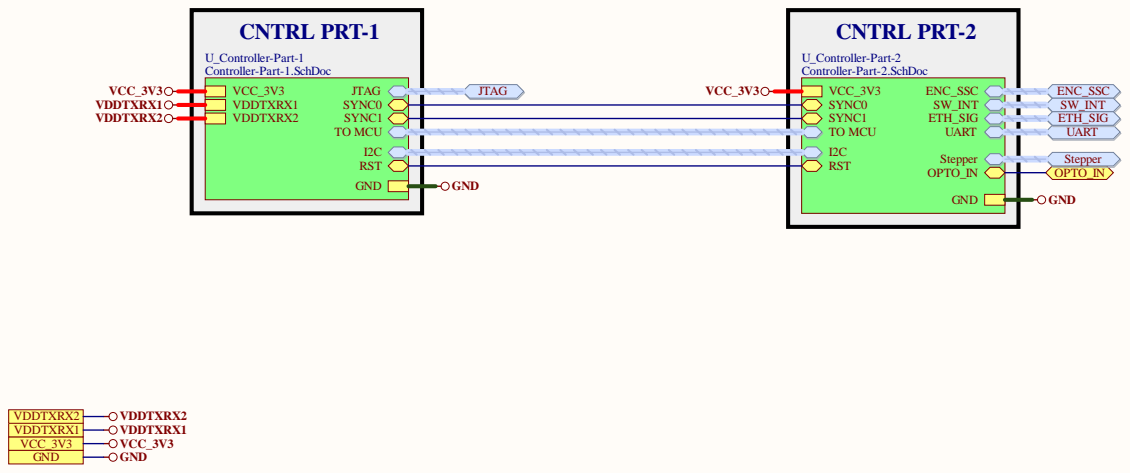
[picture p42: page 2]

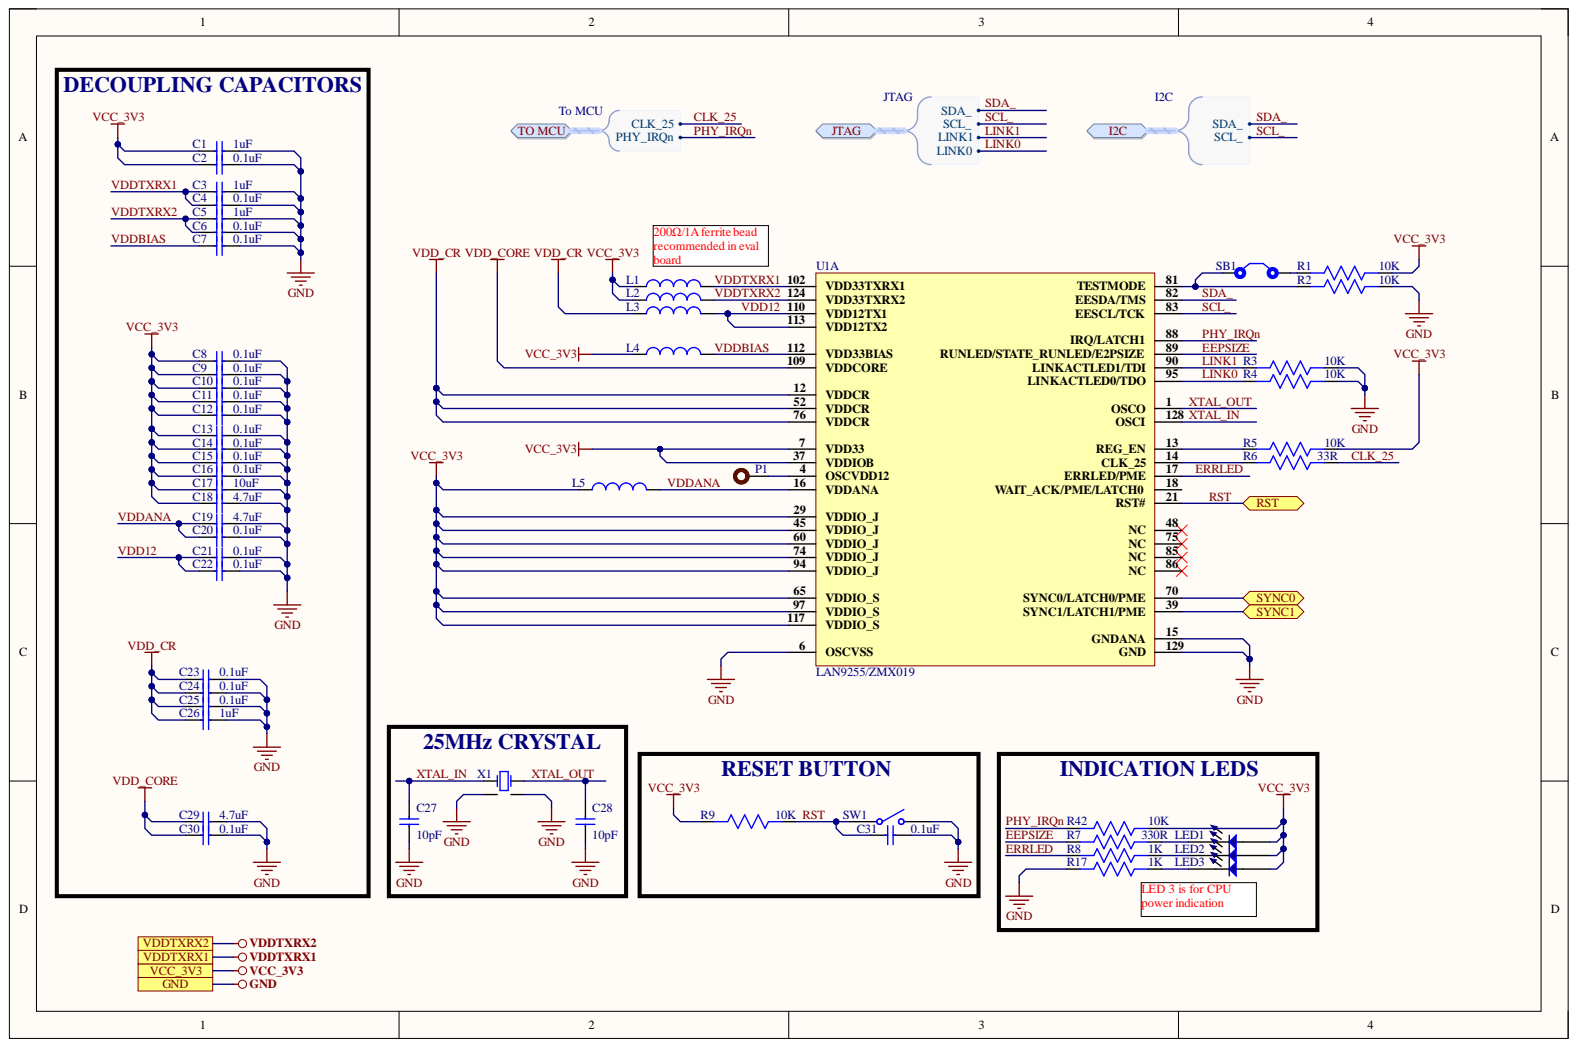
[picture p43: page 3]

LED 3 is for CPU
power indication

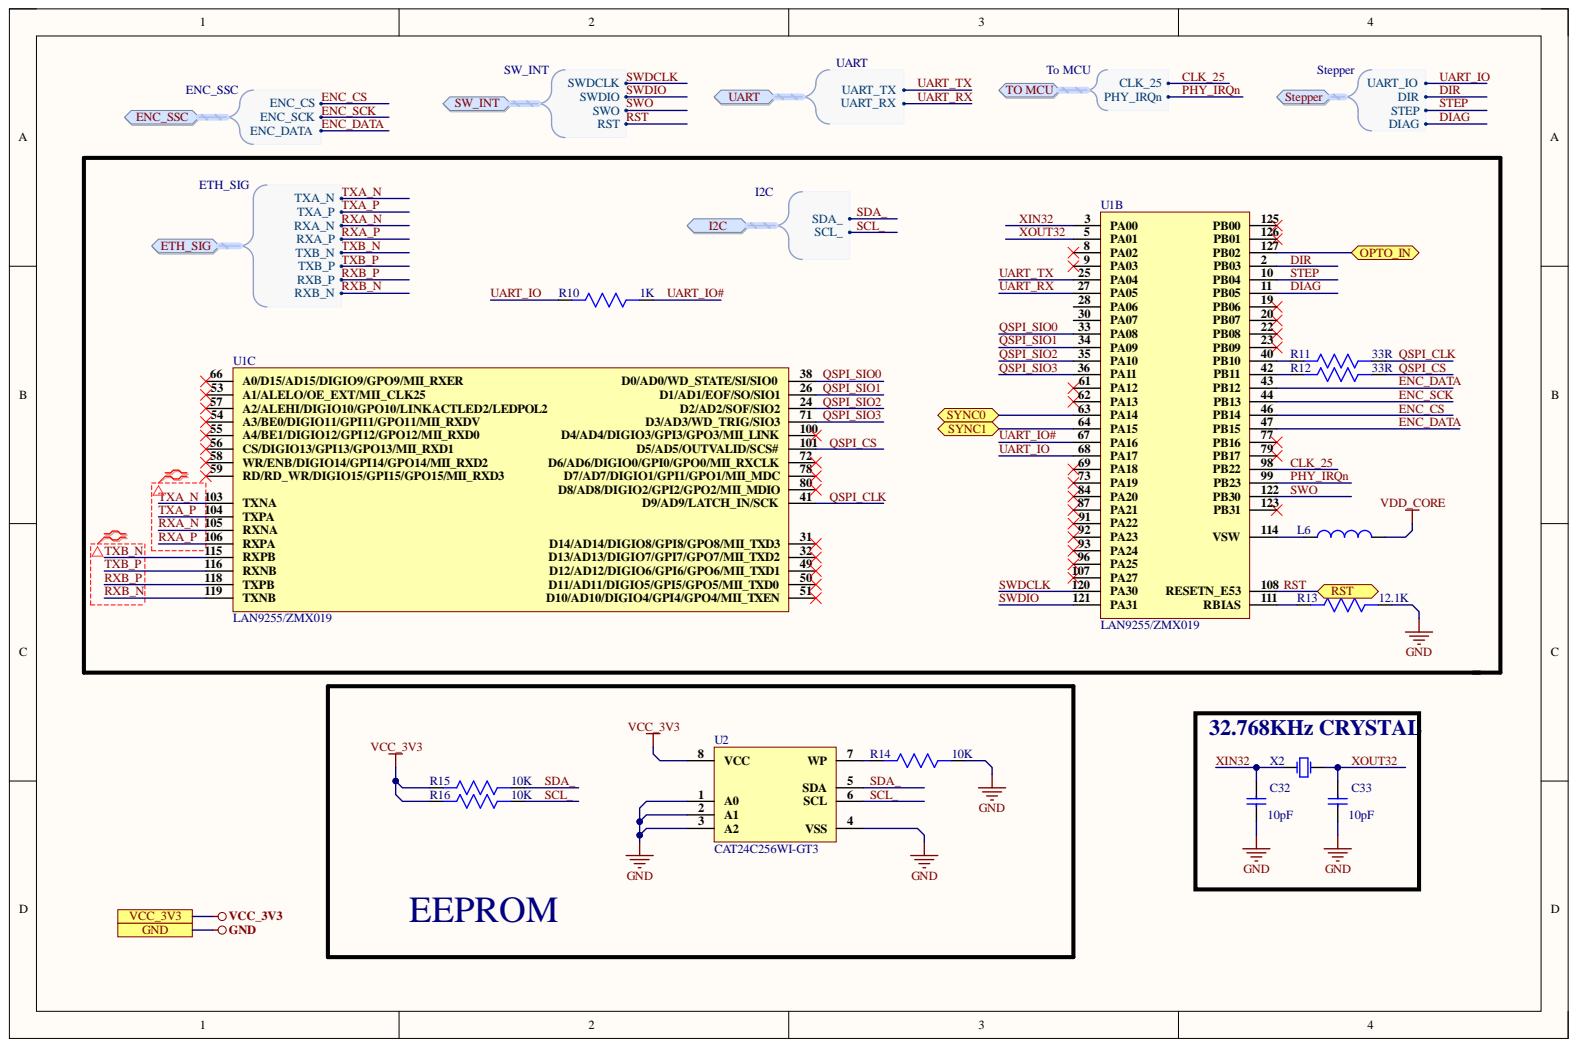
[picture p44: page 4]

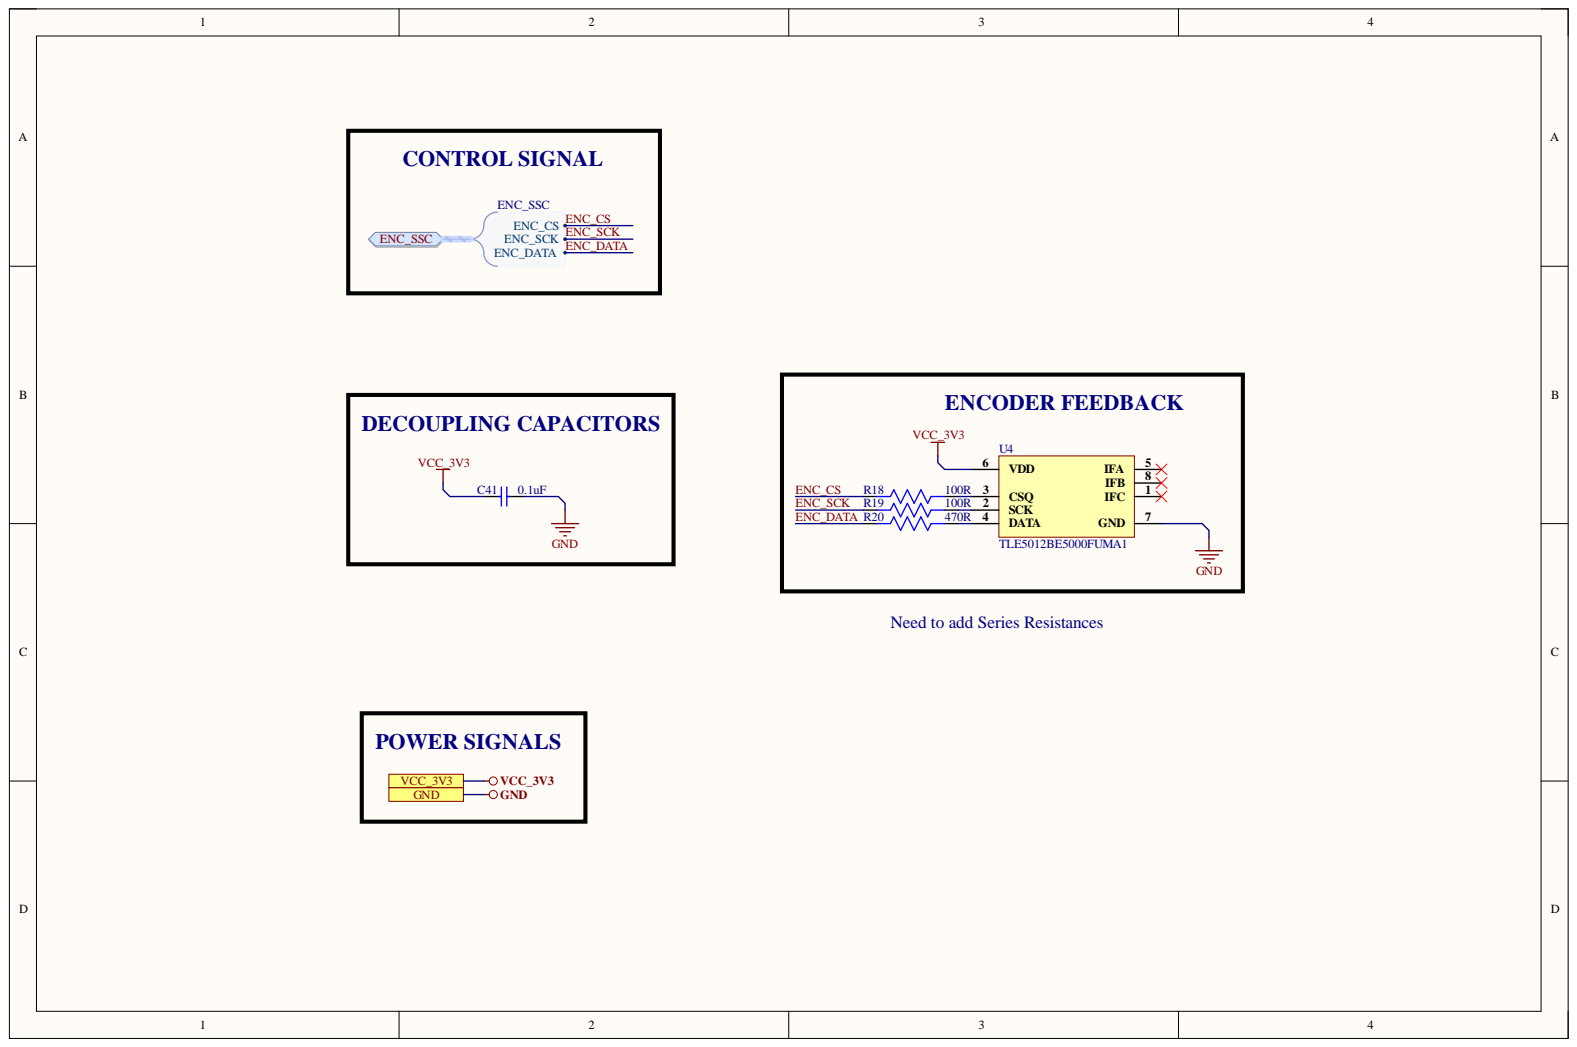
[picture p45: page 5]

Need to add Series Resistances

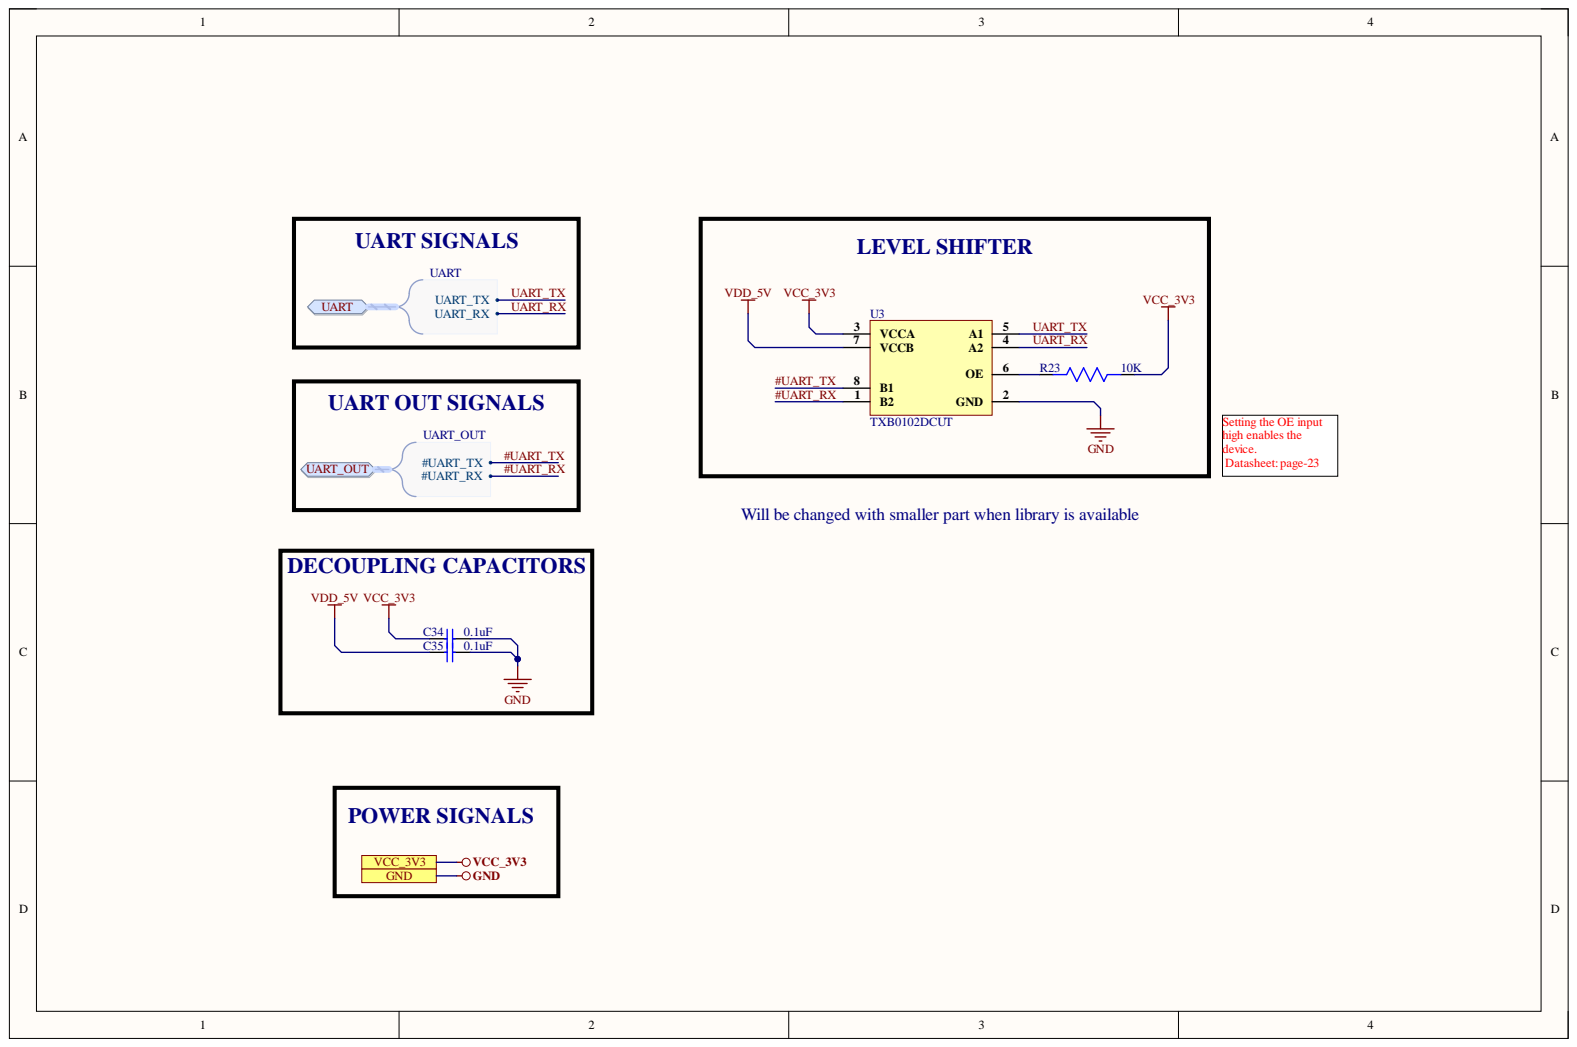
[picture p46: page 6]

Setting the OE input
high enables the
device.
Datasheet: page-23

Will be changed with smaller part when library is available

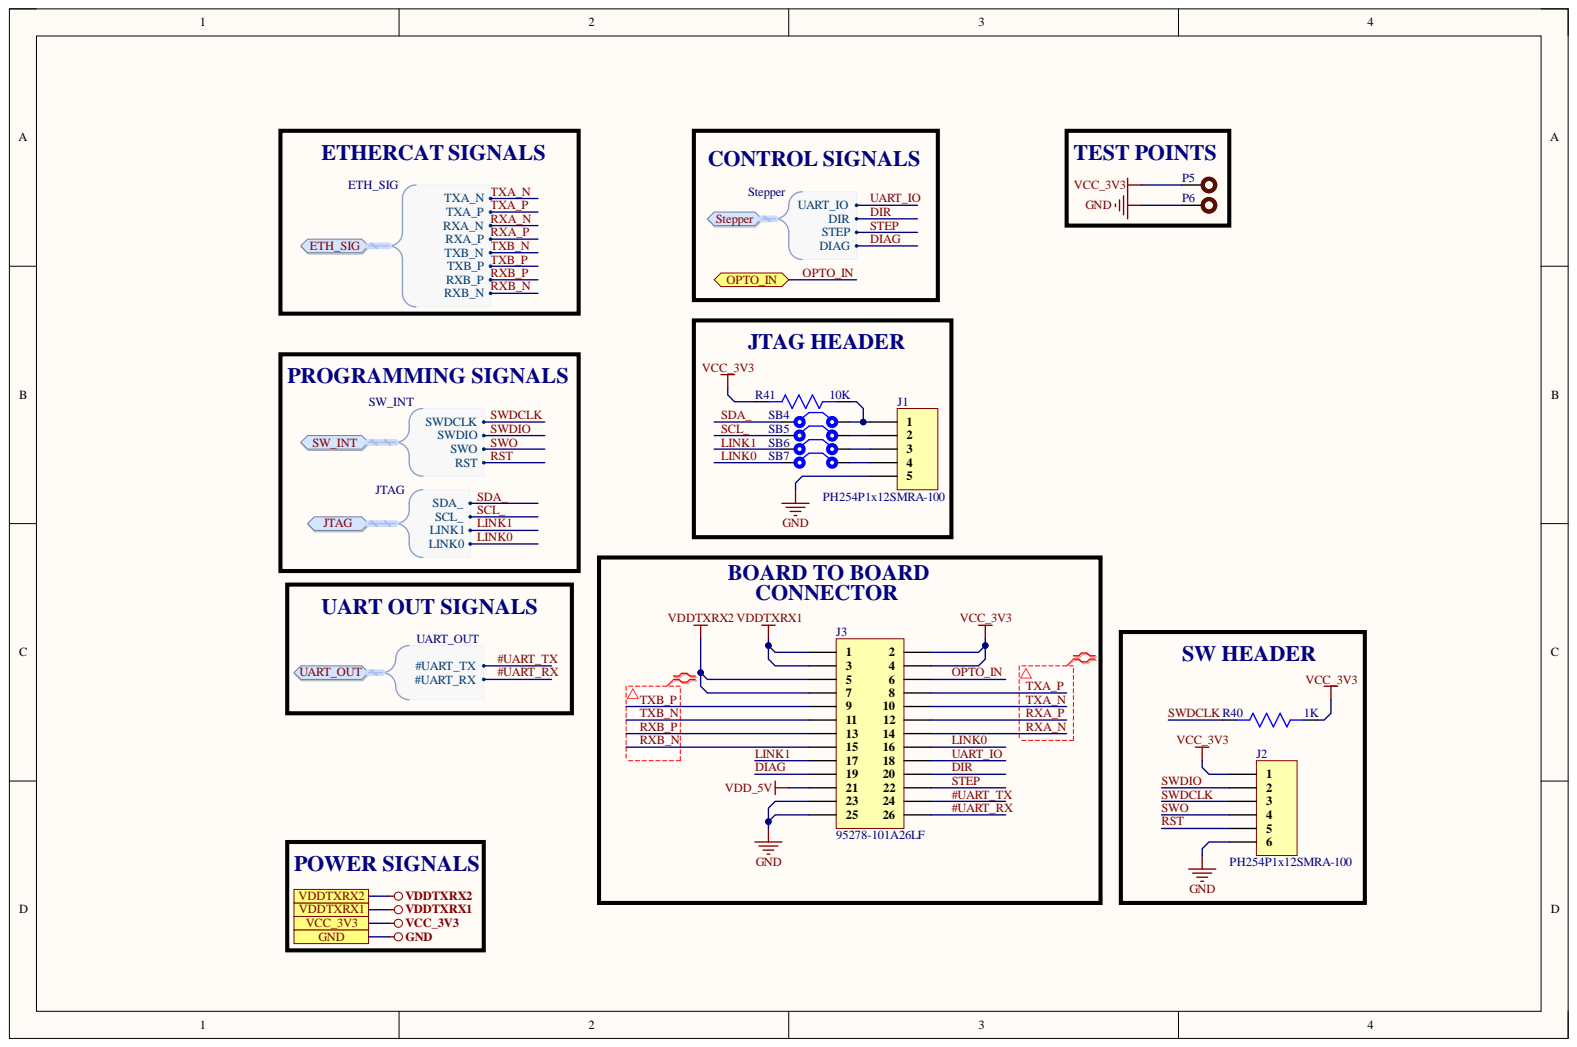
[picture p47: page 7]

TXB_N | RXA_P
RXB_P | RXA_N
RXB_N

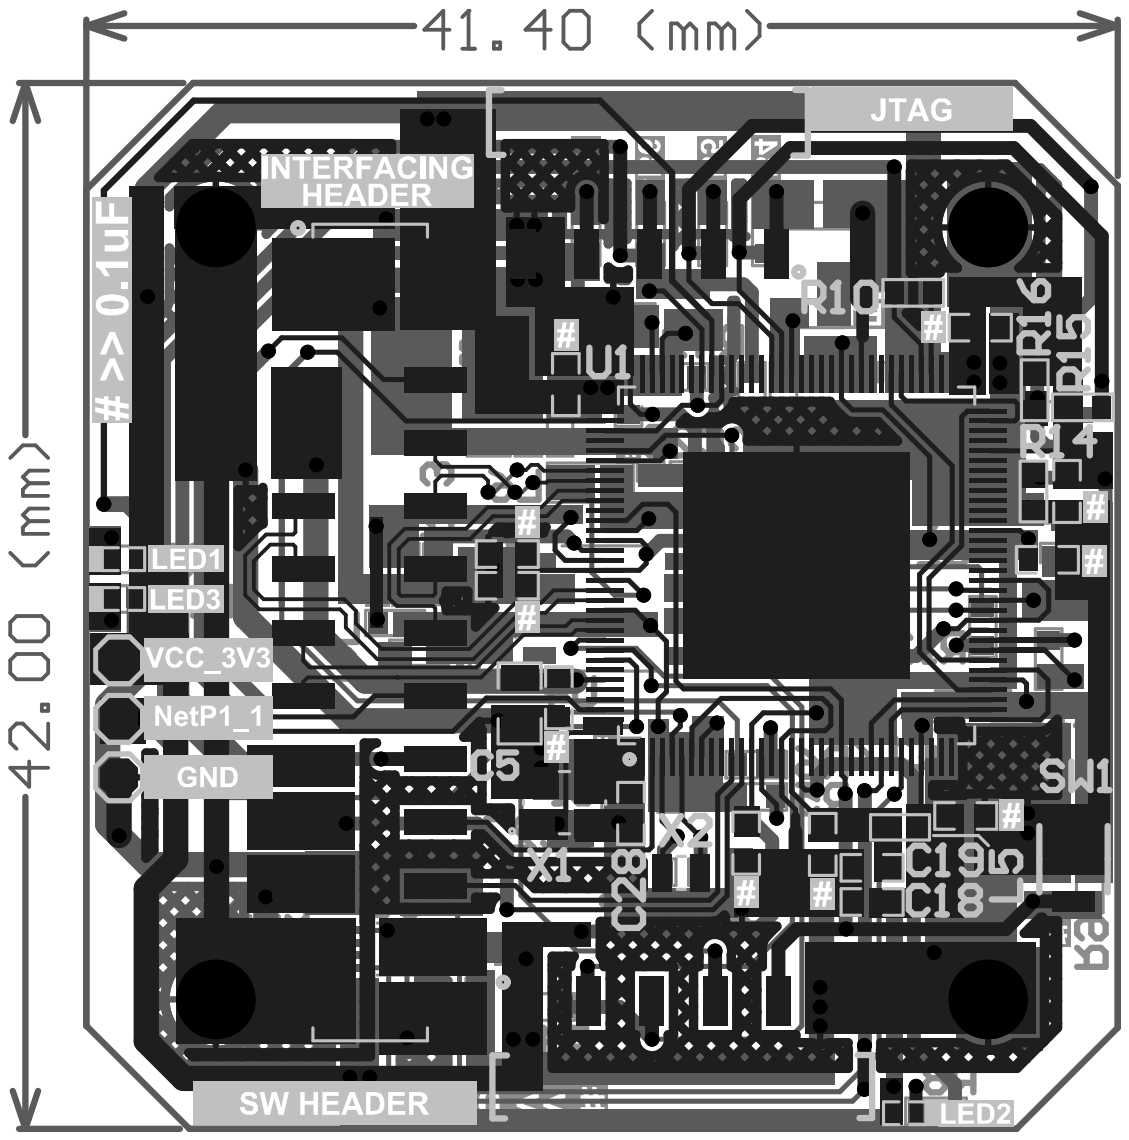
[picture p48: page 8]
