eSpark-Backup/christian-raun-ethercat-design/Deliverables/Interface_Board/Assembly_Drawing/Assembly_Drawing.pdf

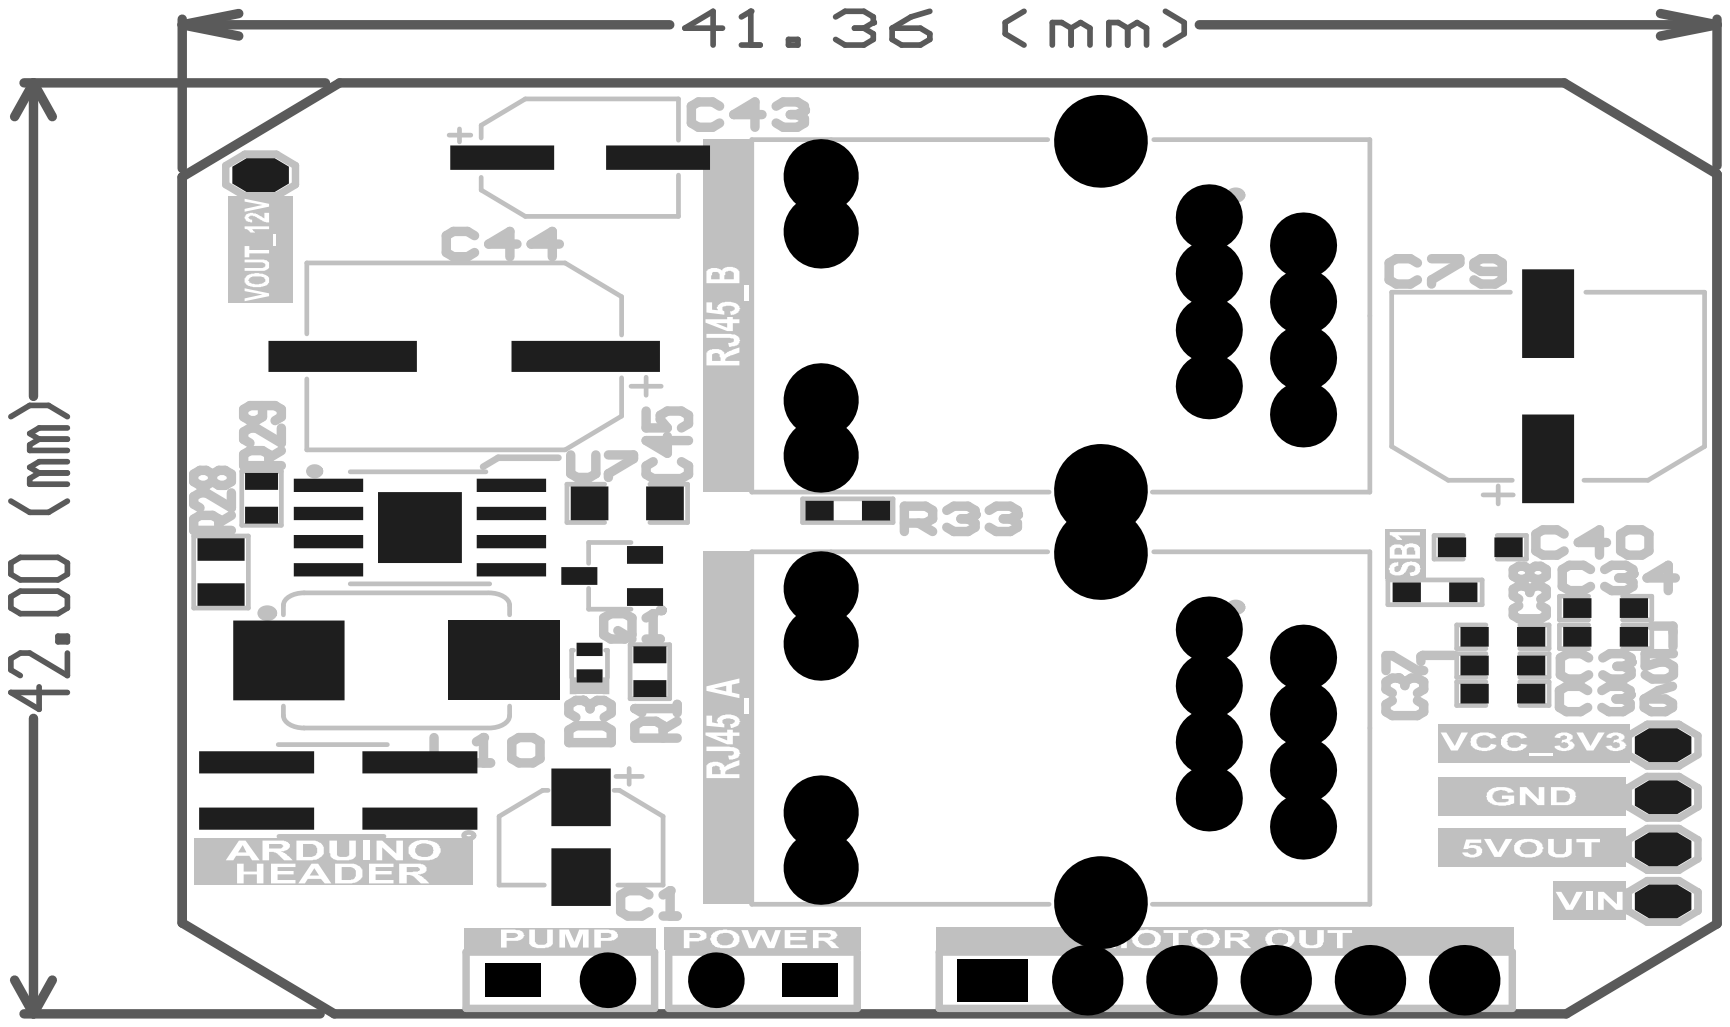
[picture p49: page 1]

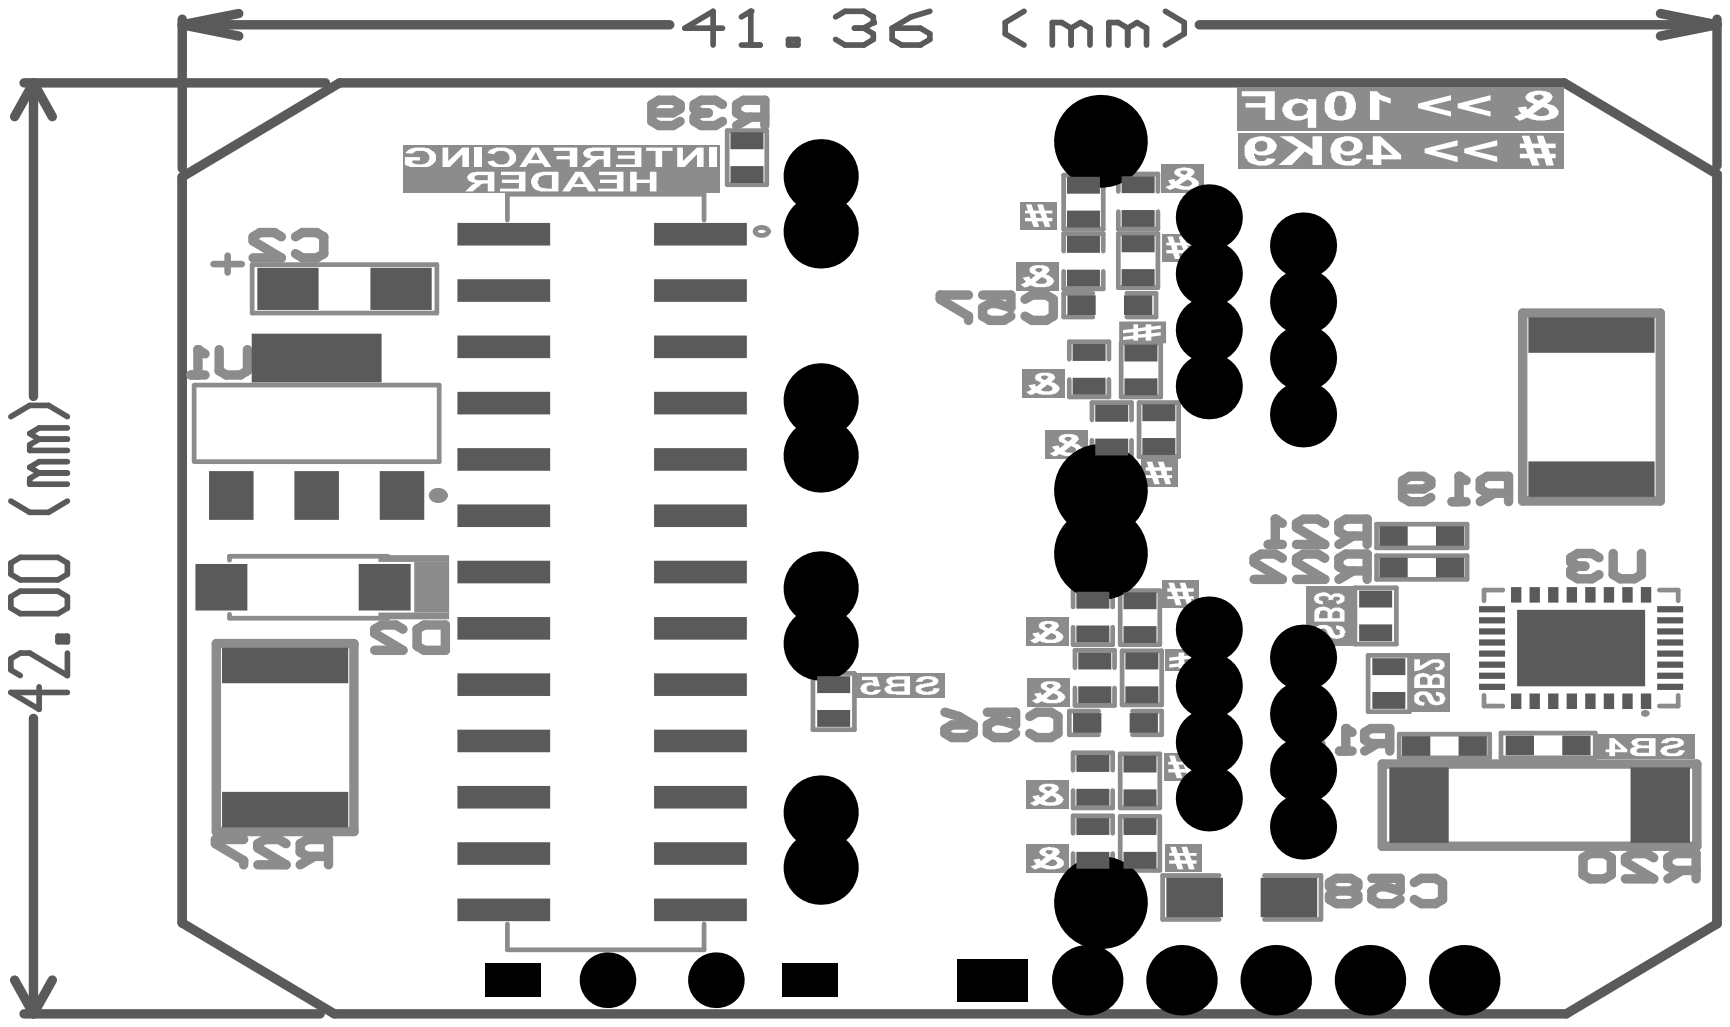
[picture p50: page 2]
