eSpark-Backup/christian-raun-ethercat-design/Deliverables/Control_Board/Assembly_Drawing/Assembly_Drawing.pdf

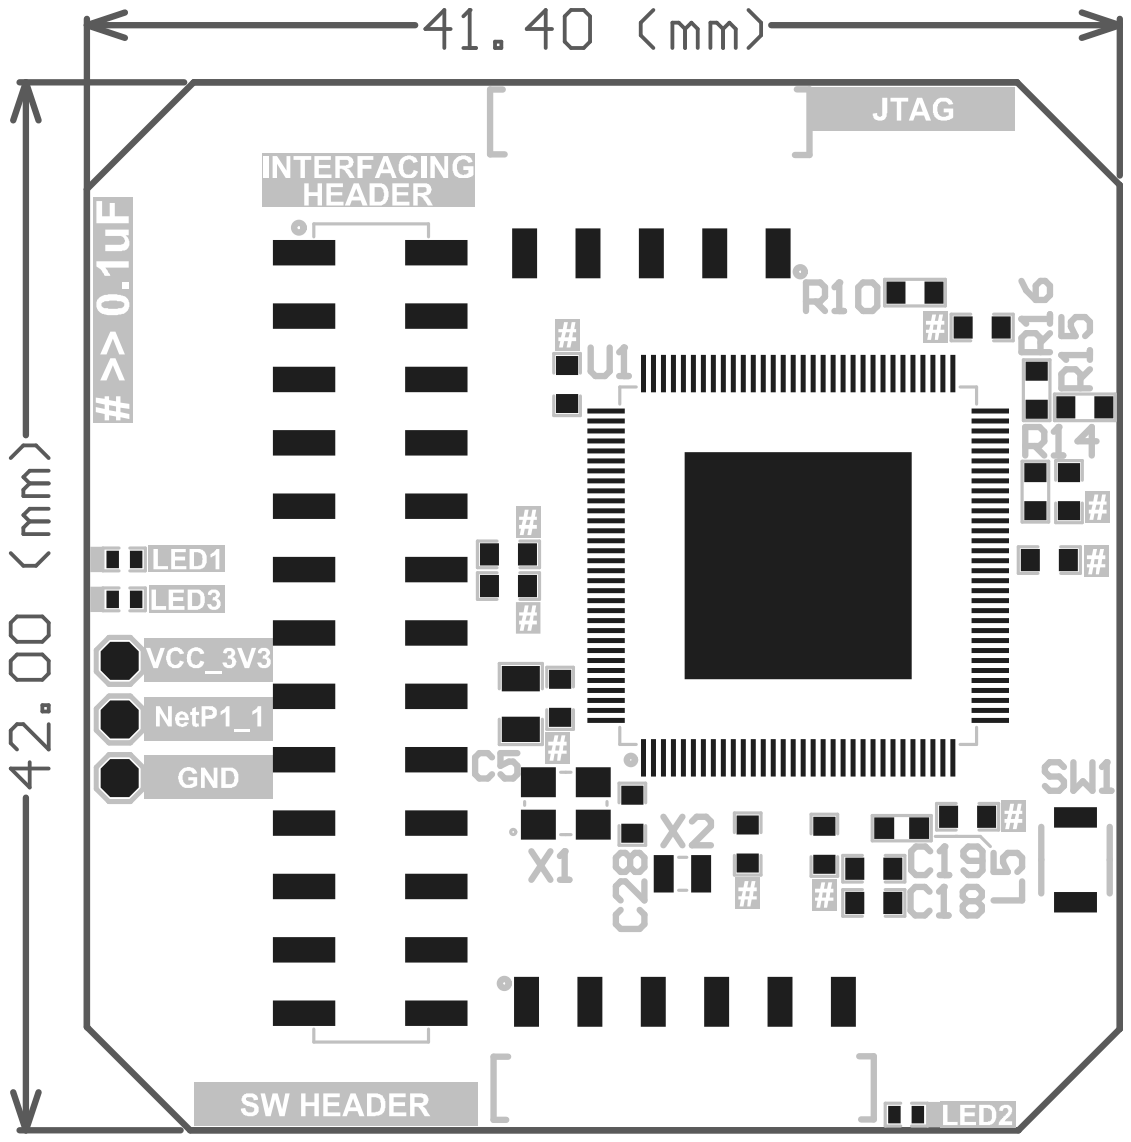
[picture p51: page 1]

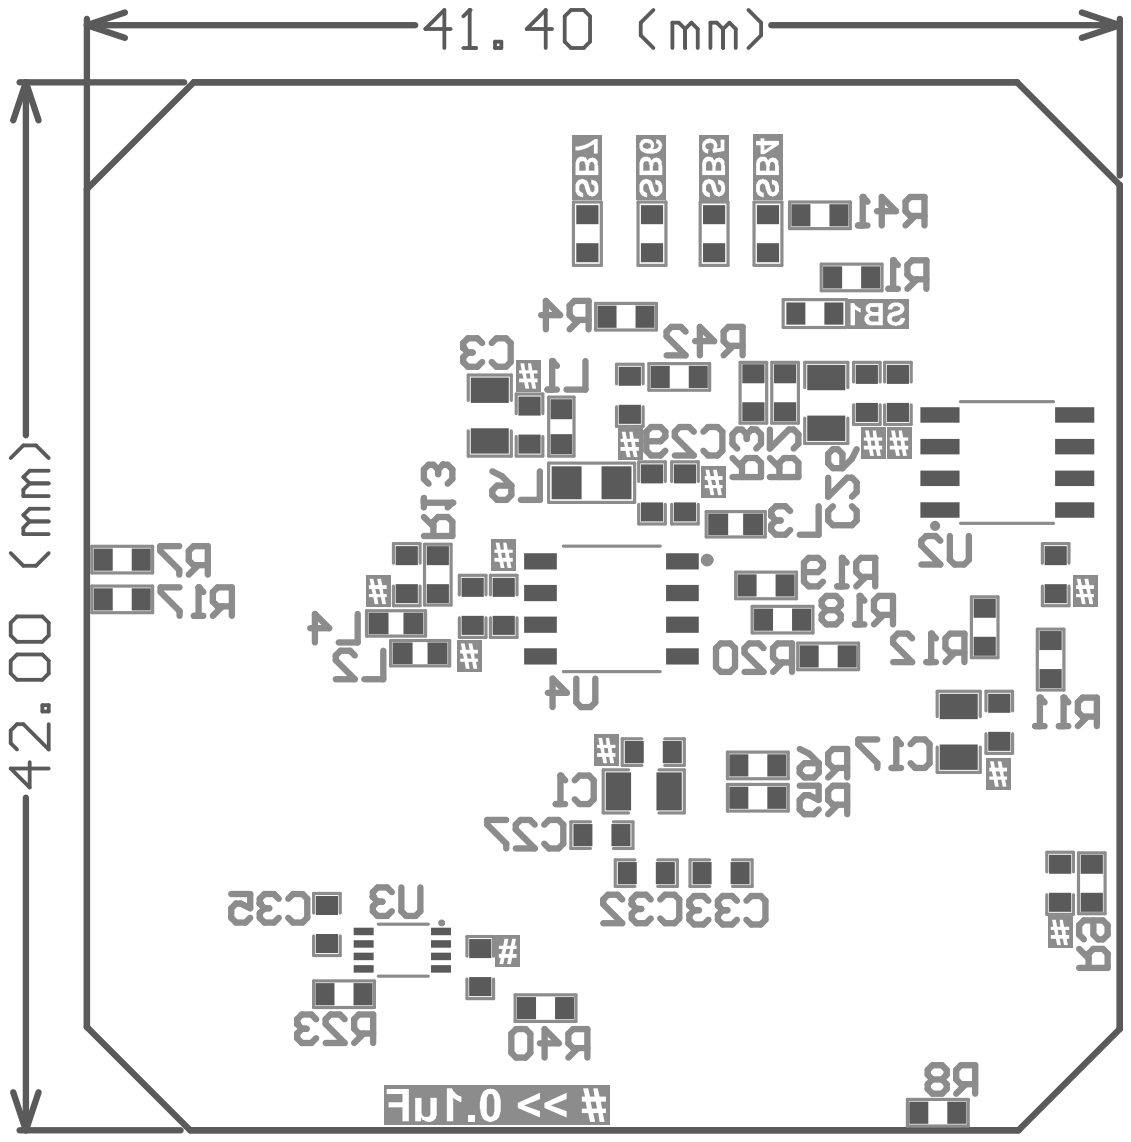
[picture p52: page 2]
