eSpark-Backup/christian-raun-ethercat-design/(list of files, drawings)

Other design files:
Design-Files/ControlBoard-DesignFiles/Connector-Section.SchDoc
Design-Files/ControlBoard-DesignFiles/Control_Board.PrjPcb
Design-Files/ControlBoard-DesignFiles/ControlBoard_PCB.PcbDoc
Design-Files/ControlBoard-DesignFiles/Controller-Part-1.SchDoc
Design-Files/ControlBoard-DesignFiles/Controller-Part-2.SchDoc
Design-Files/ControlBoard-DesignFiles/Controller-Section.SchDoc
Design-Files/ControlBoard-DesignFiles/Encoder-Section.SchDoc
Design-Files/ControlBoard-DesignFiles/Level-Shifter-Section.SchDoc
Design-Files/ControlBoard-DesignFiles/Top-Sheet.SchDoc
Design-Files/InterfaceBoard-DesignFiles/Connector_Section.SchDoc
Design-Files/InterfaceBoard-DesignFiles/Interface_Board.PrjPcb
Design-Files/InterfaceBoard-DesignFiles/InterfaceBoard_PCB.PcbDoc
Design-Files/InterfaceBoard-DesignFiles/MCU-Power.SchDoc
Design-Files/InterfaceBoard-DesignFiles/Power-Section.SchDoc
Design-Files/InterfaceBoard-DesignFiles/Pump-Power.SchDoc
Design-Files/InterfaceBoard-DesignFiles/Stepper-Driver.SchDoc
Design-Files/InterfaceBoard-DesignFiles/Top-Sheet.SchDoc
Documents/Client-Files/AnanasStepper2.0-hardware/PCB_Project/AnanasSTM32.PcbDoc
Documents/Client-Files/AnanasStepper2.0-hardware/PCB_Project/AnanasSTM32.PcbLib
Documents/Client-Files/AnanasStepper2.0-hardware/PCB_Project/AnanasSTM32.SchDoc
Documents/Client-Files/AnanasStepper2.0-hardware/PCB_Project/AnanasSTM32.SchLib
Documents/Client-Files/AnanasStepper2.0-hardware/PCB_Project/AnanasSTM32_PCB.PrjPcb
Documents/Client-Files/AnanasStepper2.0-hardware/PCB_Project/ATK-NEO-6M-V2.3/GPS_NEO-6M.PcbLib
Documents/Client-Files/AnanasStepper2.0-hardware/PCB_Project/ATK-NEO-6M-V2.3/GPS_NEO-6M.SCHLIB
Documents/Client-Files/AnanasStepper2.0-hardware/PCB_Project/LC-SOIC-8_150mil.PcbLib
Documents/Client-Files/AnanasStepper2.0-hardware/PCB_Project/V2S.PcbLib
Documents/Client-Files/AnanasStepper2.0-hardware/PCB_Project/V2S.SCHLIB
Library-File/Chris_R.PcbLib
Library-File/Chris_R.SchLib
