eSpark-Backup/christian-raun-ethercat-design/(commit log)

2021-07-29 Client Files Uploaded
    [AnanasSTM32-A4950-4-2.PcbDoc.pcbdoc]
2021-09-09 Branch for New Hardware Design Approach
    [AnanasSTM32-A4950-4-2.PcbDoc.pcbdoc]
2021-09-10 Parts list added having main parts of this project.
    [Parts List.xlsx]
2021-09-10 Component List Modified
    [Parts List.xlsx]
2021-09-14 Blueprints of Christian Schematic
2021-09-14 Hierarchy Changed
    [Parts List.xlsx]
2021-09-15 Part Selection revised and EtherCAT research doc added.
    [Parts List - Revised.xlsx]
2021-09-16 Part list updated. word doc also updated with new ICs and comparison of XMC and AMIC.
    [Parts List - Revised.xlsx]
2021-09-17 Part list updated
    [Parts List - Revised.xlsx]
2021-09-17 Parts List adjusted
    [Parts List - Revised.xlsx]
2021-09-18 Updated Library
    [Chris_R.PcbLib, Chris_R.SchLib, Parts List - Revised.xlsx]
2021-09-20 Added level translator IC and changes buck regulator in part list.
    [Parts List - Revised.xlsx]
2021-09-21 Power Section and Connection Section completed. Controller Section in progress. Library Files updated.
    [Chris_R.PcbLib, Chris_R.SchLib, Connector-Section.SchDoc, Controller-Part-1.SchDoc, Controller-Part-2.SchDoc, Controller-Section.SchDoc, EtherCAT_Project.PrjPcb, Power-Section.SchDoc]
2021-09-22 Controller section added. Stepper driver in progress. Library updated.
    [Chris_R.PcbLib, Chris_R.SchLib, Connector-Section.SchDoc, Controller-Part-1.SchDoc, Controller-Part-2.SchDoc, Controller-Section.SchDoc, EtherCAT_Project.PrjPcb, MOSFET-Drive-Circuit.SchDoc]
2021-09-23 TMC2022 design Completed. Encoder, level shifter, LEDs & optocoupler added.
    [Chris_R.PcbLib, Chris_R.SchLib, Connector-Section.SchDoc, Controller-Part-1.SchDoc, Controller-Part-2.SchDoc, EtherCAT_Project.PrjPcb, Level-Shifter-Section.SchDoc, Motor-Control-Section.SchDoc]
2021-09-24 added harness and completed remaining connections. Library updated.
    [Chris_R.PcbLib, Chris_R.SchLib, Connector-Section.SchDoc, Controller-Part-1.SchDoc, Controller-Part-2.SchDoc, EtherCAT_Project.PrjPcb, Level-Shifter-Section.SchDoc, Power-Section.SchDoc]
2021-09-27 level shifter, stepper motor and controller section connections updated.
    [Chris_R.PcbLib, Chris_R.SchLib, Connector-Section.SchDoc, Controller-Part-1.SchDoc, Controller-Part-2.SchDoc, Encoder-Section.SchDoc, EtherCAT_Project.PrjPcb, Level-Shifter-Section.SchDoc]
2021-09-28 Optocoupler replaced by MOSFET and top sheets completed.
    [Chris_R.PcbLib, Chris_R.SchLib, Connector-Section.SchDoc, Controller-Part-1.SchDoc, Controller-Part-2.SchDoc, Controller-Section.SchDoc, Encoder-Section.SchDoc, EtherCAT_Project.PrjPcb]
2021-09-29 errors removed and schematic reviewed.
    [Chris_R.SchLib, Connector-Section.SchDoc, Controller-Part-1.SchDoc, Controller-Part-2.SchDoc, Controller-Section.SchDoc, Encoder-Section.SchDoc, EtherCAT_Project.PrjPcb, Level-Shifter-Section.SchDoc]
2021-09-29 Top sheet Block Diagram Adjusted
    [Connector-Section.SchDoc, Controller-Part-1.SchDoc, Controller-Part-2.SchDoc, Controller-Section.SchDoc, Encoder-Section.SchDoc, Level-Shifter-Section.SchDoc, MCU-Power.SchDoc, Power-Section.SchDoc]
2021-09-29 Generated design PDF
    [EtherCAT_Project.PrjPcb]
2021-10-01 12V regulator, power and controller sheets modified
    [Controller-Section.SchDoc, EtherCAT_Project.PrjPcb, Power-Section.SchDoc, Pump-Power.SchDoc, Top-Sheet.SchDoc]
2021-10-01 Latest library And Schematic.
    [Chris_R.PcbLib, Chris_R.SchLib, Connector-Section.SchDoc, Controller-Part-1.SchDoc, Controller-Part-2.SchDoc, Controller-Section.SchDoc, Encoder-Section.SchDoc, EtherCAT_Project.PrjPcb]
2021-10-02 Reference Design
    [AnanasSTM32.CSV, AnanasSTM32.PcbDoc, AnanasSTM32.PcbLib, AnanasSTM32.SchDoc, AnanasSTM32.SchLib, AnanasSTM32_PCB.PrjPcb, GPS_NEO-6M.PcbLib, GPS_NEO-6M.SCHLIB]
2021-10-02 Latest files Footprint Error
    [Chris_R.PcbLib, Chris_R.SchLib, Connector-Section.SchDoc, Controller-Part-1.SchDoc, Controller-Part-2.SchDoc, Controller-Section.SchDoc, Encoder-Section.SchDoc, EtherCAT_Project.PrjPcb]
2021-10-02 PCB Parts Placement acc to sample:2
    [AnanasSTM32.PcbDoc, Controller-Part-2.SchDoc, EtherCAT_Project.PrjPcb, MCU-Power.SchDoc, RAUN_PCB.PcbDoc, Stepper-Driver.SchDoc]
2021-10-05 schematic modified. Diag pin added.
    [Connector-Section.SchDoc, Controller-Part-2.SchDoc, Encoder-Section.SchDoc, EtherCAT_Project.PrjPcb, Level-Shifter-Section.SchDoc, MCU-Power.SchDoc, Power-Section.SchDoc, Pump-Power.SchDoc]
2021-10-06 Latest library and Schematic
    [Chris_R.PcbLib, Chris_R.SchLib, Connector-Section.SchDoc, Controller-Part-1.SchDoc, Controller-Part-2.SchDoc, Controller-Section.SchDoc, Encoder-Section.SchDoc, Level-Shifter-Section.SchDoc]
2021-10-07 Components replaced and updated in schematic.
    [Chris_R.PcbLib, Chris_R.SchLib, Connector-Section.SchDoc, Controller-Part-1.SchDoc, Controller-Part-2.SchDoc, Level-Shifter-Section.SchDoc, MCU-Power.SchDoc, Pump-Power.SchDoc]
2021-10-07 PCB Parts Placement
    [AnanasSTM32.PcbDoc, Controller-Part-2.SchDoc, Pump-Power.SchDoc, RAUN_PCB.PcbDoc, Stepper-Driver.SchDoc]
2021-10-07 Latest BOM Digikey
    [Digikey_BOM.xlsx, EtherCAT_Project.PrjPcb, EtherCAT_Project.xlsx]
2021-10-07 PCB Designing.
    [Connector-Section.SchDoc, Controller-Part-1.SchDoc, Controller-Part-2.SchDoc, Controller-Section.SchDoc, Encoder-Section.SchDoc, EtherCAT_Project.PrjPcb, Level-Shifter-Section.SchDoc, MCU-Power.SchDoc]
2021-10-08 Schematic for RJ45 connector
    [Connector-Section.SchDoc, Connector_Section.SchDoc, EtherCAT-Daughter.PrjPcb]
2021-10-08 Folder Hierarchy changed
    [Connector-Section.SchDoc, Connector_Section.SchDoc, Controller-Part-1.SchDoc, Controller-Part-2.SchDoc, Controller-Section.SchDoc, Encoder-Section.SchDoc, EtherCAT-Daughter.PrjPcb, EtherCAT_Project.PrjPcb]
2021-10-08 Latest BOM
    [BOM_LCSC.xlsx, Chris_R.SchLib, Digikey_BOM.xlsx]
2021-10-09 Schematic and PCB Parts Placement and Routing
    [Connector_Section.SchDoc, Daughter_PCB.PcbDoc, EtherCAT-Daughter.PrjPcb, RAUN_PCB.PcbDoc]
2021-10-09 Main and Daughter schematic sections separated.
    [Connector-Section.SchDoc, Connector_Section.SchDoc, EtherCAT-Daughter.PrjPcb, EtherCAT_Project.PrjPcb, MCU-Power.SchDoc, MOSFET-Drive-Circuit.SchDoc, Motor-Control-Section.SchDoc, Power-Section.SchDoc]
2021-10-11 Connector and RJ45 added in Library
    [Chris_R.PcbLib, Chris_R.SchLib]
2021-10-12 Connectors replaced. Schematic and PCB updated.
    [Chris_R.PcbLib, Chris_R.SchLib, Connector-Section.SchDoc, Connector_Section.SchDoc, Controller-Part-1.SchDoc, Controller-Part-2.SchDoc, Controller-Section.SchDoc, Daughter_PCB.PcbDoc]
2021-10-12 Chinese supplier quote added to LCSC BOM. Separate Altium generated BOMs added.
    [BOM_LCSC.xlsx, EtherCAT-Daughter-BOM.xlsx, EtherCAT_main_BOM.xlsx]
2021-10-12 PCB Parts Placement in Main Board
    [Controller-Part-1.SchDoc, Controller-Part-2.SchDoc, RAUN_PCB.PcbDoc]
2021-10-13 Parts Placement in Daughter Board
    [Daughter_PCB.PcbDoc, RAUN_PCB.PcbDoc]
2021-10-13 Digikey BOM of main board(incomplete)
    [Chris_R.SchLib, Connector-Section.SchDoc, EtherCAT_Project.PrjPcb, EtherCAT_main_DigiBOM.xlsx, RAUN_PCB.PcbDoc]
2021-10-13 Changed Naming Convention
    [Connector-Section.SchDoc, Connector_Section.SchDoc, ControlBoard_PCB.PcbDoc, Control_Board.PrjPcb, Controller-Part-1.SchDoc, Controller-Part-2.SchDoc, Controller-Section.SchDoc, Encoder-Section.SchDoc]
2021-10-13 Changes in library, schematic and PCB.
    [AnanasSTM32.PcbDoc, Chris_R.PcbLib, Chris_R.SchLib, Connector-Section.SchDoc, ControlBoard_PCB.PcbDoc, Control_Board.PrjPcb, Controller-Part-1.SchDoc, Controller-Part-2.SchDoc]
2021-10-14 programming and arduino connectors replaced in schematic. Lib updated.
    [Chris_R.PcbLib, Chris_R.SchLib, Connector-Section.SchDoc, Connector_Section.SchDoc, EtherCAT_Project.xlsx, Level-Shifter-Section.SchDoc, Top-Sheet.SchDoc]
2021-10-14 Parts placement in main and daughter board
    [Connector_Section.SchDoc, ControlBoard_PCB.PcbDoc, InterfaceBoard_PCB.PcbDoc]
2021-10-15 Arduino header removed from bottom schematic and PCB.
    [ControlBoard_PCB.PcbDoc, Level-Shifter-Section.SchDoc]
2021-10-15 Renderings of controller and Interfacing board
    [ControlBoard_PCB.PcbDoc, InterfaceBoard_PCB.PcbDoc]
2021-10-16 Partial Review of Schematic
    [Connector_Section.SchDoc, Encoder-Section.SchDoc, Level-Shifter-Section.SchDoc, MCU-Power.SchDoc, Pump-Power.SchDoc, Stepper-Driver.SchDoc, Top-Sheet.SchDoc]
2021-10-16 Latest Library
    [Chris_R.PcbLib, Chris_R.SchLib]
2021-10-18 Schematic corrected and PCB updated. Lib also updated.
    [Chris_R.SchLib, Connector-Section.SchDoc, Connector_Section.SchDoc, ControlBoard_PCB.PcbDoc, Control_Board.PrjPcb, Controller-Part-1.SchDoc, Controller-Part-2.SchDoc, Encoder-Section.SchDoc]
2021-10-18 Routing and LCSC BOM of Both boards
    [Altiumgenerated_Control_Board.xlsx, Altiumgenerated_Interface_Board.xlsx, ControlBoard_PCB.PcbDoc, LCSC_Control_Board.xlsx, LCSC_Interface_Board.xlsx, Level-Shifter-Section.SchDoc]
2021-10-19 Step_Files of control and interface board
    [ControlBoard_PCB.PcbDoc, ControlBoard_PCB.step, InterfaceBoard_PCB.PcbDoc, InterfaceBoard_PCB.step]
2021-10-19 BOM Economization
    [LCSC_Control_Board.xlsx]
2021-10-19 PCB Routing of main board
    [ControlBoard_PCB.PcbDoc]
2021-10-21 PCB Routing of Control_board (Completed)
    [Connector-Section.SchDoc, ControlBoard_PCB.PcbDoc, ControlBoard_PCB.~(340).PcbDoc, Control_Board.PrjPcb, Controller-Part-1.SchDoc, Controller-Part-2.SchDoc, Controller-Section.SchDoc, Encoder-Section.SchDoc]
2021-10-22 Routing of Interface board ( incomplete)
    [Chris_R.PcbLib, ControlBoard_PCB.PcbDoc, ControlBoard_PCB.~(340).PcbDoc, InterfaceBoard_PCB.PcbDoc]
2021-10-23 Interface board routing(incomplete)
    [InterfaceBoard_PCB.PcbDoc]
2021-10-23 diff pairs assigned for EtherCAT signals. PCB updated
    [Connector-Section.SchDoc, Connector_Section.SchDoc, ControlBoard_PCB.PcbDoc, Controller-Part-2.SchDoc, InterfaceBoard_PCB.PcbDoc]
2021-10-24 Minor adjustments/changes done in Control Board PCB.
    [Connector-Section.SchDoc, ControlBoard_PCB.PcbDoc, Control_Board.PrjPcb, Controller-Part-1.SchDoc, Controller-Part-2.SchDoc, Controller-Section.SchDoc, Encoder-Section.SchDoc, Level-Shifter-Section.SchDoc]
2021-10-24 Client Files for Software CSV Import
    [10.1.csv]
2021-10-25 Diff pair rules updated
    [Connector-Section.SchDoc, Connector_Section.SchDoc, ControlBoard_PCB.PcbDoc, Control_Board.PrjPcb, Controller-Part-2.SchDoc, InterfaceBoard_PCB.PcbDoc]
2021-10-26 PCB Routing of interface board
    [Chris_R.SchLib, ControlBoard_PCB.PcbDoc, InterfaceBoard_PCB.PcbDoc, MCU-Power.SchDoc, Power-Section.SchDoc, Pump-Power.SchDoc, Stepper-Driver.SchDoc]
2021-10-28 Routing of interface PCB
    [Connector_Section.SchDoc, ControlBoard_PCB.PcbDoc, InterfaceBoard_PCB.PcbDoc, Interface_Board.PrjPcb]
2021-10-28 changes done in Control_board PCB acc to library changes
    [Chris_R.PcbLib, Chris_R.SchLib, Connector_Section.SchDoc, ControlBoard_PCB.PcbDoc, Controller-Part-1.SchDoc, Controller-Part-2.SchDoc, InterfaceBoard_PCB.PcbDoc, Level-Shifter-Section.SchDoc]
2021-11-02 Switch added in controller section
    [Chris_R.PcbLib, Chris_R.SchLib]
2021-11-03 Revert "Switch added in controller section"
    This reverts commit 3fce710f81bdcc92a712cd3ce016cf43e7e12f97.
    [Chris_R.PcbLib, Chris_R.SchLib]
2021-11-03 Placement of 3D of RJ45 and 2*13 Pin header and Routing
    [Chris_R.PcbLib, Chris_R.SchLib, Connector-Section.SchDoc, Connector_Section.SchDoc, ControlBoard_PCB.PcbDoc, ControlBoard_PCB.step, Control_Board.PrjPcb, InterfaceBoard_PCB.PcbDoc]
2021-11-04 Pin alignment of RJ45 header in Control and Interface board
    [Connector-Section.SchDoc, ControlBoard_PCB.PcbDoc, InterfaceBoard_PCB.PcbDoc]
2021-11-04 Review and minor changes in Control Board PCB.
    [Connector-Section.SchDoc, ControlBoard_PCB.PcbDoc, Control_Board.PrjPcb, Controller-Part-1.SchDoc, Controller-Part-2.SchDoc, Controller-Section.SchDoc, Encoder-Section.SchDoc, Level-Shifter-Section.SchDoc]
2021-11-05 Quantity= 5 LCSC BOM update kr diye han Controller Board and Interface Board
    [LCSC_Control_Board.xlsx, LCSC_Interface_Board.xlsx]
2021-11-06 Review of both PCB's done. Minor changes done.
    [Connector-Section.SchDoc, Connector_Section.SchDoc, ControlBoard_PCB.PcbDoc, ControlBoard_PCB.step, Controller-Part-1.SchDoc, Controller-Part-2.SchDoc, Controller-Section.SchDoc, Encoder-Section.SchDoc]
2021-11-08 Deliverables of control and interface Board
    [Connector-Section.SchDoc, Connector_Section.SchDoc, ControlBoard_PCB.DWG, ControlBoard_PCB.DXF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]
2021-11-09 #11 BOM Separate kr diye han Respective Folder me
    [Altium Generated BOM Control_Board.xlsx, Altiumgenerated_Control_Board.xlsx, Altiumgenerated_Interface_Board.xlsx, Digikey_BOM.xlsx, EtherCAT_main_DigiBOM.xlsx, Interface_Board.xlsx, LCSC_Control_Board.xlsx, LCSC_Interface_Board.xlsx]
2021-11-10 M20-8761346 Ye part add kr dia ha Library me or controller Board k BOM me
    [Chris_R.PcbLib, Chris_R.SchLib, LCSC_Control_Board.xlsx]
2021-11-10 PCB updated and fresh deliverables Generated for both boards
    [Chris_R.PcbLib, Chris_R.SchLib, Connector-Section.SchDoc, Connector_Section.SchDoc, ControlBoard_PCB.DWG, ControlBoard_PCB.DXF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]
2021-11-10 Controller Board k BOM me Male header ka link add kr dia ha Female header ki jaga
    [LCSC_Control_Board.xlsx]
2021-11-11 PCB Way BOM add kr dia ha Deliverables k folder me
    [PCB Way_Control_Board.xlsx, PCB Way_Interface_Board.xlsx]
2021-11-16 #8 Custom supplier ki price update kr di BOM me kuch parts out of stock han quotation me
    [LCSC_Control_Board.xlsx, LCSC_Interface_Board.xlsx]
2021-11-16 6-pin header added and Deliverables of interface board created
    [Chris_R.PcbLib, Chris_R.SchLib, Connector_Section.SchDoc, InterfaceBoard_PCB.DWG, InterfaceBoard_PCB.DXF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]
2021-11-17 @Urooj-naveed @faizi968 BOM me remarks put kr diye han kuch parts me issue ha @Urooj-naveed se wo discuss ho gaya ha Wo client se query krengi jo issue ha
    [BOM-ControlBoard.xlsx, BOM-InterfaceBoard.xlsx]
2021-11-20 Client Shared BOM queries answered and submitted
    [BOM-ControlBoard (1).xlsx, BOM-InterfaceBoard (1).xlsx]
2021-11-25 Interface Board BOM updated(4 pin header replace with C37208 )
    [ControlBoard_PCB.PcbDoc, LCSC_Interface_Board.xlsx]
2021-12-07 Control board BOM for 500 and 1000 boards added.
    [Altium Generated BOM Control_Board.xlsx, LCSC_CB_ 500.xlsx]
2021-12-07 BOM Updated to 500 and 1000 board Quantity #22
    [LCSC_Interface_Board-500.xlsx]
2021-12-08 BOM Review completed CAT24C256WI-GT3 is part ka link or price change hui ha BOM me
    [LCSC_CB_ 500.xlsx]
2021-12-13 BOM Changes Pending #24
    [LCSC_Interface_Board-500-100.xlsx, LCSC_Interface_Board-500.xlsx]
2021-12-14 Interface BOM reviewed and aliexpress shipping cost corrected in both BOMs.
    [LCSC_CB_ 500.xlsx, LCSC_Interface_Board-500-100.xlsx]
2022-01-01 #5 MTP125-1104S1 is part ki 3d BOdy add kr dia library me
    [Chris_R.PcbLib, Chris_R.SchLib]
2022-03-26 issue #30
    [ControlBoard_PCB.PcbDoc, Control_Board.PrjPcb, Controller-Part-2.SchDoc]
2022-03-31 Changes done acc: #31
    [Connector-Section.SchDoc, ControlBoard_PCB.PcbDoc, Control_Board.PrjPcb, Controller-Part-1.SchDoc, Controller-Part-2.SchDoc, Controller-Section.SchDoc, Encoder-Section.SchDoc, Interface_Board.PrjPcb]
2022-03-31 Hardware Testing files uploaded
    [Board Statuses.xlsx]
2022-03-31 Update Board Statuses.xlsx
    [Board Statuses.xlsx]
2022-04-02 Board documents file updated
    [Board Statuses.xlsx]
2022-04-03 Generated deliverables
    [ControlBoard_PCB.GBL, ControlBoard_PCB.GBO, ControlBoard_PCB.GBP, ControlBoard_PCB.GBS, ControlBoard_PCB.GTL, ControlBoard_PCB.GTO, ControlBoard_PCB.GTP, ControlBoard_PCB.GTS]
2023-06-23 Board Status Document in readme.md
